MauriceTZ/Cafebot/pi/tests/datos/arbol_taller_29oct.jpg

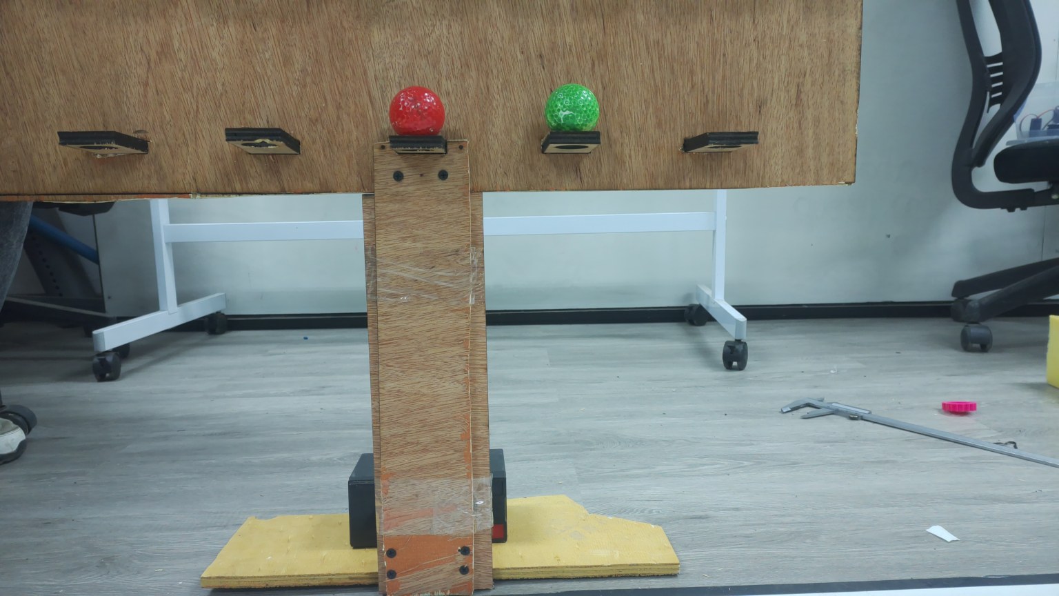
pi/tests/datos/arbol_taller_29oct.jpg
