MauriceTZ/Cafebot/docs/hardware.md

# Hardware

## Arquitectura

```
                 USB                         USB                  USB
 Arduino Mega ◄────────► Raspberry Pi 5 ◄──────────► LD06   ◄──────────► U2D2 ─► 6× XL430 (brazo)
  + shield 4M&9S          │  CSI: cámara                                (TTL,   + 2 compuertas (id 2, 13)  
  ├─ 4 motores + encoder  │  I2C: MPU9250 (usar giroscopio, no magnetómetro)   1 Mbps)
  ├─ 4 servos dirección   │  GPIO 16 (pin 36) + GND (pin 34): botón de inicio
  ├─ 1 inclinación de cámara (X 2; X 0 / X 1 quedaron libres: las compuertas son Dynamixel)
  └─ 4 sensores de línea QTR-1A (A8–A11)
```

| Pieza | Responsable | Notas |
|---|---|---|
| Mega | reflejos | PI por rueda, dirección, odometría, primitivas, freno por borde, watchdog. |
| Pi 5 | decisiones | Localización con mapa conocido, visión, brazo, misión, reloj de 8 min. |

## Botón de inicio (5 nov; antes GPIO 23)
GPIO 16 = **pin físico 36** del conector de 40 pines; el otro lado del botón a un **GND** (pin 34, justo al lado, o el
39). Sin resistencia: se usa el pull-up interno (suelto = 1, apretado = 0). Es un GPIO libre (no es I2C, SPI0 ni UART;
el MPU9250 usa los pines 3 y 5). La misión parte al SOLTAR el botón y descarta pulsos de menos de 50 ms (ruido de los
motores en el cable). Probarlo: `python3 -m tools.boton`. Necesita `python3-gpiozero` y `python3-lgpio` (vienen con
Raspberry Pi OS Bookworm; si no: `sudo apt install python3-gpiozero python3-lgpio`).

## Puertos USB en la Raspberry (vistos el 28 oct con `ls -l /dev/serial/by-id/`)

| Dispositivo | Chip USB | Sin reglas udev | Con `pi/system/99-cafebot.rules` |
|---|---|---|---|
| Arduino Mega (clon) | CH340 (`1a86`) | `/dev/ttyUSB1` | `/dev/cafebot-mega` |
| LD06 | CP2102 (`10c4`) | `/dev/ttyUSB0` | `/dev/cafebot-lidar` |
| U2D2 (brazo) | FTDI (`0403`) | otro `/dev/ttyUSB*` | `/dev/cafebot-u2d2` |

Los números `ttyUSB` dependen del orden en que se conectan: con las reglas instaladas no importa. Sin ellas (o si
un chip no calza con su regla), los drivers buscan el puerto por el fabricante del chip USB y avisan cuál usaron
(`cafebot/drivers/puertos.py`). 29 oct: no apareció `/dev/cafebot-u2d2` (la regla pedía el producto `6014`; ahora
basta el fabricante `0403`): reinstalar las reglas con
`sudo cp pi/system/99-cafebot.rules /etc/udev/rules.d/ && sudo udevadm control --reload && sudo udevadm trigger`.

## Raspberry nueva (o SD nueva)
31 oct: la SD murió. Lo que hay que hacer en una SD nueva (con Raspberry Pi OS **Bookworm o más nuevo**: la Pi 5 no
arranca con versiones anteriores; si la SD viene de una Pi 4, `sudo apt update && sudo apt full-upgrade` y reiniciar):
1. `git clone https://github.com/MauriceTZ/Cafebot ~/Cafebot`
2. `cd ~/Cafebot/pi && python3 -m venv --system-site-packages .venv && . .venv/bin/activate && pip install -r requirements.txt`
   (antes, con apt: `python3-numpy python3-scipy python3-opencv python3-picamera2 python3-pygame python3-smbus2`;
   numpy NO por pip: un numpy 2 en el venv rompe el cv2 de apt, 4 nov). Revisar
   `python3 -c "import numpy; print(numpy.__version__, numpy.__file__)"`: 1.x en `/usr/lib/python3/dist-packages`.
   El 4 nov el numpy 2 estaba en `~/.local/lib/python3.11/site-packages` (un `pip install --user` viejo, que se ve
   también desde el venv): borrar ahí `numpy*`, `scipy*`, `pygame*` y `opencv*`/`cv2`.
3. Reglas de los puertos: `sudo cp system/99-cafebot.rules /etc/udev/rules.d/ && sudo udevadm control --reload && sudo udevadm trigger`.
4. `sudo usermod -aG dialout $USER` y volver a entrar (sin eso no abre los puertos serie).
5. Comprobar: `rpicam-hello --list-cameras` (la cámara), `ls -l /dev/cafebot-*` (Mega, LiDAR y U2D2).
6. I2C en `raspi-config` solo si se usa el giroscopio.
La calibración que vive en la Pi (`pi/robot_local.json`, `pi/calibracion/`) se pierde con la SD: lo que quede bueno,
pasarlo a `config.py` o subirlo al repo. El perfil del brazo (`pi/brazos/`) ya está en el repo.
La Pi 5 necesita 5 V / 5 A: con menos (el 30 oct marcó 4,86 V y avisos de bajo voltaje) limita la corriente de los
USB y el LiDAR, el Mega o el U2D2 pueden desconectarse solos.

## Pines del Mega (`firmware/mega_cafebot/config.h`)

| Rueda | Ubicación (verificada) | Enc A | Enc B | PWM | DIR1 | DIR2 | Servo | Offset |
|---|---|---|---|---|---|---|---|---|
| M1 | delantera der | 18 | 31 | 12 | 34 | 35 | 6 | 89 |
| M2 | delantera izq | 19 | 38 | 8 | 37 | 36 | 10 | 87 |
| M3 | trasera der | 3 | 49 | 9 | 43 | 42 | 13 | 87 |
| M4 | trasera izq | 2 | A1 | 5 | A4 | A5 | 45 | 90 |

Sensores de línea: 4 × QTR-1A analógicos en **A8, A9, A10, A11** (DI, DD, TI, TD) por el conector *Analog IO*
del shield (S/V/G); **A1, A4 y A5 los usa el motor M4**: ver `docs/ir.md`. Cabezal de la cámara (31 oct): 2 × SG90,
**inclinación en el pin 44 (PL5)** = `X 2`, **giro en el pin 4 (PG5)** = `X 3` (desactivado en `AUX_ACTIVO`: falla).
Compuertas, por confirmar: 46 y 11 (`X 0`, `X 1`; en el modelo de Fusion son Dynamixel). Los pines 20/21 (SDA/SCL)
también tienen interrupción y están libres si no se usa I2C en el Mega.

## Geometría del modelo de Fusion (31 oct, `description/fusion/exportar_geometria.py`)
Sistema del robot: x adelante, y a la izquierda, z arriba, origen en el centro de la base sobre el suelo. Alturas
corregidas −0,57 cm porque el modelo tiene ruedas de 64 mm (las de verdad dan 52,6 mm). **[CONFIRMAR con huincha]**

| Qué | x | y | z | En la config |
|---|---|---|---|---|
| Lente de la cámara (X 2 = 90, mirando adelante) | 11,1 cm | −5,3 cm (derecha) | 36,7 cm | `camara.x/y/z` |
| Eje de inclinación de la cámara (SG90, horizontal) | 8,4 cm | | 36,9 cm | `camara.eje_pitch_x/z` |
| Eje de giro de la cámara (SG90, vertical) | 9,1 cm | −6,8 cm | | `camara.eje_yaw_x/y` |
| Eje de la base del brazo (placa de la base) | 7,65 cm | +6,3 cm (izquierda) | 31,3 cm en el modelo; **35,2 medido** (31 oct: garra horizontal a 70 cm con el brazo vertical) | `mision.brazo_x/y/z` |
| LiDAR | 15,75 cm | 0 | ~5 cm | `geometria.lidar_x/z` |

Si la base del brazo está 4 cm más alta que en el modelo porque la tapa de la base lo está, la cámara (montada en
la misma tapa) también: medir la altura del lente y corregir `camara.z` y `eje_pitch_z`.

Ojo con izquierda/derecha: en el modelo, la pieza "Compuerta trasera izquierda" queda del lado que con x adelante
es la DERECHA. Si en el robot la cámara está a la izquierda del brazo, cambiar el signo de `camara.y`, `eje_yaw_y` y
`mision.brazo_y`.

## Medidas de la base
Ruedas Ø53 mm, trocha 217 mm, entre ejes 223 mm, 800 pulsos/vuelta de rueda en el flanco
de subida de A (1600 con `ENCODER_X2`). Reductora 1:8.

## Checklist de puesta en marcha (ruedas en el aire)
1. **Encoders.** Escribir `ED` (pone en cero el diagnóstico), girar **cada rueda a mano exactamente 1 vuelta hacia adelante** y escribir `ED` otra vez. Para cada rueda se ve `subida/bajada`:
   - Ambos ≈ **+800** → cuadratura sana: se puede usar `EM 2` (doble resolución; queda guardado).
   - Ambos ≈ −800 → encoder invertido: cambiar `Mx_INV_ENC` en config.h.
   - Signos **opuestos** (p. ej. +800 / −800) → A y B no están desfasados 90° (o hay ruido/rebote en A): quedarse en `EM 1`. En x1 solo cuenta el flanco de subida, igual que v0.
   - Muy distinto de 800 → revisar `PULSOS_POR_REVOLUCION` o el cableado.
   Con las ruedas en el aire, `DONE` siempre muestra la distancia pedida: solo cuenta pulsos, no sabe cuánto avanzó de verdad. La prueba real es la vuelta a mano (o `A 1000` en el piso, con huincha).
2. `V 100 0` (repetir): las 4 ruedas hacia adelante. Si alguna va al revés, `Mx_INV_MOTOR`.
3. **Dirección, en este orden** (con las ruedas en el aire):
   1. **`L 45 200`** (no `L 90`: a ±90° una rueda girada a la izquierda y una girada a la derecha quedan en la misma línea y no se distinguen a simple vista). Vistas desde arriba (frente arriba), las 4 ruedas deben quedar **paralelas, con la punta delantera hacia la izquierda** ( \\ \\ ). La que quede en la otra diagonal ( / ) → cambiar su signo en `SIGNO_SERVO`. Si una rueda no responde como se espera, `Y i 1200` mueve solo el servo i (0 = M1 … 3 = M4) para comprobar qué rueda mueve cada pin. *No* usar `W 90` para esto.
   2. Anotar en `ESQUINA_X` / `ESQUINA_Y` dónde está físicamente M1…M4 (delantera/trasera, izquierda/derecha).
   3. `W 90`: las ruedas forman un **rombo** (cada una perpendicular a la línea hacia el centro) y el robot gira a la **izquierda** (antihorario visto desde arriba). Si quedan en X apuntando al centro → `SIGNO_GIRO -1`.
4. **Calibrar los servos de dirección (HS-311) en microsegundos** — corrige el desfase del estriado sin desarmar nada.
   Con teclado (6 nov): `python3 -m tools.direccion` (prueba +45°, invierte el sentido de una rueda con x, ajusta
   −90/0/+90 con las flechas y guarda en la EEPROM; sin subir firmware). A mano:
   - `Y` muestra la tabla actual (µs para -90°, 0°, +90° de M1..M4).
   - Para cada rueda `i` (0 = M1 … 3 = M4): `Y i 1450`, `Y i 1460`… hasta que quede **paralela al chasis** (usar una regla apoyada en el costado). Anotar el valor y fijarlo: `YS i 0 <us>`.
   - Igual para +90° (`YS i 1 <us>`) y -90° (`YS i -1 <us>`), con una escuadra contra el chasis.
   - Si un servo no llega a 90° exactos, calibrar las 4 a un ángulo menor **común** (p. ej. 88°, medido con transportador) y poner ese valor en `SERVO_ANG_CAL_DEG` (config.h): lo importante es que las 4 queden paralelas; la odometría usa el ángulo real.
   - `YG` guarda en EEPROM (sobrevive al apagado y a recargar el firmware). `YD` vuelve a los valores por defecto.
   - Después, `L 90 200`: las 4 ruedas quedan paralelas, rodando hacia la izquierda. Dos quedan a +90 y dos a −90
     (es a propósito: así el arrastre de las L de aluminio no hace girar la base; ver PASO 1b de `config.h`).
   - **Torque del cangrejo** (29 oct): desde recto, `L 90 50` y luego `L 0 50`, mirando si la base gira al
     reposicionarse las ruedas. Probar los patrones con `LE 1`, `LE 2`, `LE 3` (y `LE 0` = como antes, para
     comparar) y dejar en `CANGREJO_ESPEJO_DEF` el que no gire. Una marca en el piso junto a una esquina ayuda.
5. En el piso: `A 1000` + huincha → diámetro de rueda. `W 360` → `CINEMATICA_D_GIRO_Z`.
6. `J`: si oscila, bajar `kp`; si no llega a la velocidad, subir `kff` o `PWM_ARRANQUE`.

## LiDAR
Para ver **cajas (90 mm) y albercas (90 mm)** tiene que ir **por debajo de 90 mm**. Plan: al frente de la base, a ~8 cm, con ~180° de vista (`ConfigLD06.x_m = 0.16`, `fov_deg = 95`). Con solo 1 cm de margen, **montarlo nivelado**: 1° de inclinación hacia arriba sube el haz 5 cm a 3 m y deja de ver las cajas lejanas. Si se puede, 6 cm es más seguro.
Más arriba solo ve los árboles (y al público). Configurar su posición y orientación en
`ConfigLD06` (`pi/cafebot/drivers/ld06.py`).

## IMU
El magnetómetro no sirve cerca de motores y estructuras metálicas. Usar el giroscopio
(calibrar el sesgo con el robot quieto al inicio). Muchos "MPU9250" son clones MPU6500
sin magnetómetro.
