MauriceTZ/Cafebot/docs/cosecha.md

# Cosecha de prueba: cámara + LiDAR + brazo (`python3 -m tools.cosecha`, en `pi/`)

Robot quieto frente a UN árbol (puede avanzar y retroceder, y correrse de lado): la cámara encuentra las pelotas, el
LiDAR mide el pie del árbol, se calcula la posición 3D de cada grano y el brazo agarra el elegido (o el más cercano)
y lo deja en la canasta de su categoría.

Código: `pi/cafebot/vision/` — `camara_modelo.py` (cámara estenopeica completa: proyección y rayos), `arbol.py`
(forma del árbol y medida del pie con el LiDAR), `granos.py` (detección, ajuste, proyección inversa, color,
calibración), `sintetica.py` (fotos y LiDAR simulados). Herramienta: `pi/tools/cosecha.py`. Pruebas sin hardware:
`python3 -m tests.test_cosecha`.

## Cómo funciona (sin red neuronal: la escena es conocida)

1. **Detectar.** Píxeles saturados (madera 85–110 de saturación, pelotas 150–190; `camara.sat_min` = 130), manchas
   redondas. El soporte tapa la parte de abajo de cada pelota (la cámara está más abajo que los granos) y el brillo
   deja una muesca: el círculo se ajusta (RANSAC + ajuste geométrico) solo con los puntos del borde que están sobre la
   envolvente convexa y fuera de los tramos rectos. Error en fotos sintéticas: < 1 px en centro y radio, también
   en los casquetes de la fila alta.
2. **Asignar y ajustar.** Cada mancha va al soporte cuya proyección queda más cerca, y se ajustan por mínimos
   cuadrados la pose del árbol (x, y, ángulo) y una corrección de la cámara (inclinación, yaw, roll) con la medida
   del LiDAR como "prior": eso es la fusión cámara + LiDAR. Sin calibrar, la cámara puede corregirse ±3–4° (manda
   el LiDAR en lo que la foto no distingue, p. ej. árbol corrido vs cámara girada); calibrada, ±0,6°. Sin calibrar,
   antes se busca la inclinación en ±30° (y, sin LiDAR, la distancia en ±20 cm de `--frente`): si la cámara está
   montada a otro ángulo del que dice la config, lo avisa y usa el que calza ("la cámara está inclinada ~22°...").
3. **Proyección inversa.** Rayo de cada pelota ∩ plano vertical de los granos (`p_rayo`). La posición final de cada
   grano es la de su soporte en el árbol ajustado, corregida hacia lo que se vio de esa pelota (sirve para un árbol
   de prueba que no calza exacto con su modelo). Se guarda en el marco del ÁRBOL: si el robot se acerca, el LiDAR
   vuelve a ubicar el pie y con eso cada grano (de cerca la cámara ya no ve el árbol).
4. **Color.** En el círculo inscrito en lo que se ve de la pelota (lejos del soporte y del fondo). Con referencias
   (clic + tecla 1..7): Lab contra las muestras, el clasificador de Pablo, con "no sé". Sin referencias: por matiz,
   provisorio, con confianza 0,6 (menor que la de la misión, 0,7: no se agarra nada hasta enseñar los colores o
   bajar `--confianza`). Un soporte sin mancha de color es VACIO (sin referencias no se distingue de NEGRO).
5. **Brazo.** `BrazoXL430.recoger`: abrir → 6 cm antes → entrar → cerrar (si cierra del todo: no había grano) →
   subir → retroceder → canasta (`deposito_maduro` / `deposito_sobremaduro`) → abrir → espera. Con la postura
   `transporte` grabada, para ir y volver de la canasta primero se pliega sin girar la base, gira plegado y recién
   ahí se estira (no barre la cámara).

## Antes de la primera prueba

| Qué | Cómo |
|---|---|
| Cabezal de la cámara (31 oct) | La cámara va en un cabezal de 2 SG90: inclinación con `X 2` (pin 44), giro con `X 3` (desactivado: falla, mira adelante). Con el lente a ~37 cm y ~18° hacia arriba entran los 16 soportes desde 0,55–0,65 m (simulado). El modelo (`camara.cabezal`) mueve el lente con la inclinación alrededor del eje del servo. **Antes:** comprobar el sentido con `X 2 70` y `X 2 110` en la consola del Mega; si con 110 la cámara mira hacia ABAJO, poner `camara.pitch_por_grado` = −1 en `robot_local.json`. |
| Intrínsecos (recomendado) | `python3 -m tools.camara intrinseca --tablero 9x6 --cuadro 0.025` con un tablero de ajedrez impreso: debe dar fx ≈ 1183 a 1536×864. Si da ~1690, la cámara está en el modo recortado del sensor (el driver ahora pide el campo completo, `MODO_SENSOR`). |
| Medidas en `pi/robot_local.json` | `camara.x/y/z` (lente), `mision.brazo_x/y/z` (eje de la base del brazo; z = base sobre el suelo), `geometria.lidar_x`. |
| Árbol de prueba | `python3 -m tools.cosecha --arbol taller --crear-arbol` y editar `pi/arboles/taller.json` (abajo). |
| Brazo | Perfil calibrado (docs/brazo.md) y posturas `descanso`, `deposito_maduro`, `deposito_sobremaduro` y, opcional, `transporte` (`python3 -m tools.brazo leer`, tecla G). Si una canasta está justo detrás (180°), ampliar el límite de la base (`tools.brazo limites`): de fábrica es ±150°. |
| Exposición | `python3 -m tools.camara exposicion --dist 0.6` con la luz del lugar. |

## Sesión típica

| Paso | Tecla | Qué mirar |
|---|---|---|
| 1. Robot frente al árbol, el frente a ~60 cm del pie | | |
| 2. Medir | ESPACIO | Círculos sobre las pelotas, "error" < 2 px. Mensajes: "la foto y el LiDAR no coinciden", "OJO: calza igual corrido una columna". |
| 3. Calibrar la cámara | C | En 3–4 posiciones del robot (moverlo ±10 cm, ESPACIO + C cada vez): se promedia y se guarda en `robot_local.json`. Con el Mega conectado, hacer al menos una C con otro ángulo del servo (I o K 4–5 veces = 8–10°, ESPACIO + C): así se mide cuántos grados gira la cámara por grado de `X 2` y la misión puede pedir cualquier inclinación (`camara.servo_de_pitch`). I/K mueven el servo de a 2°; sin el Mega solo cambian el modelo. |
| 4. Enseñar colores | clic + 1..7 | Todas las clases, también NEGRO (6) y VACIO (7, un soporte sin grano). Se guardan en `pi/calibracion/referencias.json`. |
| 5. Acercarse | A | El frente queda a `mision.holgura_agarre_m` (6 cm) del pie; el LiDAR vuelve a ubicar el árbol. Sin Mega (`--sin-mega`), A, R y las flechas dicen cuánto mover el ÁRBOL a mano; después, **U** lo vuelve a ubicar con el LiDAR (sin foto, sirve de cerca): un error de 1,5 cm a mano serían 1,5 cm de error en cada grano. |
| 6. Probar sin agarrar | clic + P | La garra queda 6 cm antes del grano: ¿apunta a él? (V vuelve.) |
| 7. Agarrar | G / T | G: el elegido o el seguro y alcanzable más cercano. T: todos (fila alta primero). ESC detiene. |
| 8. Volver y revisar | R + ESPACIO | Los agarrados ya no están. S guarda fotos + análisis en `pi/capturas/`. |

Granos de los costados: ← / → corren el robot 2 cm de lado (cangrejo); el árbol se vuelve a ubicar solo.

**Calibración con el brazo (la más directa, opcional):** con la foto analizada y el brazo fuera de ella, O suelta el
brazo; llevar la garra a mano hasta un grano detectado, clic en ese grano y M; repetir con 4–8 granos en distintas
filas y columnas; N calcula la pose COMPLETA de la cámara (también la posición del lente) respecto del brazo. Así
los errores de montaje del LiDAR o de `brazo_x/y/z` no se suman: con la cámara calibrada con el brazo, lo que la foto
le corrige al LiDAR se sigue aplicando al acercarse (simulado: LiDAR corrido 1,5 cm, agarres a < 5 mm). Con C, en
cambio, la referencia es el LiDAR.

En la imagen: rojo = maduro, azul = sobremaduro, verde = verde, gris = vacío, amarillo = no sé (no se toca),
círculo blanco = mancha detectada y su zona de color, cruz magenta = mancha que no calza con ningún soporte,
"lejos" = el brazo no lo alcanza desde aquí. Abajo a la derecha, vista desde arriba (relleno = alcanzable).

## Alcance del brazo (cinemática del perfil de fábrica, árbol de competencia, robot centrado)

| Base del brazo | Holgura 6 cm: alta / media / baja |
|---|---|
| 25 cm (montaje del 29 oct) | ninguno / los 2 del centro / los 5 |
| 30–33 cm (31,3 cm según el modelo de Fusion, 31 oct) | ninguno / 4 del centro / los 5 |
| **35,2 cm (medido en el robot, 31 oct)** | ninguno (ni con holgura 3 cm) / 4 del centro / los 5 |
| 36 cm | solo el del centro (con holgura ≤ 4 cm) / 4 del centro / los 5 |
| 37 cm o más | el que está frente al brazo / 4 del centro / los 5 |

**Medida del 31 oct:** con el brazo vertical y la garra horizontal, la garra llega a 70 cm del suelo. Como del eje
de la base a la garra hay 6,71 + 10,7 + 10,7 + 6,7 = 34,8 cm, la base está a ~35,2 cm (el modelo de Fusion dice
31,3). La fila alta tiene el centro del grano a 70,7 cm: **la garra horizontal no llega ni justo encima de la base**,
y el grano está 10 cm más adelante, además de tener que levantarlo 1–2 cm para sacarlo del soporte. Con un
suplemento de ~2 cm (base a ≥ 37 cm) se alcanza la fila alta frente al brazo con la holgura de 6 cm; los de los
costados, corriéndose de lado (cangrejo, como `mision.estaciones_y`). Ojo con el cubo de 45 cm al partir: el brazo
plegado no puede subir más de ~8–10 cm sobre la base.

## Árbol de prueba (`pi/arboles/<nombre>.json`)

| Campo | Qué es |
|---|---|
| `z_cara` | Altura (m) de la cara de ARRIBA de los soportes de cada fila (`baja`, `media`, `alta`). |
| `columnas_y` | Posición lateral (m, + = izquierda vista desde el robot) de cada soporte, por fila. |
| `copa_y_m` | Corrimiento lateral de todos los soportes respecto del centro de lo que ve el LiDAR. |
| `grano_delante_m` | Cuánto está el centro de los granos DELANTE de la cara que ve el LiDAR (a 5 cm del suelo). Negativo si lo que ve el LiDAR (p. ej. la base con la batería) sobresale más que los granos. |
| `pie_ancho_m` | Ancho de lo que ve el LiDAR a esa altura (si no calza ±40 %, el centro lateral sale de la navegación). |
| `soporte_lado_m`, `soporte_espesor_m`, `centro_sobre_cara_m` | La placa de cada soporte (tapa la parte de abajo de la pelota) y el centro del grano sobre su cara. |
| `tablero_detras_m`, `tablero_ancho_m` | Solo para el dibujo sintético. |

## Sin robot

    python3 -m tools.cosecha --sim                               # árbol sintético; la cámara "real" tiene error de montaje
    python3 -m tools.cosecha --imagen foto.jpg --frente 0.63 --lateral 0.09   # foto guardada, pie puesto a mano
    python3 -m tools.cosecha --imagen foto.jpg --frente 0.63 --texto          # sin ventana

Con la foto del taller del 29 oct (`pi/tests/datos/arbol_taller_29oct.jpg`, cámara casi horizontal a ~63 cm): la
roja queda en `baja-3` (maduro) y la verde en `baja-4`, con 0,3 px de error; la rueda rosada del piso no calza con
ningún soporte. Sin el LiDAR (prior lateral ±5 cm) avisa que el árbol corrido una columna calza igual.

En simulación (`tests.test_cosecha`, cámara con 1–2° de error de montaje): error 3D de los granos desde la foto,
mediana 1,5–3 mm y máximo ~7 mm (sin calibrar, gracias al LiDAR; calibrada, igual o mejor); después de acercarse,
errores de agarre < 2 mm; cada grano a la canasta de su categoría; ESC detiene la secuencia. Tan cerca del árbol
(A) no se saca foto: lo medido de lejos sigue valiendo (y lo que queda fuera de una foto parcial, también).
