MauriceTZ/Cafebot/description/brazo1_description/meshes/base_link.stl

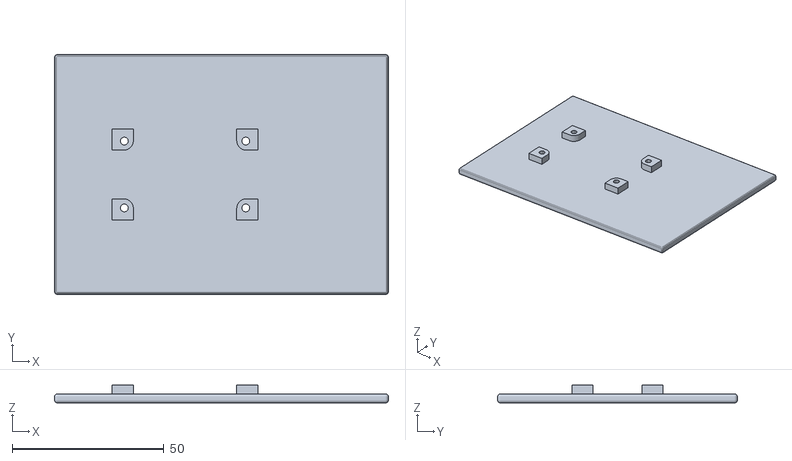
[picture p2: CAD file, 2026-10-27]
description/brazo1_description/meshes/base_link.stl
110.0 x 79.0 x 5.90
