MauriceTZ/Cafebot/description/brazo1_description/meshes/muneca_1.stl

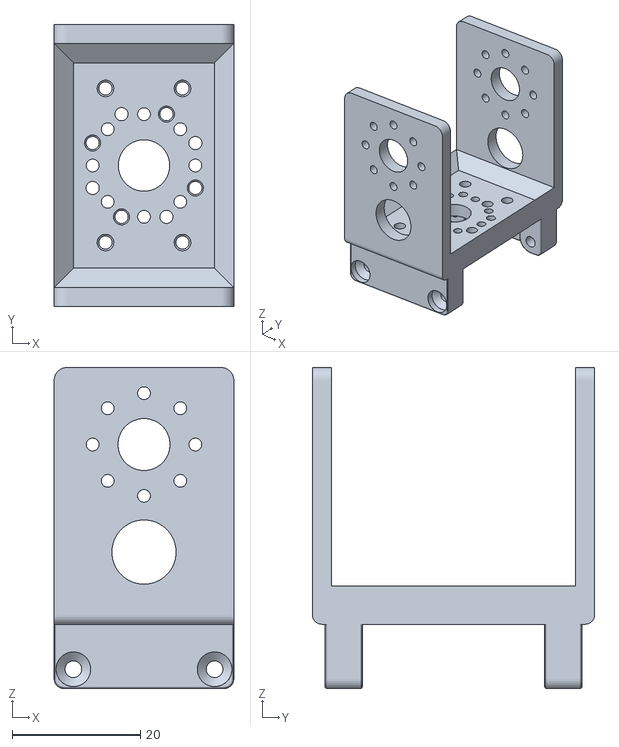
[picture p3: CAD file, 2026-10-27]
description/brazo1_description/meshes/muneca_1.stl
28.0 x 44.0 x 50.0
