MauriceTZ/Cafebot/description/brazo1_description/meshes/codo1_1.stl

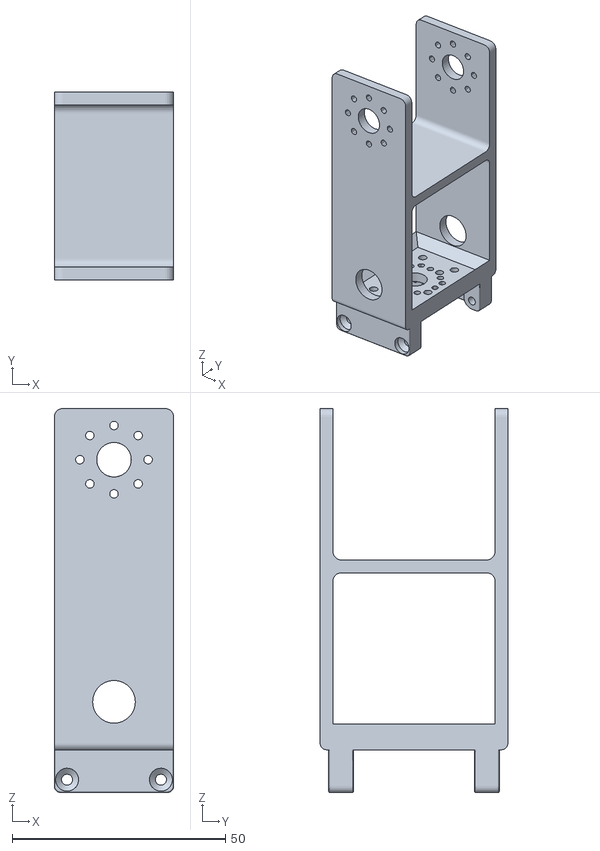
[picture p6: CAD file, 2026-10-27]
description/brazo1_description/meshes/codo1_1.stl
28.0 x 44.0 x 90.0
