MauriceTZ/Cafebot/description/brazo1_description/meshes/garra_1.stl

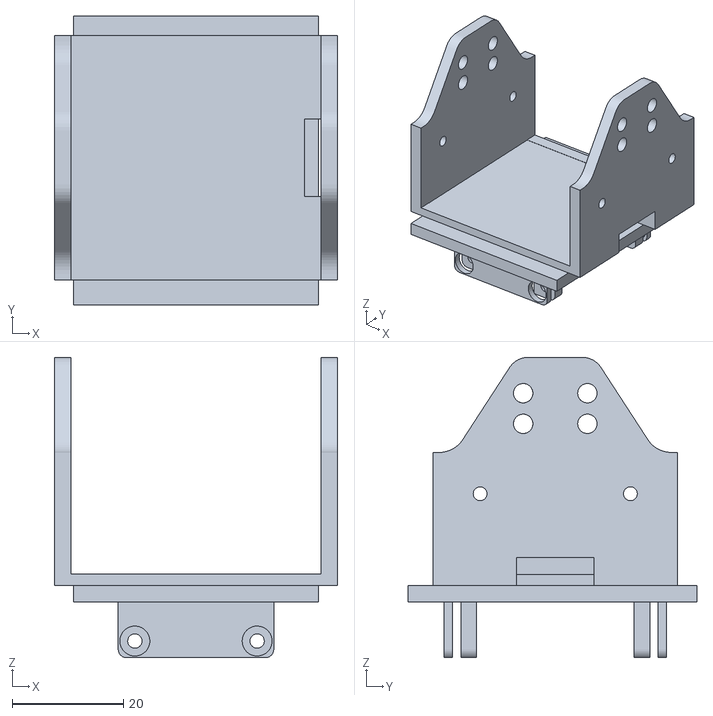
[picture p7: CAD file, 2026-10-27]
description/brazo1_description/meshes/garra_1.stl
51.0 x 52.0 x 54.1
