MauriceTZ/Cafebot/description/brazo1_description/meshes/servo_codo_1.stl

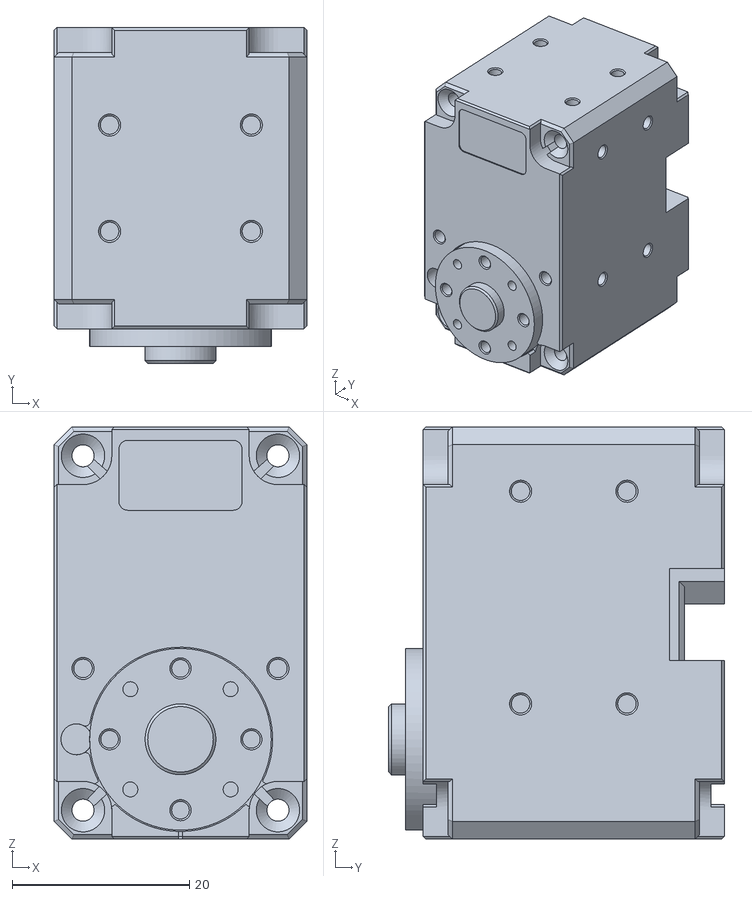
[picture p8: CAD file, 2026-10-27]
description/brazo1_description/meshes/servo_codo_1.stl
28.5 x 37.9 x 46.5
