MauriceTZ/Cafebot/(list of files, cad)

Other CAD files:
description/brazo1_description/meshes/codo_1.stl
description/brazo1_description/meshes/servo_codo1_1.stl
description/brazo1_description/meshes/codo2_1.stl
description/brazo1_description/meshes/servo_codo2_1.stl
description/brazo1_description/meshes/servo_base_1.stl
description/brazo1_description/meshes/servo_muneca_1.stl
legacy/codigo_brazo/brazo1_description/brazo1_description/meshes/servo_codo1_1.stl
legacy/codigo_brazo/brazo1_description/brazo1_description/meshes/codo2_1.stl
legacy/codigo_brazo/brazo1_description/brazo1_description/meshes/servo_base_1.stl
legacy/codigo_brazo/brazo1_description/brazo1_description/meshes/codo_1.stl
legacy/codigo_brazo/brazo1_description/brazo1_description/meshes/servo_codo2_1.stl
legacy/codigo_brazo/brazo1_description/brazo1_description/meshes/servo_muneca_1.stl
