MauriceTZ/Cafebot/description/brazo1_description/launch/controller.yaml

brazo1_controller:
  # Publish all joint states -----------------------------------
  joint_state_controller:
    type: joint_state_controller/JointStateController
    publish_rate: 50

  # Position Controllers --------------------------------------
  Revolute 4_position_controller:
    type: effort_controllers/JointPositionController
    joint: Revolute 4
    pid: {p: 100.0, i: 0.01, d: 10.0}
  Revolute 5_position_controller:
    type: effort_controllers/JointPositionController
    joint: Revolute 5
    pid: {p: 100.0, i: 0.01, d: 10.0}
  Revolute 16_position_controller:
    type: effort_controllers/JointPositionController
    joint: Revolute 16
    pid: {p: 100.0, i: 0.01, d: 10.0}
  Revolute 18_position_controller:
    type: effort_controllers/JointPositionController
    joint: Revolute 18
    pid: {p: 100.0, i: 0.01, d: 10.0}
  Revolute 38_position_controller:
    type: effort_controllers/JointPositionController
    joint: Revolute 38
    pid: {p: 100.0, i: 0.01, d: 10.0}
