MauriceTZ/Cafebot/pi/cafebot/vision/camara.py

"""Cámara (Pi Camera Module 3) con foco, exposición y balance de blancos FIJOS.
(Portado de legacy/vision_pablo/camara.py, de Pablo; ajustes guardados en pi/calibracion/camara.json.
Lo normal es usarla con python3 -m tools.camara.)

Con todo en automático, el mismo grano cambia de color entre fotos (la cámara
se ajusta según el fondo). Para clasificar por color hay que congelar todo:
  1. Foco manual: LensPosition = 1 / distancia_en_metros.
  2. Se deja que el automático se estabilice unos segundos, se leen la
     exposición, la ganancia y el balance de blancos, y se fijan.
  3. Esos valores se guardan en calibracion/camara.json y se reutilizan.

Uso en la Pi:
  python3 camara.py --calibrar --dist 0.25        # fija y guarda los ajustes
  python3 camara.py --foto pelotas --n 3          # 3 fotos con los ajustes guardados
  python3 camara.py --foto pelotas --auto         # foto en automático (comparar)
"""
from __future__ import annotations

import argparse
import json
import os
import threading
import time

# Silenciar los mensajes INFO/WARN de libcamera (solo mostrar errores).
os.environ.setdefault("LIBCAMERA_LOG_LEVELS", "*:ERROR")

RAIZ_PI = os.path.dirname(os.path.dirname(os.path.dirname(os.path.abspath(__file__))))
ARCHIVO_AJUSTES = os.path.join(RAIZ_PI, "calibracion", "camara.json")
CARPETA_CAPTURAS = os.path.join(RAIZ_PI, "capturas")
RESOLUCION = (1536, 864)
# Modo del sensor (IMX708): 2304×1296 = binning 2×2 de TODO el sensor (campo de 66° × 41°). Sin pedirlo, para una
# salida de 1536×864 libcamera elige el modo 1536×864, que es un RECORTE del centro (3072×1728): campo de ~49° × 29° y
# una distancia focal 1,43 veces mayor (fx ≈ 1690 en vez de 1183): la proyección de los soportes no calzaría.
MODO_SENSOR = (2304, 1296)


class Camara:
    def __init__(self, dist_m: float = 0.25):
        from picamera2 import Picamera2  # solo existe en la Pi
        from libcamera import controls
        self._controls = controls
        self.cam = Picamera2()
        try:
            config = self.cam.create_still_configuration(
                main={"size": RESOLUCION, "format": "RGB888"},  # OpenCV lo recibe como BGR
                raw={"size": MODO_SENSOR})                      # campo completo (ver MODO_SENSOR)
        except Exception:
            config = self.cam.create_still_configuration(main={"size": RESOLUCION, "format": "RGB888"})
        self.cam.configure(config)
        self.cam.start()
        self.enfocar(dist_m)
        self.recorte = None
        try:
            self.recorte = tuple(self.cam.capture_metadata().get("ScalerCrop", ()))   # (x, y, ancho, alto) del sensor
            if self.recorte and self.recorte[2] < 4000:
                print(f"[cámara] OJO: la imagen usa solo {self.recorte[2]}×{self.recorte[3]} px del sensor (campo "
                      "reducido): fx no es 1183. Calibrar con python3 -m tools.camara intrinseca")
        except Exception:
            pass

    def enfocar(self, dist_m: float):
        self.cam.set_controls({"AfMode": self._controls.AfModeEnum.Manual,
                               "LensPosition": 1.0 / max(dist_m, 0.05)})

    def bloquear_auto(self, espera_s: float = 2.0) -> dict:
        """Deja estabilizar el automático y congela sus valores."""
        self.cam.set_controls({"AeEnable": True, "AwbEnable": True})
        time.sleep(espera_s)
        meta = self.cam.capture_metadata()
        ajustes = {
            "ExposureTime": int(meta["ExposureTime"]),
            "AnalogueGain": float(meta["AnalogueGain"]),
            "ColourGains": [float(g) for g in meta["ColourGains"]],
        }
        self.aplicar(ajustes)
        return ajustes

    def aplicar(self, ajustes: dict):
        self.cam.set_controls({
            "AeEnable": False, "AwbEnable": False,
            "ExposureTime": ajustes["ExposureTime"],
            "AnalogueGain": ajustes["AnalogueGain"],
            "ColourGains": tuple(ajustes["ColourGains"]),
        })
        time.sleep(0.5)  # unos cuadros para que se apliquen

    def capturar(self):
        """Imagen BGR (numpy) lista para OpenCV."""
        return self.cam.capture_array("main")

    def cerrar(self):
        self.cam.stop()
        self.cam.close()


class CamaraArchivo:
    """Misma interfaz que Camara, pero devuelve fotos ya tomadas (pruebas en el PC)."""

    def __init__(self, rutas):
        import cv2
        self.imagenes = [cv2.imread(r) for r in ([rutas] if isinstance(rutas, str) else rutas)]
        if any(i is None for i in self.imagenes):
            raise FileNotFoundError(f"no se pudo leer {rutas}")
        self.i = 0

    def enfocar(self, dist_m):
        pass

    def aplicar(self, ajustes):
        pass

    def bloquear_auto(self, espera_s=0.0):
        return {}

    def capturar(self):
        img = self.imagenes[self.i % len(self.imagenes)]
        self.i += 1
        return img.copy()

    def cerrar(self):
        pass


def abrir_para_mision(log=print, dist_por_defecto: float = 0.6) -> Camara:
    """La cámara como la usa la misión: con la exposición y el balance de blancos guardados (tools.camara
    exposicion), o fijados ahora si no hay."""
    aj = cargar_ajustes()
    cam = Camara((aj or {}).get("dist_m", dist_por_defecto))
    if aj:
        cam.aplicar(aj)
    else:
        log("[visión] sin ajustes de exposición guardados: se fijan ahora (python3 -m tools.camara exposicion)")
        cam.bloquear_auto()
    return cam


class CamaraCompartida:
    """UNA cámara para la misión y la vista en vivo de la interfaz (libcamera no deja abrirla dos veces).
    Misma interfaz que Camara. Se abre la primera vez que se usa (abrir() puede tardar ~2 s); las capturas van de a
    una, y `reciente()` da la última foto si es nueva (la vista no le quita fotos a la misión)."""

    def __init__(self, abrir):
        self._abrir = abrir
        self._cam = None
        self._lock = threading.RLock()
        self.error = ""
        self.ultima = None
        self.t_ultima = 0.0

    @property
    def abierta(self) -> bool:
        return self._cam is not None

    def _camara(self):
        with self._lock:
            if self._cam is None:
                try:
                    self._cam = self._abrir()
                    self.error = ""
                except Exception as e:
                    self.error = f"{type(e).__name__}: {e}"
                    raise
            return self._cam

    def capturar(self):
        with self._lock:
            img = self._camara().capturar()
            self.ultima, self.t_ultima = img, time.monotonic()
            return img

    def reciente(self, max_edad_s: float = 0.25):
        """La última foto si tiene menos de max_edad_s; si no, una nueva."""
        img, t = self.ultima, self.t_ultima
        if img is not None and time.monotonic() - t < max_edad_s:
            return img
        return self.capturar()

    def enfocar(self, dist_m):
        with self._lock:
            self._camara().enfocar(dist_m)

    def aplicar(self, ajustes):
        with self._lock:
            self._camara().aplicar(ajustes)

    def bloquear_auto(self, espera_s: float = 2.0):
        with self._lock:
            return self._camara().bloquear_auto(espera_s)

    def cerrar(self):
        with self._lock:
            if self._cam is not None:
                try:
                    self._cam.cerrar()
                finally:
                    self._cam = None


def guardar_ajustes(ajustes: dict, dist_m: float):
    os.makedirs(os.path.dirname(ARCHIVO_AJUSTES), exist_ok=True)
    with open(ARCHIVO_AJUSTES, "w", encoding="utf-8") as f:
        json.dump({**ajustes, "dist_m": dist_m}, f, indent=2)


def cargar_ajustes():
    if not os.path.exists(ARCHIVO_AJUSTES):
        return None
    with open(ARCHIVO_AJUSTES, encoding="utf-8") as f:
        return json.load(f)


def main():
    import cv2
    p = argparse.ArgumentParser(description=__doc__,
                                formatter_class=argparse.RawDescriptionHelpFormatter)
    p.add_argument("--calibrar", action="store_true", help="fijar y guardar exposición/balance")
    p.add_argument("--dist", type=float, default=None, help="distancia de enfoque en metros")
    p.add_argument("--foto", default=None, help="nombre base de las fotos a guardar")
    p.add_argument("--n", type=int, default=1, help="cantidad de fotos")
    p.add_argument("--auto", action="store_true", help="no fijar nada (para comparar)")
    args = p.parse_args()

    guardados = cargar_ajustes()
    dist = args.dist or (guardados or {}).get("dist_m", 0.25)
    cam = Camara(dist)
    try:
        if args.calibrar:
            ajustes = cam.bloquear_auto()
            guardar_ajustes(ajustes, dist)
            print(f"Ajustes fijados y guardados en {ARCHIVO_AJUSTES}: {ajustes}")
        elif args.auto:
            time.sleep(2.0)
            print("Modo automático (sin fijar)")
        elif guardados:
            cam.aplicar(guardados)
            print(f"Usando ajustes guardados: {guardados}")
        else:
            print("[AVISO] No hay ajustes guardados: se fijan ahora (usa --calibrar para guardarlos).")
            cam.bloquear_auto()

        if args.foto:
            os.makedirs(CARPETA_CAPTURAS, exist_ok=True)
            marca = time.strftime("%Y%m%d_%H%M%S")
            for i in range(args.n):
                ruta = os.path.join(CARPETA_CAPTURAS, f"{args.foto}_{marca}_{i + 1}.jpg")
                cv2.imwrite(ruta, cam.capturar())
                print("Guardada:", ruta)
                time.sleep(0.3)
    finally:
        cam.cerrar()


if __name__ == "__main__":
    main()
