MauriceTZ/Cafebot/pi/cafebot/config.py

"""Configuración del robot en UN solo lugar (lado Raspberry).

Sistema del robot: origen en el centro de la base, x hacia ADELANTE, y hacia la IZQUIERDA,
ángulos antihorarios. Medidas en metros. Lo marcado [MEDIR] hay que confirmarlo en el robot.

Para cambiar algo sin tocar el código: crear pi/robot_local.json con las claves a cambiar, p. ej.
    {"geometria": {"lidar_x": 0.17, "extras": [[0.12, 0.0, 0.05, 0.05]]},
     "puertos": {"mega": "/dev/ttyUSB1", "lidar": "/dev/ttyUSB0"}}
"""
from __future__ import annotations

import json
import math
import pathlib
from dataclasses import asdict, dataclass, field

from cafebot.drivers.ld06 import ConfigLD06


@dataclass
class GeometriaRobot:
    largo: float = 0.30            # base, a lo largo de x
    ancho: float = 0.23            # base, a lo largo de y
    margen: float = 0.03           # holgura del filtro de huella (cables, ruedas, vibración)
    lidar_x: float = 0.1575        # LD06 al frente, por FUERA de la base, centrado. 31 oct: modelo de Fusion
    lidar_z: float = 0.05          # 29 oct: a ~5 cm del suelo, confirmado (solo informativo)
    lidar_y: float = 0.0
    lidar_yaw_deg: float = 0.0     # hacia dónde mira el 0° del LD06 (0 = adelante)    [MEDIR]
    lidar_fov_deg: float = 95.0    # vista útil ±fov respecto del frente del LD06
    # Rectángulos extra que el LiDAR ve del propio robot (cx, cy, semiancho_x, semiancho_y):
    # p. ej. el brazo plegado o una rueda que asoma. Se dibujan en azul en la interfaz.
    extras: list = field(default_factory=list)
    # El LiDAR ve su propia base: se borra un CUADRADO de este lado DETRÁS del LiDAR, centrado en él (el robot
    # no puede medir más de 450 mm por lado según el reglamento). 0 = solo la huella de la base (+ margen).
    lidar_caja_m: float = 0.45

    @property
    def radio(self) -> float:
        """Radio del círculo que envuelve la base: lo usa el planificador."""
        return math.hypot(self.largo / 2, self.ancho / 2)

    def huella(self) -> tuple[tuple[float, float], tuple[float, float]]:
        """Rectángulo (sistema del robot) donde todo lo que ve el LiDAR es el propio robot: la base + margen y,
        si lidar_caja_m > 0, el cuadrado de 45 cm detrás del LiDAR (lo que el robot puede llegar a medir)."""
        hx, hy = self.largo / 2 + self.margen, self.ancho / 2 + self.margen
        x0, x1, y0, y1 = -hx, hx, -hy, hy
        if self.lidar_caja_m > 0:
            # adelante, solo hasta 1 cm delante del LiDAR (no el margen de la base: el LiDAR va por fuera de ella)
            x0, x1 = min(x0, self.lidar_x - self.lidar_caja_m), max(self.largo / 2, self.lidar_x + 0.01)
            y0, y1 = min(y0, self.lidar_y - self.lidar_caja_m / 2), max(y1, self.lidar_y + self.lidar_caja_m / 2)
        return (x0, x1), (y0, y1)

    def config_ld06(self) -> ConfigLD06:
        hx, hy = self.huella()
        return ConfigLD06(x_m=self.lidar_x, y_m=self.lidar_y, yaw_deg=self.lidar_yaw_deg,
                          fov_deg=self.lidar_fov_deg, huella_x_m=hx, huella_y_m=hy,
                          extras=[tuple(e) for e in self.extras])


@dataclass
class Puertos:
    mega: str = "/dev/cafebot-mega"     # sin reglas udev: /dev/ttyUSB1 (nuestro Mega es un clon con CH340)
    lidar: str = "/dev/cafebot-lidar"   # sin reglas udev: /dev/ttyUSB0
    u2d2: str = "/dev/cafebot-u2d2"
    imu_bus: int = 1
    imu_dir: int = 0x68


@dataclass
class ConfigNavegacion:
    mapa_lado_m: float = 10.0      # el mapa del SLAM (la cancha mide 3,6 x 3,0)
    mapa_res_m: float = 0.04
    plan_res_m: float = 0.08
    margen_obstaculos_m: float = 0.05  # distancia mínima libre entre la base y un obstáculo (albercas: no tocar)
    seguridad_m: float = 0.10      # además, rutas que se alejan de los obstáculos cuando pueden
    vel_mm_s: float = 150.0        # velocidad de los tramos rectos
    tramo_max_m: float = 0.50      # largo máx. de cada tramo: después se corrige con el SLAM
    tol_llegada_m: float = 0.04
    tol_rumbo_deg: float = 3.0     # bajo esto no se gira antes de avanzar
    distancia_aprox_m: float = 0.25  # holgura entre el frente del robot y el árbol al aproximarse


@dataclass
class ConfigIR:
    """Sensores de línea: 4 × QTR-1A en A8..A11 del Mega. Orden fijo DI, DD, TI, TD (= bits 0..3).
    Calibración y prueba: `python3 -m tools.ir` (docs/ir.md)."""
    nombres: tuple = ("DI", "DD", "TI", "TD")
    # Punto del piso que mira cada sensor, en el sistema del robot (x adelante, y izquierda), en metros.
    # 29 oct: van en las 4 esquinas, a 45°, junto a cada rueda -> se toma el centro de cada rueda
    # (firmware: CINEMATICA_L = 223 mm entre ejes, CINEMATICA_W = 217 mm entre ruedas). Si el punto que mira
    # el sensor queda corrido de la rueda, medirlo y ponerlo en robot_local.json.            [MEDIR]
    posiciones: tuple = ((0.1115, 0.1085), (0.1115, -0.1085), (-0.1115, 0.1085), (-0.1115, -0.1085))
    # ---- UMBRALES ------------------------------------------------------------------------------
    # Cuentas del ADC del Mega (0..1023). NEGRO si la lectura pasa umbral + histéresis/2.
    # None = usar los guardados en la EEPROM del Mega. Con valores, tools.navegacion / tools.mision se
    # los envían al Mega al conectar (así quedan en el repo). `tools.ir` los guarda aquí al calibrar.
    umbrales: tuple | None = (727, 926, 659, 715)   # DI DD TI TD: 30 oct, `tools.ir` (la SD de la Pi murió: copiados
    histeresis: int | None = 60                     # de docs/calibracion_brazo.md; también están en la EEPROM del Mega)
    # ---- Uso en la navegación ----
    ancho_linea_m: float = 0.019
    asociar_m: float = 0.05        # distancia máx. de un cruce a una línea conocida de la cancha
    corregir_pose: bool = False    # corregir el EKF con los cruces asociados (activar tras validarlo)
    sigma_m: float = 0.008         # incertidumbre de la posición de un cruce


@dataclass
class ConfigMision:
    nivel: int = 2                 # 1 = granos dentro del robot | 2 = + entregar | 3 = + sobremaduros y más árboles
    duracion_s: float = 480.0      # ronda de 8 min
    margen_final_s: float = 12.0   # detenerse antes del final por si acaso
    max_arboles: int = 1           # nivel 3 usa hasta 3
    max_granos: int = 0            # PRUEBAS: terminar después de recoger tantos granos (0 = sin límite; --max-granos)
    # PRUEBAS en una cancha REDUCIDA (5 nov: 90 x 60 cm, el árbol en un lado corto): sin la ubicación con el mapa de
    # la cancha; el robot parte mirando al árbol y el LiDAR mide su pie al partir (--reducida). Se hace como si fuera
    # el árbol 2 de la cancha. reducida_dist_m: frente del robot -> cara del pie, si el LiDAR no lo ve (0 = abortar)
    reducida: bool = False
    reducida_dist_m: float = 0.0
    recoger: tuple = ("MADURO",)   # nivel 3 agrega "SOBREMADURO"
    # 6 nov: cómo se cosecha frente al árbol.
    #   "soportes"  lo de antes: VisionCamara + modelo de cámara, estaciones laterales y la IK de cada grano
    #   "pisos"     el brazo como ASCENSOR (tools.ascensor, docs/ascensor.md): la foto dice qué pelota hay en cada piso,
    #               la línea del árbol la distancia, y las poses del brazo son las calibradas con tools.calibrar_cosecha
    #               (tools.mision --cosecha pisos)
    cosecha: str = "soportes"
    confianza_min: float = 0.70    # bajo esto la visión cuenta como NO_SE (no tocar)
    # Brazo: eje de giro de la base en el sistema del robot; z = altura de la BASE del brazo sobre
    # el SUELO (el hombro está 6,7 cm más arriba). Se comprueba con `tools.brazo leer`.        [MEDIR]
    # 31 oct, modelo de Fusion (OPEN_CAFEBOT): eje de la base 7,65 cm delante del centro y 6,34 cm a la IZQUIERDA.
    # Altura: el modelo pone la placa de la base a 31,3 cm (31,9 con sus ruedas de 64 mm), pero en el robot (31 oct)
    # la garra HORIZONTAL con el brazo vertical llega a 70 cm del suelo -> base = 70 − (6,71 + 10,7 + 10,7 + 6,7) =
    # 35,2 cm. Con eso la fila alta (70,7 cm) queda justo fuera: hace falta ~37 cm (docs/cosecha.md).
    #                                                  [CONFIRMAR: eje del hombro (id 8) a ~41,9 cm del suelo]
    brazo_x: float = 0.0765
    brazo_y: float = 0.0634
    brazo_z: float = 0.352
    # Árbol: distancias entre el FRENTE del robot y la cara del tablero
    distancia_foto_m: float = 0.55     # para la foto de los 16 soportes (la cámara se centra en el árbol). Con la
                                       # cámara en el cabezal a ~37 cm del suelo e inclinada 15–20°: 16/16 desde
                                       # 55–65 cm (simulado, 31 oct; con la de 25 cm hacían falta 25–32°).
                                       # Más lejos el robot quedaría encima de una alberca detrás.  [AJUSTAR]
    desplazamiento_foto_m: float = 0.10  # si algún soporte queda fuera de la foto: cangrejo y otra foto
    holgura_agarre_m: float = 0.06     # para recoger: con la base del brazo a 36 cm, a 8 cm la fila alta ya no
                                       # se alcanza (docs/brazo.md). Nada del robot sobre 38 cm en el frente. [AJUSTAR]
    holguras_agarre_m: tuple = (0.06, 0.12, 0.16)   # si un grano no se alcanza desde aquí, otras distancias a probar:
                                       # 31 oct, con los límites del brazo de Pablo y la base a 35,2 cm, la fila baja
                                       # pide ≥ 12 cm (se pliega demasiado) y la alta, ≤ 8 cm (si la base sube a 37)
    estaciones_y: tuple = (0.24, 0.12, 0.0, -0.12, -0.24)   # posiciones laterales del brazo frente al árbol
    # Línea del cultivo (4 nov): entre el robot y el árbol, a ARBOL_X_FRENTE − CULTIVO_X0 ≈ 11,9 cm de la cara del
    # tablero (borde cercano de la línea; reglamento: el tablero a 10 cm de la línea) [MEDIR en la cancha]. Al
    # acercarse, los sensores DELANTEROS (DI/DD) la tocan: con los dos cruces salen la distancia y el rumbo exactos,
    # el robot se endereza y desde ahí la x y el rumbo salen de la línea + la odometría (de cerca el LiDAR es menos
    # preciso); el LiDAR sigue dando la posición lateral del árbol. Sin ver la línea, sigue solo con el LiDAR.
    linea_cultivo: bool = True
    linea_por_estacion: bool = True        # repetirlo después de cada cangrejo (corrige lo que gira o deriva)
    linea_max_correccion_m: float = 0.10   # si la línea dice algo más distinto que esto (o > 10°), no se usa
    orden_filas: tuple = ("alta", "media", "baja")
    camara_arbol_deg: float = 25.0     # OBSOLETO (31 oct): el ángulo del servo (X 2) sale de camara.inclinacion_arbol_deg
    camara_cajas_deg: float = 0.0      # OBSOLETO: ídem con camara.inclinacion_cajas_deg (ConfigCamara.servo_de_pitch)
    # Color de las cajas: la cámara mira adelante, así que antes de entregar se para frente a una caja
    x_vista_cajas: float = 1.25        # centro del robot, mirando hacia el beneficiadero (θ = 180°)
    # Cómo saber cuál caja es cuál. El reglamento dice una ROJA (maduros) y una AZUL (sobremaduros), pero el 4 nov
    # en la competencia las dos canastas se ven ROJAS.          [CONFIRMAR con los jueces cómo se distingue la azul]
    #   "colores"  la cámara mira una caja y la otra es del otro color (si en verdad son iguales, esto ya es apostar)
    #   "cercana"  las dos iguales: maduros a la más cercana al volver, sobremaduros a la otra (apuesta al 50 %)
    #   "guardar"  las dos iguales: no se entrega, los granos quedan en el robot (+3 / +1 seguros, sin el viaje)
    # Se cambia entre rondas en robot_local.json o con --cajas (tools.mision, tools.navegacion). docs/mision.md
    cajas: str = "colores"
    # Entrega (de reversa: las compuertas están atrás)
    x_aproximacion_entrega: float = 0.95   # centro del robot antes de retroceder (cancha, m)
    x_entrega: float = 0.77               # centro del robot al abrir: atrás queda ~2 cm de la caja   [AJUSTAR]
    salida_x: float = -0.21               # dónde caen los granos, en el sistema del robot           [MEDIR]
                                          # (la rampa debe sobresalir ~5 cm por detrás: con la salida justo en
                                          #  el borde trasero, 1 cm de error de pose deja los granos fuera, −7 c/u)
    compuerta_abierta_deg: tuple = (90.0, 90.0)   # solo con compuertas.tipo = "mega": X 0 / X 1 (0..180)
    compuerta_cerrada_deg: tuple = (0.0, 0.0)     # (las Dynamixel usan la sección `compuertas`)
    t_vaciado_s: float = 2.5
    freno_ir: bool = False         # IS 1 durante la misión (cuando los IR estén integrados)
    # Botón de inicio (5 nov): GPIO 16 = pin físico 36 del conector de la Pi, entre él y un GND (pin 34 o 39), con el
    # pull-up interno: suelto = alto, apretado = bajo. La misión parte al SOLTARLO.
    pin_boton: int = 16            # numeración BCM (la de gpiozero)


@dataclass
class ConfigCompuertas:
    """Compuertas de los depósitos. 4 nov: son Dynamixel en el bus del brazo (U2D2), id 2 = maduros e id 13 =
    sobremaduros. Ángulos en GRADOS DEL SERVO, 0..360 (180° = 2048 pasos), como los muestra
    `python3 -m tools.compuertas leer`. None = sin calibrar: esa compuerta no se mueve (sus granos quedan en el
    robot, +3 / +1). Calibrar con tools.compuertas (docs/mision.md) y copiar aquí lo que grabe en robot_local.json."""
    tipo: str = "dxl"                  # "dxl" | "mega" (servos X 0 / X 1 del Mega, mision.compuerta_*_deg)
    ids: tuple = (2, 13)               # maduros, sobremaduros (4 nov noche: servos cambiados, la de maduros
                                       # quedó en el id 2; antes 12). Si salen cruzadas: (13, 2)
    # 4 nov noche, tools.compuertas calibrar con los servos nuevos (a mano); la prueba con torque abrió y cerró
    # bien las dos (lo de "no llegó" era la lectura, hecha antes de que se movieran: arreglado 5 nov).
    abierta_deg: tuple = (185.7, 81.9)
    cerrada_deg: tuple = (271.1, 3.3)
    limites_deg: tuple = ((180.7, 276.1), (0.0, 86.9))  # (mín, máx): se graban en el servo y no pasa de ahí
    pwm_limit: int = 450               # ~50 %: si algo traba la compuerta, no se calienta empujando    [AJUSTAR]
    t_mov_s: float = 0.6               # duración de cada movimiento (abrir / cerrar)


@dataclass
class ConfigBrazo:
    """Brazo real (cafebot/arm/brazo.py). La posición de su base está en ConfigMision (brazo_x/y/z).
    Ids, ceros, sentidos, límites y posturas de cada brazo: su PERFIL, pi/brazos/<perfil>.json (tools.brazo)."""
    perfil: str = "principal"      # qué brazo usa la misión (pi/brazos/principal.json)
    yaw0_deg: float = 0.0          # corrección extra de la base; con `tools.brazo cero` (base mirando adelante) = 0
    yaw_signo: int = 1             # ídem: el sentido de la base lo fija `tools.brazo verificar` en el perfil
    garra_largo_m: float = 0.032   # eje de la muñeca -> centro de los dedos cerrados                    [MEDIR]
    garra_abierta_deg: float = 0.0     # 30 oct (Pablo, a mano): abierta −3,6°, con pelota +42,3°, cerrada +46,1°
    garra_cerrada_deg: float = 50.0    # (con la garra invertida en el perfil; antes 65 iba contra el tope de abrir)
    garra_vacia_deg: float = 44.0  # si al cerrar la garra pasa de este ángulo, no tomó nada: solo ~2° de margen a
                                   # cada lado (42,3 con pelota, 46,1 vacía)                              [AJUSTAR]
    pitch_preferido_deg: float = 90.0  # garra horizontal; si no alcanza, prueba en [pitch_min, pitch_max]
    pitch_min_deg: float = 55.0        # 90 = horizontal, menos = garra apuntando hacia arriba
    pitch_max_deg: float = 100.0
    aproximacion_m: float = 0.06   # el agarre parte 6 cm antes del grano y entra en línea recta
    levantar_m: float = 0.03       # sube el grano para sacarlo del hueco del soporte (25 mm)
    retirar_m: float = 0.08        # y retrocede antes de ir al depósito
    r_min_m: float = 0.05          # la secuencia nunca acerca la garra a menos de esto del eje de la base (más cerca
                                   # pasaría sobre el robot o el propio brazo): acorta la aproximación y el retiro.
                                   # Con brazo_x = 0,10 el frente del robot queda a 5 cm del eje         [AJUSTAR]
    giro_alto_m: float | None = 0.20   # 5 nov: al girar la base, el brazo chocaba con el cabezal de la cámara. Antes de
                                   # cualquier giro de la base de más de giro_umbral_deg, el brazo se ESTIRA hacia arriba
                                   # (garra ~38 cm sobre su base, al menos esto), gira arriba y recién ahí baja a donde
                                   # iba. None = como antes (directo, o por 'transporte')
    giro_umbral_deg: float = 10.0  # giros más chicos (dentro de un agarre) van directo
    t_mov_s: float = 1.0           # duración de un movimiento grande
    t_fino_s: float = 0.4          # duración de cada paso de la aproximación
    error_max_deg: float = 6.0     # si una articulación queda más lejos de su meta: algo la bloquea, se aborta
    carga_max_pct: float = 80.0    # ídem con la carga estimada
    volt_min_v: float = 9.5        # bajo esto el brazo no agarra (4 nov: era 10,5 fijo y con la fuente a 10,2 V no
                                   # partía). XL430: 6,5–12 V; con menos voltaje, menos torque: el hombro estirado
                                   # se sobrecarga antes (docs/brazo.md). Con batería, cargarla igual.   [AJUSTAR]
    postura_espera: str = "descanso"    # entre un grano y otro: plegado DETRÁS del frente del robot. "trabajo"
                                        # deja la garra a la altura de la fila media y 1 cm delante: chocaría
    descanso_sin_torque: bool = False   # True SOLO si el brazo plegado queda APOYADO (si no, se cae)
    archivo_posturas: str = "brazo_posturas.json"   # ANTERIOR (en pi/): sus posturas pasan al perfil la 1ª vez


@dataclass
class ConfigCamara:
    """Pi Camera Module 3 (estándar: 66° × 41°). Modelo completo en cafebot/vision/camara_modelo.py.
    31 oct: sobre un CABEZAL de 2 SG90 en la tapa de la base, a la DERECHA del brazo: inclinación con `X 2` (pin 44),
    giro con `X 3` (pin 4, desactivado: falla; la cámara mira adelante). Medidas del modelo de Fusion
    (description/fusion; alturas corregidas −0,57 cm por las ruedas de 52,6 mm en vez de 64)  [CONFIRMAR con huincha].
    La pose se calibra con el árbol (python3 -m tools.cosecha, tecla C) y los intrínsecos con un tablero de
    ajedrez (python3 -m tools.camara intrinseca); los dos quedan en robot_local.json."""
    x: float = 0.1111               # LENTE en el sistema del robot (m) con el servo de inclinación a 90° y mirando
    y: float = -0.0529              # adelante (el cubo_camara del modelo): 5,3 cm a la DERECHA del centro
    z: float = 0.3673
    inclinacion_arbol_deg: float = 18.0    # inclinación (pitch, + = hacia ARRIBA) para la foto del árbol: con la cámara
                                           # a 37 cm, 16/16 soportes desde 55–65 cm con 15–20° (simulado, 31 oct).
                                           # 5 nov: X 2 = 98 (llega hasta 100 = +20°)
    inclinacion_cajas_deg: float = -20.0   # hacia ABAJO para ver las cajas: 5 nov, lo más abajo que deja el cabezal
                                           # (X 2 = 60); antes −25                                         [AJUSTAR]
    yaw_deg: float = 0.0            # error de montaje: + = mirando hacia la izquierda                 [AJUSTAR: tecla C]
    roll_deg: float = 0.0           #                                                                [AJUSTAR: tecla C]
    cabezal: bool = True            # la posición del lente cambia al inclinar/girar (False = cámara fija en x, y, z)
    eje_pitch_x: float = 0.0840     # eje de INCLINACIÓN (horizontal, paralelo a y): su x y su z (eje del SG90)
    eje_pitch_z: float = 0.3690
    eje_yaw_x: float = 0.0907       # eje de GIRO (vertical): su x e y
    eje_yaw_y: float = -0.0678
    pitch_servo_90_deg: float = 10.0  # inclinación de la cámara con X 2 = 90°. 5 nov: el centro del rango (X 2 = 80, de
                                      # 60..100) es la cámara al frente (0°), así que 90 = +10° (antes 5)  [AJUSTAR: tecla C]
    pitch_por_grado: float = 1.0     # grados de cámara por grado de servo; NEGATIVO si al subir el ángulo de X 2 la
                                     # cámara baja                                              [CONFIRMAR: X 2 70 / X 2 110]
    yaw_cabezal_deg: float = 0.0     # giro del cabezal (X 3 desactivado): 0 = mirando adelante
    servo_pitch_min: int = 60        # 5 nov, medido: el servo de inclinación (X 2) va de 60 a 100° y el de giro (X 3)
    servo_pitch_max: int = 100       # de 50 a 150° (más allá choca). El firmware también los recorta
    servo_yaw_min: int = 50          # (AUX_MIN_DEG / AUX_MAX_DEG en firmware/mega_cafebot/config.h)
    servo_yaw_max: int = 150
    servo_pitch_centro: int = 80     # cámara mirando al frente. 5 nov: punto medio de cada rango; se ajusta a mano con
    servo_yaw_centro: int = 100      # python3 -m tools.cabezal calibrar (la misión lo manda al conectarse)
    ancho_px: int = 1536
    alto_px: int = 864
    # Intrínsecos a 1536×864: 30 oct, tablero de ajedrez (tools.ver_camara, 39 fotos, 0,33 px; Pablo). Antes, de
    # fábrica: fx 1183 (768 / tan 33°), centro de la imagen y sin distorsión
    fx_px: float = 1107.0
    fy_px: float = 1106.6           # 0 = igual a fx
    cx_px: float = 767.4            # 0 = centro de la imagen
    cy_px: float = 424.5
    dist: list = field(default_factory=lambda: [0.08176, -0.21233, -0.00204, 0.00244, 0.1535])   # k1 k2 p1 p2 k3
    foco_m: float = 0.6             # foco FIJO (el autofoco cambia la distancia focal): LensPosition = 1/foco_m
    arbol: str = "competencia"      # forma del árbol: "competencia" (Apéndice B) o pi/arboles/<nombre>.json
    sat_min: int = 130              # pelota = saturación HSV > sat_min (0..255). 29 oct, foto del taller:
    val_min: int = 60               #   madera 85–110, pelotas roja/verde 150–190
    # 5 nov: el árbol de la cancha es VERDE y su base CAFÉ: ese verde (matiz OpenCV 0..180) no cuenta como pelota.
    # None = no excluir (el árbol de madera del taller).   [AJUSTAR con una foto del árbol real: tools.ver_camara]
    # 5 nov, foto del árbol real: copa H 59–61 (sombras hasta 80), S ~190; tronco y base café H 5–9, S 77–93 (no
    # pasan sat_min); soportes S ~96; pelota roja H 1–11. Amarillo ~H 25–32: queda fuera del rango
    excluir_h: tuple | None = (40, 88)
    fotos: int = 3                  # se clasifica con varias fotos: un soporte que cambia entre fotos = NO_SE
    guardar_fotos: bool = True      # en pi/capturas/, con lo clasificado dibujado (para revisar después)
    calibrada: str = ""             # cuándo y cómo se calibró la pose (tools.cosecha C / N). Vacío = sin calibrar:
                                    # el ajuste de cada foto deja moverse inclinación/yaw/roll ±3–4° (manda el LiDAR)

    def servo_de_pitch(self, pitch_deg: float) -> int:
        """Ángulo para X 2 (0..180) que deja la cámara con esa inclinación."""
        s = 90.0 + (pitch_deg - self.pitch_servo_90_deg) / self.pitch_por_grado
        return int(round(min(float(self.servo_pitch_max), max(float(self.servo_pitch_min), s))))

    def pitch_de_servo(self, servo_deg: float) -> float:
        return self.pitch_servo_90_deg + self.pitch_por_grado * (servo_deg - 90.0)


@dataclass
class ConfigAscensor:
    """Cosecha por PISOS (tools.ascensor, docs/ascensor.md; 6 nov): la cámara solo dice qué pelotas hay y de qué
    color en cada piso; la línea del árbol (IR delanteros) da la distancia, el LiDAR el lado y las alturas son las
    del reglamento. El brazo sube al piso (ascensor), entra derecho con la garra abierta y cierra. Todo se AJUSTA a
    mano con el robot de verdad (teclas de tools.ascensor; t guarda aquí, en robot_local.json)."""
    linea_a_cara_m: float = 0.119      # borde cercano de la línea del árbol -> cara del tablero (reglamento) [MEDIR]
    grano_delante_m: float = 0.035     # centro de la pelota por delante de la cara del tablero            [MEDIR]
    z_baja_m: float = 0.407            # altura del CENTRO de la pelota en cada piso (reglamento: soporte + 1,7 cm)
    z_media_m: float = 0.557
    z_alta_m: float = 0.707            # con la base del brazo a ~35 cm, fuera de alcance
    retroceso_baja_m: float = 0.06     # para agarrar en ese piso el robot se aleja esto de la línea (con los IR
    retroceso_media_m: float = 0.04    # sobre la línea la fila baja queda muy pegada a la base del brazo). Con la IK
    retroceso_alta_m: float = 0.0      # (6 nov): baja alcanza con 4–19 cm, media con 0–15 cm (menos = menos carga)
    dx_baja_m: float = 0.0             # corrección del punto de agarre por piso: + = más hacia el árbol
    dx_media_m: float = 0.0
    dx_alta_m: float = 0.0
    dy_baja_m: float = 0.0             # + = más a la izquierda
    dy_media_m: float = 0.0
    dy_alta_m: float = 0.0
    # 6 nov: POSES del brazo en cada piso calibradas con tools.calibrar_cosecha, con los IR delanteros TOCANDO la línea
    # del árbol: x de la garra en el robot (m desde el centro, + adelante) ADELANTADA (en la pelota, lista para
    # cerrar) y RETRAÍDA (abierta, antes de entrar), y la inclinación de la garra (90 = horizontal, menos = la punta
    # hacia arriba). None = sin calibrar: la pelota grano_delante_m delante de la cara (+ dx_*), la retraída
    # brazo.aproximacion_m antes y la inclinación que alcance. Calibradas, dx_* no se usa.
    x_adelantado_baja_m: float | None = None
    x_adelantado_media_m: float | None = None
    x_adelantado_alta_m: float | None = None
    x_retraido_baja_m: float | None = None
    x_retraido_media_m: float | None = None
    x_retraido_alta_m: float | None = None
    pitch_baja_deg: float | None = None
    pitch_media_deg: float | None = None
    pitch_alta_deg: float | None = None
    tocar_para_agarrar: bool = True    # el piso sin retroceso: antes de cada agarre, tocar la línea con los IR delanteros
                                       # y agarrar ahí, sin despegarse (como se calibraron las poses)
    pisos: tuple = ("media", "baja")   # dónde se recoge (la alta no se alcanza)
    prioridad: tuple = (("media", "MADURO"), ("baja", "MADURO"), ("media", "SOBREMADURO"), ("baja", "SOBREMADURO"))
    negros: bool = False               # buscar pelotas negras (oscuras sobre un soporte; una sombra se parece)
    cangrejo_min_m: float = 0.008      # correr el robot de lado solo si la pelota está más corrida que esto del brazo
    # 6 nov: los IR están junto a las ruedas (ver la línea = la rueda en su borde) y al girar a ±90° para el cangrejo
    # cada rueda se corre por la L que la une a su servo: con el robot pegado a la línea, las ruedas la pisaban.
    margen_cangrejo_m: float = 0.07    # los cangrejos se hacen con los IR delanteros a esto (o más) de la línea
    retocar_cada: int = 0              # volver a tocar la línea cada N cangrejos (0 = solo al llegar al árbol)
    despegue_m: float = 0.025          # después de tocar la línea, retroceder esto (la rueda fuera de la cinta)
    sobrepaso_m: float = 0.004         # cuánto entra el IR en la línea al frenar (despacio, en el primer toque)
    dist_foto_m: float = 0.55          # frente del robot -> cara del árbol para la foto
    vel_mm_s: float = 100.0


@dataclass
class Config:
    geometria: GeometriaRobot = field(default_factory=GeometriaRobot)
    puertos: Puertos = field(default_factory=Puertos)
    navegacion: ConfigNavegacion = field(default_factory=ConfigNavegacion)
    ir: ConfigIR = field(default_factory=ConfigIR)
    mision: ConfigMision = field(default_factory=ConfigMision)
    compuertas: ConfigCompuertas = field(default_factory=ConfigCompuertas)
    brazo: ConfigBrazo = field(default_factory=ConfigBrazo)
    camara: ConfigCamara = field(default_factory=ConfigCamara)
    ascensor: ConfigAscensor = field(default_factory=ConfigAscensor)

    def a_dict(self) -> dict:
        return asdict(self)


def cargar(ruta: str | None = None) -> Config:
    """Config por defecto + lo que haya en pi/robot_local.json (si existe)."""
    cfg = Config()
    p = pathlib.Path(ruta) if ruta else pathlib.Path(__file__).resolve().parents[1] / "robot_local.json"
    if p.exists():
        datos = json.loads(p.read_text())
        for seccion, valores in datos.items():
            obj = getattr(cfg, seccion, None)
            if obj is None:
                raise KeyError(f"{p}: sección desconocida '{seccion}'")
            for k, v in valores.items():
                if not hasattr(obj, k):
                    raise KeyError(f"{p}: '{seccion}.{k}' no existe")
                setattr(obj, k, tuple(v) if isinstance(v, list) else v)
    return cfg


def guardar_local(seccion: str, valores: dict, ruta: str | None = None) -> pathlib.Path:
    """Agrega o cambia claves en pi/robot_local.json (lo usan las herramientas de calibración)."""
    p = pathlib.Path(ruta) if ruta else pathlib.Path(__file__).resolve().parents[1] / "robot_local.json"
    datos = json.loads(p.read_text()) if p.exists() else {}
    datos.setdefault(seccion, {}).update(valores)
    p.write_text(json.dumps(datos, indent=2, ensure_ascii=False) + "\n")
    return p
