MauriceTZ/Cafebot/pi/cafebot/mision/interfaces.py

"""Contratos entre la misión y los módulos que el equipo desarrolla por separado.

La misión SOLO habla con estas clases. Para conectar el brazo o la visión reales, basta con
escribir una clase que herede de `Brazo` o `Vision` e implemente sus métodos; nada más cambia.

    Sistema del ROBOT: x adelante, y izquierda, z hacia arriba desde el SUELO (metros).
    Categorías: "MADURO", "SOBREMADURO", "VERDE", "VACIO", "NO_SE" (no tocar),
                "FUERA" (el soporte no cae dentro de la foto: la misión se corre de lado y saca otra).

Implementaciones reales: cafebot/arm/brazo.py (BrazoXL430) y cafebot/vision/vision.py (VisionCamara).
"""
from __future__ import annotations

import os
import math
import time
from dataclasses import dataclass

import numpy as np

from cafebot.mundo import cancha


# ====================================================================== visión
@dataclass
class LecturaSoporte:
    clave: tuple          # (arbol, fila, col): ver cancha.Soporte
    categoria: str        # MADURO / SOBREMADURO / VERDE / VACIO / NO_SE / FUERA
    confianza: float      # 0..1


class Vision:
    def iniciar(self):
        """Antes del botón (abrir la cámara, cargar referencias): lo lento, fuera del reloj de la ronda."""

    def preparar_arbol(self):
        """Antes de la foto del árbol (p. ej. inclinar la cámara hacia arriba: X 2 <ángulo>)."""

    def clasificar_arbol(self, arbol: int, pose_robot_cancha, tablero=None) -> list[LecturaSoporte]:
        """Foto del árbol (frente del robot a ~50 cm) y clasificación de sus 16 soportes.
        pose_robot_cancha: (x, y, θ) del robot en la cancha.
        tablero: (x de la cara, y del centro, ángulo) del pie del árbol en el sistema del robot, medido por el
        LiDAR (más preciso que la pose para saber dónde cae cada soporte en la imagen). Puede ser None."""
        raise NotImplementedError

    def color_cajas(self, zonas_con_caja: list[int], pose_robot_cancha) -> dict[int, str]:
        """{zona: 'ROJA' | 'AZUL'} para las cajas que vea DESDE LA PARTIDA. Puede devolver {} si no sabe."""
        return {}

    def color_caja(self, zona: int, pose_robot_cancha) -> str | None:
        """Con el robot mirando hacia la caja de `zona`: 'ROJA', 'AZUL' o None si no está seguro."""
        return None


# ====================================================================== brazo
class Brazo:
    def preparar(self) -> bool:
        """Encender y llevar a la postura de trabajo. False si no se puede usar."""
        return True

    def recoger(self, p_robot, categoria: str) -> bool:
        """Sacar UN grano cuyo centro está en p_robot = (x, y, z) del sistema del robot, y dejarlo
        en el depósito interno de su categoría. True si quedó dentro del robot."""
        raise NotImplementedError

    def alcanzable(self, p_robot) -> bool:
        """¿Puede llegar a ese punto desde la pose actual de la base?"""
        return True

    def descansar(self):
        """Postura plegada y segura para navegar (idealmente apoyado y sin torque)."""

    def detener(self):
        """Parar ya (ESC / Ctrl+C): no empezar ningún movimiento más."""

    def estado(self) -> str:
        return ""


class BrazoNulo(Brazo):
    """Sin brazo: la misión navega, mira y se acerca, pero no recoge (pruebas de navegación)."""

    def recoger(self, p_robot, categoria):
        print(f"   [brazo nulo] recogería {categoria} en x={p_robot[0]:.3f} y={p_robot[1]:+.3f} z={p_robot[2]:.3f}")
        time.sleep(0.5)
        return False

    def estado(self):
        return "sin brazo (solo navegación)"


# ====================================================================== simulados
class VisionSimulada(Vision):
    """Usa la verdad del escenario simulado, con errores: a veces NO_SE, rara vez se equivoca."""

    def __init__(self, escenario: cancha.Escenario, rng=None, p_no_se=0.10, p_error=0.02, cfg_camara=None,
                 ve_cajas_al_partir=True):
        """cfg_camara: si se da, los soportes que la cámara real no vería (modelo de proyeccion.py) salen FUERA.
        ve_cajas_al_partir=False: como la cámara real, que desde la partida no ve las cajas."""
        self.esc = escenario
        self.rng = rng or np.random.default_rng()
        self.p_no_se, self.p_error = p_no_se, p_error
        self.cfg_camara = cfg_camara
        self.ve_cajas_al_partir = ve_cajas_al_partir

    real_fn = None          # (sim) pose real del robot: para ubicar_arbol, lo que la foto daría sin LiDAR

    def ubicar_arbol(self, arbol, pose_robot_cancha, imagenes=None):
        if self.real_fn is None:
            return None, None, "sin pose real"
        from cafebot.vision.vision import tablero_desde_pose
        t = tablero_desde_pose(arbol, self.real_fn())
        e = self.rng.normal(0, (0.006, 0.004, 0.0))
        return (t[0] + e[0], t[1] + e[1], t[2]), None, "simulada (la verdad ± 4–6 mm)"

    def clasificar_arbol(self, arbol, pose_robot_cancha, tablero=None, imagenes=None):
        time.sleep(0.5)
        visibles = None
        if self.cfg_camara is not None:
            from cafebot.vision.proyeccion import ModeloCamara
            from cafebot.vision.vision import tablero_desde_pose
            t = tablero if tablero is not None else tablero_desde_pose(arbol, pose_robot_cancha)
            visibles = set(ModeloCamara(self.cfg_camara).posiciones_soportes(arbol, t))
        out = []
        for s in cancha.soportes(arbol):
            real = self.esc.granos.get(s.clave, ("VACIO", ""))[0]
            r = self.rng.random()
            if visibles is not None and f"{s.fila}-{s.col + 1}" not in visibles:
                out.append(LecturaSoporte(s.clave, "FUERA", 0.0))
            elif r < self.p_no_se:
                out.append(LecturaSoporte(s.clave, "NO_SE", 0.3))
            elif r < self.p_no_se + self.p_error:
                otra = self.rng.choice([c for c in (cancha.MADURO, cancha.SOBREMADURO, cancha.VERDE) if c != real])
                out.append(LecturaSoporte(s.clave, str(otra), 0.8))
            else:
                out.append(LecturaSoporte(s.clave, real, 0.95))
        return out

    def color_cajas(self, zonas_con_caja, pose_robot_cancha):
        if not self.ve_cajas_al_partir:
            return {}
        col = {self.esc.zona_caja_roja: "ROJA", self.esc.zona_caja_azul: "AZUL"}
        return {z: col[z] for z in zonas_con_caja if z in col}

    def color_caja(self, zona, pose_robot_cancha):
        time.sleep(0.3)
        return {self.esc.zona_caja_roja: "ROJA", self.esc.zona_caja_azul: "AZUL"}.get(zona)


class BrazoSimulado(Brazo):
    """Recoge si el grano está al alcance (mismo modelo de alcance que docs/brazo.md) y de la
    categoría real del escenario va al depósito. Registra lo que queda dentro del robot."""

    def __init__(self, escenario: cancha.Escenario, pose_robot_fn, base_xyz=(0.10, 0.0, 0.36), alcance=0.38,
                 t_agarre=4.0, p_falla=0.1, rng=None, alcanzable_fn=None):
        self.esc = escenario
        self.alcanzable_fn = alcanzable_fn      # p. ej. BrazoXL430.alcanzable (la cinemática y el plan de verdad)
        self.pose_robot_fn = pose_robot_fn      # pose REAL del robot en la cancha (simulación)
        self.base = np.array(base_xyz)
        self.alcance = alcance
        self.t = t_agarre
        self.p_falla = p_falla
        self.rng = rng or np.random.default_rng()
        self.depositos = {cancha.MADURO: [], cancha.SOBREMADURO: [], cancha.VERDE: []}
        self.botados = []

    def alcanzable(self, p_robot):
        if self.alcanzable_fn is not None:
            return bool(self.alcanzable_fn(p_robot))
        d = np.asarray(p_robot) - self.base
        return math.hypot(d[0], d[1]) < 0.20 and np.linalg.norm(d) < self.alcance

    def _soporte_real(self, p_robot):
        """¿Qué grano hay realmente donde apunta el brazo? (con la pose REAL del robot)"""
        x, y, th = self.pose_robot_fn()
        c, s = math.cos(th), math.sin(th)
        px, py = x + c * p_robot[0] - s * p_robot[1], y + s * p_robot[0] + c * p_robot[1]
        mejor, dmin = None, 1e9
        for a in (1, 2, 3):
            for sop in cancha.soportes(a):
                d = math.dist((px, py, p_robot[2]), (sop.x, sop.y, sop.z))
                if d < dmin:
                    mejor, dmin = sop, d
        return mejor, dmin

    def recoger(self, p_robot, categoria):
        time.sleep(self.t)
        if not self.alcanzable(p_robot):
            return False
        sop, error = self._soporte_real(p_robot)
        if error > 0.025 or sop.clave not in self.esc.granos:       # la garra deja ±2,5 cm de margen
            return False
        if self.rng.random() < self.p_falla:
            return False
        cat, _ = self.esc.granos.pop(sop.clave)                     # sale del árbol
        self.depositos[categoria if categoria in self.depositos else cat].append(cat)
        return True

    def estado(self):
        return " ".join(f"{k[:4]}={len(v)}" for k, v in self.depositos.items())


class BrazoHibrido(Brazo):
    """Prueba HÍBRIDA: ronda simulada con el BRAZO REAL (tools.mision --sim --brazo, tools.navegacion --sim --brazo).
    El brazo de verdad hace cada agarre completo (acercarse, cerrar la garra, ir a la canasta, soltar) con los mismos
    puntos que tendría frente al árbol, y el mundo simulado (BrazoSimulado, con la pose real del robot simulado)
    decide si el grano salió del árbol y lleva la cuenta. La garra cierra en el aire: no se exige grano."""

    def __init__(self, real, sim: BrazoSimulado, log=print):
        self.real, self.sim, self.log = real, sim, log
        self.sim.t = 0.0                        # el tiempo de cada agarre lo pone el brazo de verdad
        self.real.prueba_sin_granos = True

    def preparar(self) -> bool:
        return self.real.preparar()

    def alcanzable(self, p_robot) -> bool:
        return self.real.alcanzable(p_robot)

    def recoger(self, p_robot, categoria: str) -> bool:
        if not self.real.recoger(p_robot, categoria):
            self.log(f"   [brazo real] no completó el agarre: {self.real.ultimo_motivo}")
            return False
        return self.sim.recoger(p_robot, categoria)

    def descansar(self):
        self.real.descansar()

    def detener(self):
        self.real.detener()

    def estado(self) -> str:
        real = self.real.estado().split(" | ", 1)
        return self.sim.estado() + (f" | brazo real: {real[1]}" if len(real) > 1 else "")


class VisionNula(Vision):
    """Sin visión: todo es NO_SE, así que la misión no toca ningún grano (solo navega y se acerca)."""

    def clasificar_arbol(self, arbol, pose_robot_cancha, tablero=None):
        return [LecturaSoporte(s.clave, "NO_SE", 0.0) for s in cancha.soportes(arbol)]


class VisionFija(Vision):
    """SOLO PARA PROBAR EL BRAZO en el taller con un árbol cargado únicamente con granos de `categoria`.
    Nunca usar en una ronda: tomaría los verdes (−7 cada uno)."""

    def __init__(self, categoria=cancha.MADURO):
        self.cat = categoria

    def clasificar_arbol(self, arbol, pose_robot_cancha, tablero=None):
        return [LecturaSoporte(s.clave, self.cat, 1.0) for s in cancha.soportes(arbol)]


# ====================================================================== botón de inicio
class LidarNulo:
    """Sin LiDAR (5 nov: problemas de alimentación): no entrega barridos. La navegación queda con la odometría del
    Mega (+ IMU) y la misión con las líneas; ver --sin-lidar en tools.mision (solo con --reducida)."""
    sin_datos = True

    def iniciar(self):
        pass

    def ultimo_scan(self):
        return None

    def esperar_scan(self, timeout: float = 1.0):
        time.sleep(min(timeout, 0.05))
        return None

    def detener(self):
        pass


class Boton:
    def esperar(self):
        """Bloquea hasta que se aprieta el botón de inicio."""


def chip_del_conector(log=print) -> int | None:
    """Número del /dev/gpiochipN del conector de 40 pines (etiqueta pinctrl-rp1 en la Pi 5; 54 líneas o bcm2711/2835
    en las anteriores). 5 nov: en la Pi del robot son 11..16, no 0 ni 4. Se pregunta con el ioctl del kernel
    (GPIO_GET_CHIPINFO), SIN lgpio: abrir y cerrar cada chip con lgpio dejaba el del conector sin poder abrirse de
    nuevo ("can not open gpiochip"). None si no hay gpiochip (no es una Raspberry) o no se reconoce."""
    import fcntl
    import glob
    import re
    import struct
    candidatos = []
    for ruta in glob.glob("/dev/gpiochip*"):
        m = re.fullmatch(r"/dev/gpiochip(\d+)", ruta)
        if not m:
            continue
        try:
            fd = os.open(ruta, os.O_RDONLY)
            try:
                info = fcntl.ioctl(fd, 0x8044B401, bytes(68))        # struct gpiochip_info: name[32], label[32], u32
            finally:
                os.close(fd)
        except OSError:
            continue
        etiqueta = info[32:64].split(b"\0")[0].decode(errors="replace")
        candidatos.append((int(m.group(1)), struct.unpack_from("<I", info, 64)[0], etiqueta))
    elegido = next((c for c in candidatos if "rp1" in c[2].lower()), None) or next(
        (c for c in candidatos if c[1] == 54 or "bcm2835" in c[2].lower() or "bcm2711" in c[2].lower()), None)
    if elegido is None:
        if candidatos:
            log(f"[botón] no reconozco el gpiochip del conector entre {candidatos}: dejo que gpiozero elija")
        return None
    log(f"[botón] conector de 40 pines = /dev/gpiochip{elegido[0]} ({elegido[2]}, {elegido[1]} líneas)")
    return elegido[0]


class BotonGpioget:
    """Plan B si lgpio no abre el chip: lee el pin con `gpioget` (libgpiod, viene con Raspberry Pi OS) cada 10 ms,
    con el pull-up. Misma interfaz que lo que usa BotonGPIO de gpiozero.Button."""

    def __init__(self, chip: int, pin: int):
        import subprocess
        self.sp = subprocess
        self.cmds = [["gpioget", "-B", "pull-up", f"gpiochip{chip}", str(pin)],              # libgpiod 1.x
                     ["gpioget", "--bias=pull-up", "-c", f"gpiochip{chip}", str(pin)]]      # libgpiod 2.x
        self.is_pressed                                                                   # falla aquí si no anda

    @property
    def is_pressed(self) -> bool:
        for cmd in list(self.cmds):
            r = self.sp.run(cmd, capture_output=True, text=True, timeout=2)
            if r.returncode == 0:
                self.cmds = [cmd]
                salida = r.stdout.strip().lower()
                if salida.endswith("inactive"):
                    return True                 # 2.x: "16"=inactive = 0 = a GND
                if salida.endswith("active"):
                    return False
                return salida.endswith("0")    # 1.x: imprime 0 / 1
        raise OSError(f"gpioget no pudo leer el pin: {r.stderr.strip()}")

    def _esperar(self, apretado: bool, timeout=None) -> bool:
        fin = None if timeout is None else time.monotonic() + timeout
        while self.is_pressed != apretado:
            if fin is not None and time.monotonic() > fin:
                return False
            time.sleep(0.01)
        return True

    def wait_for_press(self, timeout=None):
        return self._esperar(True, timeout)

    def wait_for_release(self, timeout=None):
        return self._esperar(False, timeout)


class BotonGPIO(Boton):
    """Pulsador entre el GPIO `pin` (numeración BCM) y GND, con el pull-up interno de la Pi: suelto = alto (1),
    apretado = bajo (0). 5 nov: GPIO 16 = pin físico 36 (GND en el 34 o el 39), config.mision.pin_boton.
    Parte al SOLTAR (la mano ya no está sobre el robot). Un pulso de menos de MIN_APRETADO_S es ruido de los
    motores en el cable, no un dedo: se ignora. Si al empezar ya se lee apretado (botón trabado, cable a GND), se
    espera a que se suelte en vez de partir solo."""
    MIN_APRETADO_S = 0.05

    def __init__(self, pin, log=print, pin_factory=None):
        from gpiozero import Button          # viene con Raspberry Pi OS (usa lgpio en la Pi 5)
        self.pin, self.log = pin, log
        chip = None
        if pin_factory is None:
            chip = chip_del_conector(log)
            if chip is not None:
                try:
                    from gpiozero.pins.lgpio import LGPIOFactory
                    pin_factory = LGPIOFactory(chip=chip)
                except Exception as e:
                    log(f"[botón] lgpio no abrió /dev/gpiochip{chip} ({e}): leo el pin con gpioget")
                    self.b = BotonGpioget(chip, pin)
                    return
        self.b = Button(pin, pull_up=True, bounce_time=None, pin_factory=pin_factory)

    def esperar(self):
        if self.b.is_pressed:
            self.log(f"[botón] el GPIO {self.pin} se lee APRETADO antes de empezar (¿botón trabado o cable a GND?): "
                     "espero a que se suelte")
            self.b.wait_for_release()
        self.log(f"[botón] listo: esperando el botón de inicio (GPIO {self.pin})")
        while True:
            self.b.wait_for_press()
            t0 = time.monotonic()
            self.b.wait_for_release()
            if time.monotonic() - t0 >= self.MIN_APRETADO_S:
                return
            self.log("[botón] pulso de menos de 50 ms (ruido): sigo esperando")


class BotonEnter(Boton):
    def esperar(self):
        input(">>> ENTER para partir (simula el botón de inicio)... ")


# ====================================================================== depósitos (compuertas)
class Depositos:
    """Compuertas traseras: k = 0 maduros (caja roja), k = 1 sobremaduros (caja azul). Esta: servos del Mega
    (X 0 / X 1; la simulación). Las de verdad son Dynamixel: cafebot/arm/compuertas.py (DepositosDXL)."""

    def __init__(self, mega, cfg_mision):
        self.mega, self.c = mega, cfg_mision

    def preparar(self) -> bool:
        """Antes del botón (fuera del reloj): conectar y sujetar las compuertas."""
        return True

    def vaciar(self, k: int):
        self.mega.comando(f"X {k} {self.c.compuerta_abierta_deg[k]:.0f}")
        time.sleep(self.c.t_vaciado_s)
        self.mega.comando(f"X {k} {self.c.compuerta_cerrada_deg[k]:.0f}")
        time.sleep(0.4)

    def cerrar_todo(self):
        for k in (0, 1):
            self.mega.comando(f"X {k} {self.c.compuerta_cerrada_deg[k]:.0f}")


class DepositosSimulados(Depositos):
    """Como Depositos, y además mira (con la pose REAL) en qué caja cayeron los granos."""

    def __init__(self, mega, cfg_mision, brazo_sim: BrazoSimulado, escenario, pose_real_fn):
        super().__init__(mega, cfg_mision)
        self.brazo, self.esc, self.pose_real_fn = brazo_sim, escenario, pose_real_fn
        self.en_roja, self.en_azul, self.abandonados = [], [], []

    def vaciar(self, k):
        super().vaciar(k)
        cat = (cancha.MADURO, cancha.SOBREMADURO)[k]
        granos, self.brazo.depositos[cat] = self.brazo.depositos[cat], []
        x, y, th = self.pose_real_fn()
        sx = x + math.cos(th) * self.c.salida_x
        sy = y + math.sin(th) * self.c.salida_x
        if cancha.rect_caja(self.esc.zona_caja_roja).contiene(np.array(sx), np.array(sy)):
            self.en_roja += granos
        elif cancha.rect_caja(self.esc.zona_caja_azul).contiene(np.array(sx), np.array(sy)):
            self.en_azul += granos
        else:
            self.abandonados += granos
        return sx, sy

    def puntaje(self) -> int:
        en_robot = [c for v in self.brazo.depositos.values() for c in v]
        return cancha.puntaje(en_robot, self.en_roja, self.en_azul, self.abandonados)
