MauriceTZ/Cafebot/firmware/test_host/sim.cpp

// Prueba en el PC: firmware real + planta simulada (motores, encoders, servos).
// Compilar y correr:  ./correr.sh
#include "Arduino.h"
#include <chrono>
#include <thread>
#include <unistd.h>
#include <fcntl.h>
uint32_t sim_us=0; int pin_val[128]; int pin_pwm[128]; int analog_val[128]; isr_t isr_tab[128]; int servo_cmd[128];
SerialMock Serial;
#include "EEPROM.h"
EEPROMMock EEPROM;
#include "../mega_cafebot/mega_cafebot.ino"

// ---------------- Planta ----------------
static const float POS[4][2]={{ESQUINA_X[0]*CINEMATICA_L/2,ESQUINA_Y[0]*CINEMATICA_W/2},{ESQUINA_X[1]*CINEMATICA_L/2,ESQUINA_Y[1]*CINEMATICA_W/2},{ESQUINA_X[2]*CINEMATICA_L/2,ESQUINA_Y[2]*CINEMATICA_W/2},{ESQUINA_X[3]*CINEMATICA_L/2,ESQUINA_Y[3]*CINEMATICA_W/2}};
static const uint8_t ENC_A[4]={M1_ENC_A,M2_ENC_A,M3_ENC_A,M4_ENC_A}, ENC_B[4]={M1_ENC_B,M2_ENC_B,M3_ENC_B,M4_ENC_B}, ENC_INV[4]={M1_INV_ENC,M2_INV_ENC,M3_INV_ENC,M4_INV_ENC};
float ganancia[4]={1.05f,0.95f,1.0f,0.92f};  // motores distintos a propósito
float vrueda[4]={0}, dist_acum[4]={0}; long cuentas_gen[4]={0};
double X=0,Y=0,TH=0;  // pose real
// Rueda unida al servo con una L: al girar el servo, la rueda se arrastra y empuja la base. Modelo simple:
// la base gira K_ARRASTRE × (suma de lo que giraron los 4 servos) / 4. Con dos y dos se cancela.
const double K_ARRASTRE=0.10; double phi_prev[4]={0,0,0,0}; bool phi_ini=false;
void planta(float h){
  float vw[4][2];
  for(int i=0;i<4;i++){
    int d1=pin_val[PIN_DIR1[i]], d2=pin_val[PIN_DIR2[i]], pwm=pin_pwm[PIN_PWM[i]];
    int sg=(d2&&!d1)?1:((d1&&!d2)?-1:0); if(INV_MOTOR[i]) sg=-sg;
    bool freno = d1&&d2;
    float obj = sg*std::max(0,pwm-15)*2.27f*ganancia[i];
    float tau = freno?0.03f:0.08f;
    vrueda[i]+= (obj-vrueda[i])*h/tau;
    float phi = radians(((servo_cmd[PIN_SERVO[i]]-544)/10.311f-OFFSET_SERVO[i])*SIGNO_SERVO[i]);
    if(phi_ini) TH += K_ARRASTRE*(phi-phi_prev[i])/4; phi_prev[i]=phi;
    vw[i][0]=vrueda[i]*cos(phi); vw[i][1]=vrueda[i]*sin(phi);
    dist_acum[i]+=vrueda[i]*h;
    long objetivo=lround(dist_acum[i]/(CIRCUNFERENCIA_RUEDA/(PULSOS_POR_REVOLUCION*2.0f)));  // cada flanco físico de A
    while(cuentas_gen[i]!=objetivo){
      bool fwd = objetivo>cuentas_gen[i];
      int a=!pin_val[ENC_A[i]]; pin_val[ENC_A[i]]=a;
      bool quiero_igual = fwd ? !ENC_INV[i] : ENC_INV[i];
      pin_val[ENC_B[i]] = quiero_igual ? a : !a;
      isr_tab[ENC_A[i]]();
      cuentas_gen[i]+= fwd?1:-1;
    }
  }
  // Movimiento rígido por mínimos cuadrados: v_i = (vx - w*y_i, vy + w*x_i)
  double sx=0,sy=0,sw=0,den=0; for(int i=0;i<4;i++){sx+=vw[i][0]; sy+=vw[i][1];}
  double vx=sx/4, vy=sy/4; double num=0; for(int i=0;i<4;i++){num+= -POS[i][1]*vw[i][0]+POS[i][0]*vw[i][1]; den+=POS[i][0]*POS[i][0]+POS[i][1]*POS[i][1];}
  double w=num/den; phi_ini=true;
  X+= (vx*cos(TH)-vy*sin(TH))*h; Y+=(vx*sin(TH)+vy*cos(TH))*h; TH+=w*h;
}
std::string log_out;
bool correr_hasta(const std::string& marca, float max_s){
  uint32_t fin=sim_us+(uint32_t)(max_s*1e6);
  while(sim_us<fin){ sim_us+=100; planta(1e-4f); loop();
    if(!Serial.out.empty()){ log_out+=Serial.out; Serial.out.clear(); }
    if(log_out.find(marca)!=std::string::npos) return true; }
  return false;
}
void enviar(const char*c){ Serial.in+=c; Serial.in+="\n"; }
int fallos=0;
void prueba(const char* nombre,const char* cmd,const char* marca,double ex,double ey,double eth_deg,float tol_mm=15,float tol_deg=3){
  log_out.clear(); uint32_t t0=sim_us; enviar(cmd);
  bool ok=correr_hasta(marca,60);
  correr_hasta("@@nunca@@",0.3);
  double e_fw = hypot(pose.x-ex,pose.y-ey), e_real=hypot(X-ex,Y-ey);
  double eth_fw=fabs(degrees(wrapAngle(pose.th-radians(eth_deg)))), eth_real=fabs(degrees(wrapAngle(TH-radians(eth_deg))));
  bool pasa = ok && e_fw<tol_mm && e_real<tol_mm && eth_fw<tol_deg && eth_real<tol_deg;
  if(!pasa) fallos++;
  printf("%-34s %s  t=%.1fs  fw=(%.0f,%.0f,%.1f°) real=(%.0f,%.0f,%.1f°)\n",nombre,pasa?"OK  ":"FALLA",(sim_us-t0)/1e6,pose.x,pose.y,degrees(pose.th),X,Y,degrees(TH));
  if(!pasa) printf("   salida: %s\n",log_out.c_str());
}
// Modo interactivo: el firmware simulado habla por stdin/stdout en tiempo real.
// Lo usa pi/tests (y sirve para probar la Pi sin el robot): ./cafebot_sim --interactivo
int interactivo(){
  fcntl(0,F_SETFL,O_NONBLOCK); setvbuf(stdout,nullptr,_IONBF,0);
  setup();
  auto t0=std::chrono::steady_clock::now();
  char b[256];
  std::string pendiente;   // líneas "@A pin valor" son para la PLANTA (lecturas analógicas simuladas)
  while(true){
    ssize_t n=::read(0,b,sizeof b);
    if(n==0) return 0;
    if(n>0){
      pendiente.append(b,n);
      size_t fin;
      while((fin=pendiente.find('\n'))!=std::string::npos){
        std::string l=pendiente.substr(0,fin+1); pendiente.erase(0,fin+1);
        int pin,val;
        if(l[0]=='@'){ if(sscanf(l.c_str(),"@A %d %d",&pin,&val)==2 && pin>=0 && pin<128) analog_val[pin]=val; }
        else Serial.in+=l;
      }
    }
    uint32_t real_us=(uint32_t)std::chrono::duration_cast<std::chrono::microseconds>(std::chrono::steady_clock::now()-t0).count();
    while(sim_us<real_us){ sim_us+=100; planta(1e-4f); loop(); }
    if(!Serial.out.empty()){ fwrite(Serial.out.data(),1,Serial.out.size(),stdout); Serial.out.clear(); }
    std::this_thread::sleep_for(std::chrono::milliseconds(2));
  }
}
int main(int argc,char**argv){
  if(argc>1 && std::string(argv[1])=="--interactivo") return interactivo();
  setup(); correr_hasta("READY",1);
  prueba("A 500 (avanzar 0,5 m)","A 500","DONE #1",500,0,0);
  prueba("W 90 (girar 90° izq)","W 90","DONE #2",500,0,90);
  prueba("A -200 (retroceder)","A -200","DONE #3",500,-200,90);
  prueba("L 90 300 (cangrejo a la izq)","L 90 300","DONE #4",200,-200,90);
  // Cangrejo espejado: de izquierda a derecha las ruedas no se mueven (solo cambia el sentido de los motores)
  { int antes[4]; for(int i=0;i<4;i++) antes[i]=servo_cmd[PIN_SERVO[i]];
    prueba("L -90 300 (sin mover los servos)","L -90 300","DONE #5",500,-200,90);
    bool quietos=true; for(int i=0;i<4;i++) quietos = quietos && servo_cmd[PIN_SERVO[i]]==antes[i];
    int dist=0; for(int i=0;i<4;i++) dist += abs(antes[i]-servo_cmd[PIN_SERVO[0]])>500;
    printf("%-34s %s\n","  servos quietos, dos a cada lado",(quietos&&dist==2)?"OK":"FALLA"); if(!(quietos&&dist==2)) fallos++; }
  prueba("L 0 300 (cangrejo adelante)","L 0 300","DONE #6",500,100,90);
  // Patrón 0 (las 4 igual, como antes): el arrastre de las L gira la base y la odometría no lo ve
  { log_out.clear(); enviar("LE 0"); correr_hasta("OK LE 0",0.1);
    double th0=TH; log_out.clear(); enviar("L 90 20"); correr_hasta("DONE #7",10); correr_hasta("@@",0.3);
    double giro_igual=degrees(TH-th0);
    enviar("L 0 20"); correr_hasta("DONE #8",10); correr_hasta("@@",0.3);
    enviar("LE 1"); correr_hasta("OK LE 1",0.1);
    th0=TH; enviar("L 90 20"); correr_hasta("DONE #9",10); correr_hasta("@@",0.3);
    double giro_espejo=degrees(TH-th0);
    enviar("L 0 20"); correr_hasta("DONE #10",10); correr_hasta("@@",0.3);
    bool ok=fabs(giro_igual)>5 && fabs(giro_espejo)<0.5;
    printf("%-34s %s  (las 4 igual: %+.1f°, espejado: %+.1f°)\n","Cangrejo: torque de las L",ok?"OK":"FALLA",giro_igual,giro_espejo);
    if(!ok) fallos++;
    pose.th = TH; }   // la odometría no vio el giro del patrón 0: se corrige para las pruebas siguientes
  prueba("W -180","W -180","DONE #11",pose.x,pose.y,-90);
  prueba("G 0 0 0 (waypoint al origen)","G 0 0 0","DONE #12",0,0,0);
  // Watchdog
  log_out.clear(); enviar("V 100 0"); bool wd=correr_hasta("WATCHDOG",2.0);
  printf("%-34s %s\n","Watchdog V sin repetir",wd&&log_out.find("WATCHDOG")!=std::string::npos?"OK":"FALLA"); if(!wd) fallos++;
  // ---- IR (4 x QTR-1A analógicos) ----
  for(int k=0;k<IR_N;k++) analog_val[IR_PINES[k]]=150;      // lona blanca
  correr_hasta("@@",0.05);
  // Evento con flancos: DI ve negro -> "EVT IR 1 1 0 x y th"
  log_out.clear(); analog_val[IR_PINES[0]]=900; bool ev=correr_hasta("EVT IR 1 1 0",0.1);
  analog_val[IR_PINES[0]]=150; bool ev2=correr_hasta("EVT IR 0 0 1",0.1);
  printf("%-34s %s\n","IR: evento con flancos",(ev&&ev2)?"OK":"FALLA"); if(!(ev&&ev2)) fallos++;
  // Histéresis (umbral 500, h 60): 520 sigue blanco, 540 negro; 480 sigue negro, 460 blanco
  { auto mask=[&](){ log_out.clear(); enviar("I"); correr_hasta("auto=",0.1); return atoi(log_out.c_str()+log_out.find("mask=")+5); };
    int m[4];
    analog_val[IR_PINES[1]]=520; correr_hasta("@@",0.03); m[0]=mask()&2;
    analog_val[IR_PINES[1]]=540; correr_hasta("@@",0.03); m[1]=mask()&2;
    analog_val[IR_PINES[1]]=480; correr_hasta("@@",0.03); m[2]=mask()&2;
    analog_val[IR_PINES[1]]=460; correr_hasta("@@",0.03); m[3]=mask()&2;
    bool ok= !m[0] && m[1] && m[2] && !m[3];
    printf("%-34s %s  (520:%d 540:%d 480:%d 460:%d)\n","IR: umbral con histeresis",ok?"OK":"FALLA",!!m[0],!!m[1],!!m[2],!!m[3]); if(!ok) fallos++; }
  // Calibración manual: IW (blanco 140) + IN 2 (negro 870) -> umbral 505; contraste bajo se rechaza
  { for(int k=0;k<IR_N;k++) analog_val[IR_PINES[k]]=140;
    log_out.clear(); enviar("IW"); correr_hasta("auto=",0.2);
    analog_val[IR_PINES[2]]=870; correr_hasta("@@",0.02); log_out.clear(); enviar("IN 2"); correr_hasta("auto=",0.2);
    bool ok = log_out.find("u=495/495/505/495")!=std::string::npos && log_out.find("b=140/140/140/140")!=std::string::npos;
    analog_val[IR_PINES[3]]=200; correr_hasta("@@",0.02); log_out.clear(); enviar("IN 3"); correr_hasta("auto=",0.2);
    // 200 vs 140: contraste bajo -> aviso, y ni el negro ni el umbral del sensor 3 cambian
    ok = ok && log_out.find("contraste_bajo 3")!=std::string::npos && log_out.find("u=495/495/505/495")!=std::string::npos
            && log_out.find("n=850/850/870/850")!=std::string::npos;
    printf("%-34s %s\n","IR: calibracion IW / IN",ok?"OK":"FALLA"); if(!ok){ fallos++; printf("   %s",log_out.c_str()); } }
  // Auto-calibración: IA 1, pasar sobre la línea (130 <-> 910), IA 0 -> umbral 520 en los 4
  { log_out.clear(); enviar("ID"); correr_hasta("auto=",0.1); enviar("IA 1"); correr_hasta("OK IA",0.1);
    for(int paso=0;paso<6;paso++){ for(int k=0;k<IR_N;k++) analog_val[IR_PINES[k]]=(paso%2)?910:130; correr_hasta("@@",0.03); }
    log_out.clear(); enviar("IA 0"); correr_hasta("max=",0.1); bool ok=log_out.find("calibrados=15")!=std::string::npos;
    log_out.clear(); enviar("I"); correr_hasta("auto=",0.1); ok = ok && log_out.find("u=520/520/520/520")!=std::string::npos;
    printf("%-34s %s\n","IR: auto-calibracion IA",ok?"OK":"FALLA"); if(!ok){ fallos++; printf("   %s",log_out.c_str()); } }
  // Lecturas crudas
  { for(int k=0;k<IR_N;k++) analog_val[IR_PINES[k]]=100+k; correr_hasta("@@",0.02);
    log_out.clear(); enviar("IM 50"); bool ok=correr_hasta("IRV 100 101 102 103 0",0.2); enviar("IM 0"); correr_hasta("OK IM",0.1);
    printf("%-34s %s\n","IR: lecturas crudas IM",ok?"OK":"FALLA"); if(!ok) fallos++; }
  // Freno por borde: solo los sensores de la máscara (IS 1 3 = delanteros)
  { enviar("IG"); correr_hasta("guardado",0.1);
    enviar("IS 1 3"); enviar("A 1000"); correr_hasta("OK #",0.2); correr_hasta("@@",1.0);
    log_out.clear(); analog_val[IR_PINES[2]]=950; bool trasero=correr_hasta("BORDE",0.1);   // trasero: no frena
    analog_val[IR_PINES[2]]=110;
    correr_hasta("@@",0.2); double x0=X; log_out.clear(); analog_val[IR_PINES[0]]=950; bool br=correr_hasta("BORDE",0.1);
    correr_hasta("@@",0.5);
    bool ok = br && !trasero;
    printf("%-34s %s  (recorrido desde que ve la linea hasta quedar quieto: %.1f mm)\n","IR: frena al ver borde",ok?"OK":"FALLA",X-x0); if(!ok) fallos++;
    analog_val[IR_PINES[0]]=110; enviar("IS 0"); correr_hasta("seg=",0.1); }
  // Diagnóstico de encoders: en cuadratura sana ambos flancos suman con el mismo signo
  enviar("S"); correr_hasta("@@",0.3); log_out.clear(); enviar("ED"); correr_hasta("ENCD",0.2);
  log_out.clear(); enviar("A 300"); correr_hasta("DONE",10); log_out.clear(); enviar("ED"); correr_hasta("ENCD",0.2);
  { int s1=0,b1=0; sscanf(log_out.c_str()+log_out.find("M1=")+3,"%d/%d",&s1,&b1);
    bool ok = s1>400 && b1>400 && abs(s1-b1)<20;
    printf("%-34s %s  (%s)\n","ED: flancos con el mismo signo", ok?"OK":"FALLA", log_out.substr(0,log_out.find('\n')).c_str()); if(!ok) fallos++; }
  // Cambio a x2 en vivo: la distancia recorrida debe seguir siendo la correcta
  log_out.clear(); enviar("EM 2"); correr_hasta("OK EM",0.2);
  { double x0=X, p0=pose.x; log_out.clear(); enviar("A 300"); bool ok=correr_hasta("DONE",10); correr_hasta("@@",0.3);
    ok = ok && fabs((X-x0)-300)<8 && fabs((pose.x-p0)-300)<8;
    printf("%-34s %s  (real %.0f mm, odometria %.0f mm)\n","EM 2 + A 300", ok?"OK":"FALLA", X-x0, pose.x-p0); if(!ok) fallos++; }
  enviar("EM 1"); correr_hasta("OK EM",0.2);
  // Ruta T
  enviar("S"); enviar("R"); X=Y=TH=0; correr_hasta("@@",0.3);
  prueba("T (cuadrado 500 mm)","T","DONE #19",0,0,0,25,4);
  printf("\n%s (%d fallos)\n", fallos?"HAY FALLOS":"TODO OK", fallos);
  return fallos?1:0;
}
