MauriceTZ/Cafebot/pi/tools/cabezal.py

"""El cabezal de la cámara: CALIBRAR a mano dónde queda "al frente", o probarlo con un CÍRCULO en su rango.

    python3 -m tools.cabezal calibrar              # teclado (en la terminal, también por SSH): w/s o ↑/↓ inclinación,
                                                   # a/d o ←/→ giro (1°; con MAYÚSCULA 5°), c = volver al guardado,
                                                   # g = guardar como "al frente", q = salir. La cámara en vivo con una
                                                   # cruz en el centro (en la pantalla HDMI si se lanza por SSH)
    python3 -m tools.cabezal arbol [--dist 0.55]   # la inclinación para la FOTO DEL ÁRBOL: el robot centrado frente al
                                                   # pie con el frente a --dist; se dibujan los 16 soportes donde el
                                                   # modelo los espera. w/s mueve la cámara; i/k corre los círculos
                                                   # (corrige cuánto mira la cámara con cada X 2) hasta que calcen con
                                                   # los soportes reales (j/l giro, u/o roll); g guarda.
                                                   # En VERDE las pelotas que detecta (si una no sale, ver sat_min)
    python3 -m tools.cabezal                       # círculo: 2 vueltas, ventana con la cámara en vivo (en la pantalla HDMI
                                                   # si se lanza por SSH); al final un mosaico en pi/capturas/
    python3 -m tools.cabezal --vueltas 1 --periodo 10 --radio 0.5
    python3 -m tools.cabezal --sin-camara          # solo los servos
    python3 -m tools.cabezal --sim                 # sin robot: el Mega simulado (prueba el recorrido)

Rangos (5 nov, config.camara): inclinación X 2 60..100° y giro X 3 50..150°; el centro (80 / 100) = al frente. El
círculo es una elipse alrededor del centro con `--radio` × medio rango (0,9 por defecto: no toca los topes). Al
terminar (o con Ctrl+C / ESC / Q) la cámara vuelve al frente.
Si el firmware tiene el giro desactivado (AUX_ACTIVO en firmware/mega_cafebot/config.h) el Mega contesta ERR a X 3:
se avisa y solo se mueve la inclinación (sube y baja). Mientras corre, el Mega no puede estar abierto en otro programa.
"""
from __future__ import annotations

import argparse
import math
import os
import time

from cafebot.config import cargar


def puntos_circulo(cc, radio: float, pasos: int) -> list[tuple[int, int]]:
    """[(X 2, X 3)] de una vuelta de la elipse alrededor del frente, dentro de los rangos (sin repetir ángulos)."""
    r_p = radio * (cc.servo_pitch_max - cc.servo_pitch_min) / 2
    r_y = radio * (cc.servo_yaw_max - cc.servo_yaw_min) / 2
    out = []
    for i in range(pasos):
        a = 2 * math.pi * i / pasos
        p = round(cc.servo_pitch_centro + r_p * math.sin(a))
        y = round(cc.servo_yaw_centro + r_y * math.cos(a))
        p = min(cc.servo_pitch_max, max(cc.servo_pitch_min, p))
        y = min(cc.servo_yaw_max, max(cc.servo_yaw_min, y))
        if not out or out[-1] != (p, y):
            out.append((p, y))
    return out


def mosaico(fotos, columnas: int = 6, ancho: int = 320):
    """Las fotos (con su rótulo ya dibujado) en una grilla, para ver de un vistazo qué mira en cada punto."""
    import cv2
    import numpy as np
    if not fotos:
        return None
    alto = int(round(ancho * fotos[0].shape[0] / fotos[0].shape[1]))
    chicas = [cv2.resize(f, (ancho, alto)) for f in fotos]
    while len(chicas) % columnas:
        chicas.append(np.zeros_like(chicas[0]))
    filas = [np.hstack(chicas[i:i + columnas]) for i in range(0, len(chicas), columnas)]
    return np.vstack(filas)


def main():
    ap = argparse.ArgumentParser(description=__doc__, formatter_class=argparse.RawDescriptionHelpFormatter)
    ap.add_argument("modo", nargs="?", choices=("circulo", "calibrar", "arbol"), default="circulo")
    ap.add_argument("--mega", default=None, help="puerto del Mega (por defecto el de la config)")
    ap.add_argument("--sim", action="store_true", help="Mega simulado (sin robot)")
    ap.add_argument("--vueltas", type=int, default=2)
    ap.add_argument("--periodo", type=float, default=8.0, help="segundos por vuelta")
    ap.add_argument("--pasos", type=int, default=24, help="puntos por vuelta")
    ap.add_argument("--radio", type=float, default=0.9, help="fracción del medio rango (0..1)")
    ap.add_argument("--dist", type=float, default=None, help="(arbol) frente del robot -> pie del árbol (m); "
                    "por defecto mision.distancia_foto_m")
    ap.add_argument("--sin-camara", action="store_true")
    ap.add_argument("--sin-ventana", action="store_true", help="no abrir la ventana en vivo (igual guarda el mosaico)")
    from tools.pantalla import agregar_opcion
    agregar_opcion(ap)
    a = ap.parse_args()
    cfg = cargar()
    cc = cfg.camara
    radio = min(1.0, max(0.05, a.radio))
    circulo = puntos_circulo(cc, radio, max(4, a.pasos))
    print(f"Inclinación X 2 {cc.servo_pitch_min}..{cc.servo_pitch_max} (frente {cc.servo_pitch_centro}), giro X 3 "
          f"{cc.servo_yaw_min}..{cc.servo_yaw_max} (frente {cc.servo_yaw_centro}); círculo al {100 * radio:.0f} %: "
          f"{len(circulo)} puntos por vuelta, {a.periodo:.0f} s por vuelta")

    from cafebot.drivers.mega import Mega
    if a.sim:
        from tests.sim_serial import SerialSimulado
        mega = Mega("sim")
        mega.conectar(serial_obj=SerialSimulado())
    else:
        from cafebot.drivers.puertos import resolver
        mega = Mega(resolver(a.mega or cfg.puertos.mega, "mega"))
        mega.conectar()
    cam = None
    if not a.sin_camara and not a.sim:
        try:
            from cafebot.vision.camara import abrir_para_mision
            cam = abrir_para_mision()
        except Exception as e:
            print(f"(sin cámara: {e}) — sigo solo con los servos")
    pantalla = None
    if cam is not None and not a.sin_ventana:
        try:
            from tools.pantalla import Pantalla
            pantalla = Pantalla("Cabezal de la cámara", (960, 540), a.pantalla)
        except Exception as e:
            print(f"(sin ventana: {e}) — igual guardo el mosaico")

    if a.modo in ("calibrar", "arbol"):
        try:
            if a.modo == "arbol":
                calibrar_arbol(cfg, mega, cam, pantalla, a.dist or cfg.mision.distancia_foto_m)
            else:
                calibrar(cfg, mega, cam, pantalla)
        finally:
            mega.cerrar()
            if cam is not None:
                cam.cerrar()
        return

    giro_ok = True

    def mandar(p, y):
        nonlocal giro_ok
        r = mega.comando(f"X 2 {p}")
        if not r.startswith("OK"):
            print(f"  X 2 {p}: {r}")
        if giro_ok:
            r = mega.comando(f"X 3 {y}")
            if not r.startswith("OK"):
                giro_ok = False
                print(f"  X 3 {y}: {r}\n  El giro está DESACTIVADO en el firmware: solo se mueve la inclinación. Para "
                      "activarlo: AUX_ACTIVO = { true, true, true, true } en firmware/mega_cafebot/config.h y recargar")

    fotos, video = [], None
    salir = False
    try:
        mandar(cc.servo_pitch_centro, cc.servo_yaw_centro)
        time.sleep(0.8)
        espera = a.periodo / len(circulo)
        for v in range(a.vueltas):
            for p, y in circulo:
                t0 = time.monotonic()
                mandar(p, y)
                txt = f"X 2 = {p}   X 3 = {y if giro_ok else '-'}"
                print(f"  vuelta {v + 1}: {txt}", end="\r", flush=True)
                if cam is not None:
                    import cv2
                    time.sleep(min(0.25, espera * 0.6))          # que el servo llegue antes de la foto
                    img = cam.capturar()
                    marca = img.copy()
                    cv2.putText(marca, txt, (20, 50), cv2.FONT_HERSHEY_SIMPLEX, 1.4, (0, 0, 0), 6)
                    cv2.putText(marca, txt, (20, 50), cv2.FONT_HERSHEY_SIMPLEX, 1.4, (0, 255, 255), 2)
                    h, w = marca.shape[:2]
                    cv2.line(marca, (w // 2 - 30, h // 2), (w // 2 + 30, h // 2), (0, 255, 255), 2)   # centro
                    cv2.line(marca, (w // 2, h // 2 - 30), (w // 2, h // 2 + 30), (0, 255, 255), 2)
                    if v == 0:
                        fotos.append(marca)
                    if video is None:
                        os.makedirs("capturas", exist_ok=True)
                        ruta_video = time.strftime("capturas/cabezal_%Y%m%d_%H%M%S.mp4")
                        video = cv2.VideoWriter(ruta_video, cv2.VideoWriter_fourcc(*"mp4v"),
                                                max(1.0, 1.0 / max(espera, 0.05)), (w // 2, h // 2))
                    video.write(cv2.resize(marca, (w // 2, h // 2)))
                    if pantalla is not None:
                        salir = mostrar(pantalla, marca)
                        if salir:
                            break
                time.sleep(max(0.0, espera - (time.monotonic() - t0)))
            if salir:
                break
        print()
    except KeyboardInterrupt:
        print("\n(interrumpido)")
    finally:
        try:
            mandar(cc.servo_pitch_centro, cc.servo_yaw_centro)
            time.sleep(0.5)
            print(f"Cámara de vuelta al frente (X 2 {cc.servo_pitch_centro}"
                  + (f", X 3 {cc.servo_yaw_centro})" if giro_ok else ")"))
        finally:
            mega.cerrar()
            if cam is not None:
                cam.cerrar()
            if video is not None:
                video.release()
                print(f"Video: pi/{ruta_video}")
            if fotos:
                import cv2
                m = mosaico(fotos)
                ruta = time.strftime("capturas/cabezal_%Y%m%d_%H%M%S.jpg")
                cv2.imwrite(ruta, m)
                print(f"Mosaico (una foto por punto de la primera vuelta): pi/{ruta}")


def leer_tecla(timeout: float):
    """Una tecla de la terminal sin ENTER ('' si no hubo). Flechas -> 'arriba'/'abajo'/'izq'/'der'."""
    import select
    import sys
    if not select.select([sys.stdin], [], [], timeout)[0]:
        return ""
    c = os.read(sys.stdin.fileno(), 1).decode(errors="ignore")
    if c == "\x1b":
        if select.select([sys.stdin], [], [], 0.05)[0]:
            resto = os.read(sys.stdin.fileno(), 2).decode(errors="ignore")
            return {"[A": "arriba", "[B": "abajo", "[C": "der", "[D": "izq"}.get(resto, "")
        return "q"                                              # ESC solo
    return c


def guardar_frente(cfg, p: int, y: int) -> None:
    """X 2 / X 3 actuales = cámara al frente: robot_local.json + lo que hay que pegar en config.py y el firmware."""
    from cafebot.config import guardar_local
    cc = cfg.camara
    p90 = round((90 - p) * cc.pitch_por_grado, 2)     # que servo_de_pitch(0) == p con la relación servo -> inclinación
    cc.servo_pitch_centro, cc.servo_yaw_centro, cc.pitch_servo_90_deg = p, y, p90
    ruta = guardar_local("camara", {"servo_pitch_centro": p, "servo_yaw_centro": y, "pitch_servo_90_deg": p90})
    print(f"\r\nGuardado en {ruta}: al frente = X 2 {p}, X 3 {y} (pitch_servo_90_deg = {p90}).\r\n"
          "Copiarlo también (robot_local.json se pierde con la SD):\r\n"
          f"  pi/cafebot/config.py, ConfigCamara:  servo_pitch_centro: int = {p}   servo_yaw_centro: int = {y}"
          f"   pitch_servo_90_deg: float = {p90}\r\n"
          f"  firmware/mega_cafebot/config.h:  AUX_INICIAL_DEG[N_SERVOS_AUX] = {{ 90, 90, {p}, {y} }};  (y recargar)\r\n"
          "  (la misión igual manda X 2 / X 3 al frente al conectarse, con lo guardado)\r\n")


def calibrar(cfg, mega, cam, pantalla):
    """Mover a mano X 2 / X 3 con el teclado hasta que la cámara mire derecho adelante, y guardarlo."""
    import sys
    import termios
    import tty
    cc = cfg.camara
    p, y = int(cc.servo_pitch_centro), int(cc.servo_yaw_centro)
    giro = {"ok": True}

    def mandar():
        r = mega.comando(f"X 2 {p}")
        if not r.startswith("OK"):
            print(f"\r\nX 2 {p}: {r}\r")
        if giro["ok"]:
            r = mega.comando(f"X 3 {y}")
            if not r.startswith("OK"):
                giro["ok"] = False
                print(f"\r\nX 3: {r} (giro desactivado en el firmware: AUX_ACTIVO). Solo la inclinación.\r")

    print(__doc__.split("\n\n")[0])
    print("w/s ↑/↓ inclinación (X 2) | a/d ←/→ giro (X 3) | MAYÚSCULA = 5° | c = volver al guardado | "
          "g = guardar como al frente | q = salir\n")
    viejo = termios.tcgetattr(sys.stdin)
    tty.setcbreak(sys.stdin.fileno())
    try:
        mandar()
        while True:
            txt = f"X 2 = {p}  ({cc.servo_pitch_min}..{cc.servo_pitch_max})   X 3 = {y if giro['ok'] else '-'}  " \
                  f"({cc.servo_yaw_min}..{cc.servo_yaw_max})"
            print(f"\r  {txt}     ", end="", flush=True)
            if cam is not None and pantalla is not None:
                import cv2
                img = cam.capturar()
                h, w = img.shape[:2]
                for (x0, y0, x1, y1) in ((0, h // 2, w, h // 2), (w // 2, 0, w // 2, h)):      # cruz de lado a lado
                    cv2.line(img, (x0, y0), (x1, y1), (0, 255, 255), 2)
                for f in (0.25, 0.75):                                                          # guías
                    cv2.line(img, (0, int(h * f)), (w, int(h * f)), (0, 160, 160), 1)
                    cv2.line(img, (int(w * f), 0), (int(w * f), h), (0, 160, 160), 1)
                cv2.putText(img, txt, (20, 50), cv2.FONT_HERSHEY_SIMPLEX, 1.2, (0, 0, 0), 6)
                cv2.putText(img, txt, (20, 50), cv2.FONT_HERSHEY_SIMPLEX, 1.2, (0, 255, 255), 2)
                if mostrar(pantalla, img):
                    break
            k = leer_tecla(0.03 if cam is not None else 0.5)
            if not k:
                continue
            paso = 5 if k in "WASD" and len(k) == 1 else 1
            k = {"arriba": "w", "abajo": "s", "izq": "a", "der": "d"}.get(k, k.lower())
            if k == "q":
                break
            if k == "g":
                guardar_frente(cfg, p, y)
                continue
            if k == "c":
                p, y = int(cc.servo_pitch_centro), int(cc.servo_yaw_centro)
            elif k in "ws":
                p = min(cc.servo_pitch_max, max(cc.servo_pitch_min, p + (paso if k == "w" else -paso)))
            elif k in "ad":
                y = min(cc.servo_yaw_max, max(cc.servo_yaw_min, y + (paso if k == "d" else -paso)))
            else:
                continue
            mandar()
    finally:
        termios.tcsetattr(sys.stdin, termios.TCSADRAIN, viejo)
        print()


def calibrar_arbol(cfg, mega, cam, pantalla, dist: float):
    """La inclinación de la cámara para la foto del árbol (misión: camara.inclinacion_arbol_deg), con los 16 soportes
    dibujados donde el modelo los espera desde `dist` (frente del robot -> pie, robot centrado y derecho)."""
    import sys
    import termios
    import tty
    import numpy as np
    from cafebot.config import guardar_local
    from cafebot.vision import granos
    from cafebot.vision.arbol import ModeloArbol
    from cafebot.vision.camara_modelo import CamaraPinhole
    cc = cfg.camara
    p = cc.servo_de_pitch(cc.inclinacion_arbol_deg)
    modelo = ModeloArbol.cargar(cc.arbol)
    pie = (dist + cfg.geometria.largo / 2, 0.0, 0.0)          # cara del pie en el robot (centrado, derecho)
    print("Robot CENTRADO y DERECHO frente al pie, el frente a "
          f"{100 * dist:.0f} cm. w/s ↑/↓ mueven la cámara (X 2). Para que los círculos calcen con los soportes reales: "
          "i/k suben/bajan (inclinación), j/l izquierda/derecha (giro), u/o los rotan (roll), 0,5° por tecla. "
          "g guarda; q sale.\n")
    viejo = termios.tcgetattr(sys.stdin)
    tty.setcbreak(sys.stdin.fileno())
    try:
        mega.comando(f"X 2 {p}")
        while True:
            incl = cc.pitch_de_servo(p)
            txt = (f"X 2 = {p} -> camara {incl:+.1f} (X2=90 -> {cc.pitch_servo_90_deg:+.1f}) | giro {cc.yaw_deg:+.1f}"
                   f" roll {cc.roll_deg:+.1f}")
            print(f"\r  {txt}     ", end="", flush=True)
            if cam is not None and pantalla is not None:
                import cv2
                img = cam.capturar()
                h, w = img.shape[:2]
                c = CamaraPinhole.desde_config(cc, incl)
                if (w, h) != (c.ancho, c.alto):
                    c = c.escalada(w, h)
                vis = 0
                proy = granos.proyectar_soportes(c, modelo, pie)
                rs = [q[2] for q in proy.values()] or [40.0]
                for d in granos.detectar(img, 0.5 * min(rs), 1.6 * max(rs), cc.sat_min, cc.val_min, cc.excluir_h):
                    cv2.circle(img, (int(d.u), int(d.v)), int(d.r), (0, 255, 0), 3)       # pelotas detectadas
                for clave, (u, v, r, _) in proy.items():
                    if 0 <= u < w and 0 <= v < h:
                        vis += 1
                    cv2.circle(img, (int(u), int(v)), max(3, int(r)), (255, 0, 255), 2)
                cv2.line(img, (0, h // 2), (w, h // 2), (0, 160, 160), 1)
                t2 = f"{txt} | soportes en la foto {vis}/16"
                cv2.putText(img, t2, (20, 50), cv2.FONT_HERSHEY_SIMPLEX, 1.0, (0, 0, 0), 6)
                cv2.putText(img, t2, (20, 50), cv2.FONT_HERSHEY_SIMPLEX, 1.0, (0, 255, 255), 2)
                if mostrar(pantalla, img):
                    break
            k = leer_tecla(0.03 if cam is not None else 0.5)
            if not k:
                continue
            paso = 5 if k in "WS" and len(k) == 1 else 1
            k = {"arriba": "w", "abajo": "s"}.get(k, k.lower())
            if k == "q":
                break
            if k == "g":
                cc.inclinacion_arbol_deg = round(cc.pitch_de_servo(p), 2)
                ruta = guardar_local("camara", {"inclinacion_arbol_deg": cc.inclinacion_arbol_deg,
                                                "pitch_servo_90_deg": cc.pitch_servo_90_deg,
                                                "yaw_deg": cc.yaw_deg, "roll_deg": cc.roll_deg})
                print(f"\r\nGuardado en {ruta}: inclinacion_arbol_deg = {cc.inclinacion_arbol_deg} (X 2 = {p}), "
                      f"pitch_servo_90_deg = {cc.pitch_servo_90_deg}, yaw_deg = {cc.yaw_deg}, roll_deg = {cc.roll_deg}. "
                      "Subir robot_local.json al repo.\r")
                continue
            if k in "ws":
                p = min(cc.servo_pitch_max, max(cc.servo_pitch_min, p + (paso if k == "w" else -paso)))
                mega.comando(f"X 2 {p}")
            elif k in "ik":                        # misma X 2, la cámara mira distinto de lo que se creía
                cc.pitch_servo_90_deg = round(cc.pitch_servo_90_deg + (0.5 if k == "i" else -0.5), 2)
            elif k in "jl":                        # el cabezal mira corrido de lado (el servo del giro está suelto)
                cc.yaw_deg = round(cc.yaw_deg + (0.5 if k == "j" else -0.5), 2)
            elif k in "uo":                        # la cámara está montada torcida
                cc.roll_deg = round(cc.roll_deg + (0.5 if k == "u" else -0.5), 2)
    finally:
        termios.tcsetattr(sys.stdin, termios.TCSADRAIN, viejo)
        print()


def mostrar(pantalla, img_bgr) -> bool:
    """Dibuja la foto en la ventana (ajustada al tamaño). True si apretaron ESC / Q o cerraron la ventana."""
    import cv2
    import pygame as pg
    for ev in pg.event.get():
        if ev.type == pg.QUIT or (ev.type == pg.KEYDOWN and ev.key in (pg.K_ESCAPE, pg.K_q)):
            return True
        pantalla.tecla(ev)
    sup = pantalla.sup
    W, H = sup.get_size()
    h, w = img_bgr.shape[:2]
    e = min(W / w, H / h)
    rgb = cv2.cvtColor(cv2.resize(img_bgr, (int(w * e), int(h * e))), cv2.COLOR_BGR2RGB)
    s = pg.image.frombuffer(rgb.tobytes(), (rgb.shape[1], rgb.shape[0]), "RGB")
    sup.fill((0, 0, 0))
    sup.blit(s, ((W - s.get_width()) // 2, (H - s.get_height()) // 2))
    pg.display.flip()
    return False


if __name__ == "__main__":
    main()
