MauriceTZ/Cafebot/pi/tools/cosecha.py

"""Cosecha de PRUEBA frente a un árbol: cámara + LiDAR + brazo (+ la base para acercarse y alejarse).

Qué hace (detalles en docs/cosecha.md):
  1. Mide el pie del árbol con el LiDAR (x, y, ángulo) y saca fotos.
  2. Busca las pelotas (manchas de color redondas; el soporte tapa su parte de abajo), las asigna a los soportes
     del modelo del árbol y AJUSTA la pose del árbol y la de la cámara (fusión cámara + LiDAR).
  3. Proyección inversa: la posición 3D de cada grano en el robot (x adelante, y izquierda, z desde el suelo).
  4. Color -> categoría (maduro / sobremaduro / verde / vacío / no sé). Ante la duda, no se toca.
  5. El brazo agarra el grano elegido (o el más cercano) con su cinemática inversa y lo deja en la canasta de su
     categoría (posturas deposito_maduro / deposito_sobremaduro, grabadas con tools.brazo).
  Las posiciones se guardan en el marco del ÁRBOL: si la base se acerca (A) la cámara ya no ve bien el árbol, pero el
  LiDAR sí ve el pie y con eso se recalcula dónde quedó cada grano.

En la Raspberry (escritorio por VNC), con el robot frente al árbol, el frente a ~60 cm del pie:
    python3 -m tools.cosecha                          # todo: cámara, LiDAR, Mega y brazo
    python3 -m tools.cosecha --sin-brazo              # solo ver (no mueve el brazo)
    python3 -m tools.cosecha --sin-mega               # la base no se mueve: A, R y flechas dicen cuánto mover el ÁRBOL a mano
    python3 -m tools.cosecha --arbol taller           # modelo del árbol de prueba (pi/arboles/taller.json)
    python3 -m tools.cosecha --arbol taller --crear-arbol   # crea ese archivo (con las medidas de competencia) para editar
    python3 -m tools.cosecha --imagen capturas/F.jpg --frente 0.60    # fotos guardadas, sin robot (prior a mano)
    python3 -m tools.cosecha --imagen F.jpg --frente 0.60 --texto     # sin ventana: imprime y guarda la imagen marcada
    python3 -m tools.cosecha --sim                    # todo simulado: árbol sintético, Mega, LiDAR y brazo falsos

Ratón: clic sobre un soporte = elegirlo.
Teclas:
  ESPACIO  LiDAR + fotos + análisis               L  vista en vivo (sin análisis) sí/no      S  guardar fotos + análisis
  1..7     enseñar el color del soporte elegido: 1 ROJO 2 NARANJO 3 AMARILLO 4 VERDE 5 AZUL 6 NEGRO 7 VACIO
  I / K    inclinar la cámara: con el Mega mueve el servo (X 2 ±2°); sin él, solo el modelo ±0,5° (prueba)
  C        calibrar la cámara con el árbol + LiDAR (se promedia y se guarda; hecho con 2+ ángulos de X 2 distintos
           también mide cuántos grados de cámara da cada grado del servo)
  O        soltar / sujetar el brazo                 M  marcar: la garra (movida a mano) está en el grano elegido
  N        calibrar la cámara con las marcas del brazo (≥ 4, en distintas filas y columnas) y guardar
  P        garra al punto "antes" del grano elegido (6 cm antes, sin agarrar)     V  brazo a la postura de espera
  G        agarrar el elegido (o, sin elegir, el seguro y alcanzable más cercano) y dejarlo en su canasta
  T        agarrar todos los seguros y alcanzables (fila alta primero)
  A        acercarse (frente del robot a holgura_agarre_m del pie)   R  volver a la distancia de la foto
  ↑ / ↓    avanzar / retroceder 2 cm      ← / →  cangrejo 2 cm a la izquierda / derecha (granos de los costados)
  U        volver a ubicar el árbol solo con el LiDAR (sin foto: sirve de cerca; p. ej. después de moverlo a mano)
  ESC      parar (base y brazo, después del movimiento en curso)      Q  salir      F11  pantalla completa sí/no
Lanzado por SSH con la ventana en la pantalla de la Raspberry (HDMI), se abre en pantalla completa (--pantalla).
"""
from __future__ import annotations

import argparse
import collections
import copy
import json
import math
import os
import pathlib
import sys
import tempfile
import threading
import time
import traceback

import cv2
import numpy as np

from cafebot.config import cargar, guardar_local
from cafebot.mundo import cancha
from cafebot.navegacion.geometria import componer, relativo
from cafebot.vision import clasificador as cl
from cafebot.vision import granos as G
from cafebot.vision.arbol import ModeloArbol, medir_pie
from cafebot.vision.camara_modelo import CamaraPinhole, lente_cabezal, lente_de_referencia
from tools import pantalla

TECLAS_CLASE = ("ROJO", "NARANJO", "AMARILLO", "VERDE", "AZUL", "NEGRO", "VACIO")   # teclas 1..7
COLOR_CAT = {"MADURO": (60, 70, 255), "SOBREMADURO": (255, 130, 60), "VERDE": (70, 210, 70),
             "VACIO": (150, 150, 150), "NO_SE": (0, 220, 255), "FUERA": (95, 95, 95)}            # BGR
CORTO = {"ROJO": "ROJ", "NARANJO": "NAR", "AMARILLO": "AMA", "VERDE": "VER", "AZUL": "AZU", "NEGRO": "NEG",
         "VACIO": "vac", cl.NO_SE: "?", "FUERA": "---"}


def _grados(dcam) -> str:
    return "Δincl {:+.1f}° Δyaw {:+.1f}° Δroll {:+.1f}°".format(*np.degrees(dcam))


def lab_zona(img, u, v, r, config):
    """Lab mediano (sin brillos) de un círculo de la imagen, o None si se sale."""
    h, w = img.shape[:2]
    rr, uu, vv = max(2, int(round(r))), int(round(u)), int(round(v))
    if not (rr <= uu < w - rr and rr <= vv < h - rr):
        return None
    lab = cl.imagen_a_lab(img[vv - rr:vv + rr + 1, uu - rr:uu + rr + 1])
    return cl.color_zona(lab, rr, rr, rr, dict(config, fraccion_radio=1.0))


# ---------------------------------------------------------------------------- simulación
class MundoSim:
    """Un árbol sintético FIJO en el mundo; el robot (Mega simulado) se mueve. La cámara 'real' tiene un error de
    montaje (inclinación, yaw, roll, posición) que la calibración tiene que encontrar."""

    def __init__(self, cfg, modelo: ModeloArbol, mega=None, frente=0.62, lateral=0.0, ang_deg=3.0, semilla=None,
                 colores=None, bus_falso=None, error_camara=True):
        from cafebot.vision.sintetica import CamaraSintetica, LidarPie
        rng = np.random.default_rng(semilla)
        self.modelo, self.mega, self.bus_falso = modelo, mega, bus_falso
        self.pie_mundo = np.array([cfg.geometria.largo / 2 + frente, lateral, math.radians(ang_deg)])
        if colores is None:
            clases = ["ROJO", "NARANJO", "AMARILLO", "VERDE", "AZUL", "NEGRO", None]
            colores = {ModeloArbol.nombre_de(c): clases[int(rng.integers(len(clases)))] for c, _, _ in modelo.soportes()}
        self.colores = colores
        self.cc = copy.copy(cfg.camara)            # la cámara de verdad no cambia cuando se calibra la config
        c = CamaraPinhole.desde_config(cfg.camara)
        self.err_pitch, self.err_pos, self.err_pendiente = 0.0, np.zeros(3), 0.0
        if error_camara:
            self.err_pitch = rng.uniform(-2.5, 2.5)
            c = c.con(pitch=c.pitch + math.radians(self.err_pitch), yaw=c.yaw + math.radians(rng.uniform(-1.5, 1.5)),
                      roll=c.roll + math.radians(rng.uniform(-1.2, 1.2)), pos=c.pos + rng.normal(0, 0.004, 3))
            self.err_pos = c.pos - CamaraPinhole.desde_config(cfg.camara).pos
            self.err_pendiente = np.random.default_rng(None if semilla is None else semilla + 7).uniform(-0.08, 0.08)
        self.cam_real = c
        self.camara = CamaraSintetica(c, modelo, self.pose_pie, self.colores, semilla)
        self.lidar = LidarPie(modelo, self.pose_pie, rng=rng)
        self.errores_agarre = []
        if getattr(self.cc, "cabezal", False):
            self.servo_camara(self.cc.servo_de_pitch(self.cc.inclinacion_arbol_deg))

    def servo_camara(self, servo: float):
        """X 2 <servo> en la simulación: la inclinación real tiene un error fijo y la pendiente del servo otro."""
        cc = self.cc
        nominal = cc.pitch_servo_90_deg + cc.pitch_por_grado * (1 + self.err_pendiente) * (servo - 90)
        self.cam_real = self.cam_real.con(pitch=math.radians(nominal + self.err_pitch),
                                          pos=lente_cabezal(cc, nominal) + self.err_pos)
        self.camara.cam_real = self.cam_real

    def pose_robot(self) -> np.ndarray:
        if self.mega is None:
            return np.zeros(3)
        from cafebot.drivers.ir_simulado import pose_mega_extrapolada
        return pose_mega_extrapolada(self.mega)

    def pose_pie(self):
        return tuple(float(v) for v in relativo(self.pose_robot(), self.pie_mundo))

    def grano_real(self, clave) -> np.ndarray:
        return self.modelo.en_robot(self.pose_pie())[clave]

    def antes_de_agarrar(self, clave, p, brazo=None):
        """El bus falso 'tiene grano' si la garra va a menos de 12 mm del grano real (la garra abre 65 mm, el grano
        mide 42: sobra ~11 mm por lado)."""
        err = float(np.linalg.norm(self.grano_real(clave) - np.asarray(p)))
        self.errores_agarre.append(err)
        if self.bus_falso is not None:
            self.bus_falso.grano = self.colores.get(ModeloArbol.nombre_de(clave)) is not None and err < 0.012

    def quitar(self, clave):
        self.colores[ModeloArbol.nombre_de(clave)] = None


def posturas_sim(brazo):
    """Posturas para el brazo simulado (en el robot se enseñan a mano con tools.brazo leer + G)."""
    brazo.perfil.posturas.update({
        "deposito_maduro": {"base": -150.0, "hombro": -25.0, "codo1": 60.0, "codo2": 60.0, "muneca": 40.0},
        "deposito_sobremaduro": {"base": 135.0, "hombro": -25.0, "codo1": 60.0, "codo2": 60.0, "muneca": 40.0},
        "transporte": {"base": 0.0, "hombro": -10.0, "codo1": 70.0, "codo2": 80.0, "muneca": 20.0}})


# ---------------------------------------------------------------------------- la sesión (sin ventana)
class Cosecha:
    """Lógica de la herramienta (la usan la ventana y las pruebas)."""

    def __init__(self, cfg, modelo: ModeloArbol, camara, lidar=None, mega=None, brazo=None, mundo=None,
                 clasif: cl.Clasificador | None = None, prior_fijo=None, categorias=("MADURO", "SOBREMADURO"),
                 ruta_local=None, ruta_referencias=None, confianza_min=None, log=print):
        self.cfg, self.modelo, self.camara, self.lidar, self.mega, self.brazo, self.mundo = (
            cfg, modelo, camara, lidar, mega, brazo, mundo)
        self.clasif = clasif if clasif is not None else cl.Clasificador()
        self.prior_fijo = prior_fijo                # (pose, σ) cuando no hay LiDAR (fotos guardadas)
        self.categorias = tuple(categorias)
        self.confianza_min = cfg.mision.confianza_min if confianza_min is None else float(confianza_min)
        self.ruta_local = ruta_local                # None = pi/robot_local.json
        self.ruta_referencias = ruta_referencias or cl.ARCHIVO_REFERENCIAS
        self._log = log
        self.cam = CamaraPinhole.desde_config(cfg.camara)
        self.analisis: G.Analisis | None = None
        self.imgs: list = []
        self.pose_pie = None                        # pie del árbol en el robot (medido/ajustado; se sigue al mover)
        self.scan_xy = None
        self.medida = None
        self.sel = None                             # clave del soporte elegido
        self.marcas: list = []                      # calibración con el brazo: (p garra, (u, v), nombre, k, ancho img)
        self.calibs: list = []                      # (pitch, yaw, roll) de cada C
        self.tomados: set = set()
        self.alcance: dict = {}                     # clave -> el brazo lo alcanza (se recalcula al medir/mover)
        self.delta_lidar = (0.0, 0.0)               # árbol ajustado − medida del LiDAR (x, y): ver analizar()
        self.suelto = False
        self.ocupado = ""
        self.version = 0                            # cambia cuando hay algo nuevo que dibujar
        self._hilo = None
        self.mensajes = collections.deque(maxlen=14)
        self.servo_pitch = None                     # ángulo de X 2 (None = sin cabezal o sin Mega: no se sabe)
        if mega is not None and getattr(cfg.camara, "cabezal", False):
            self.servo_camara(cfg.camara.servo_de_pitch(cfg.camara.inclinacion_arbol_deg))

    def log(self, txt: str):
        self.mensajes.append(txt)
        self.version += 1
        self._log(txt)

    # ------------------------------------------------------------------ tareas en segundo plano
    def en_fondo(self, nombre: str, f, *args) -> bool:
        if self.ocupado:
            self.log(f"espera: todavía {self.ocupado}")
            return False
        self.ocupado = nombre

        def correr():
            try:
                f(*args)
            except RuntimeError as e:          # avisos esperables (no ve el árbol, demasiado cerca...): sin traza
                self.log(f"[{nombre}] {e}")
            except Exception as e:
                self.log(f"[{nombre}] error: {e}")
                traceback.print_exc()
            finally:
                self.ocupado = ""
                self.version += 1
        self._hilo = threading.Thread(target=correr, name=nombre, daemon=True)
        self._hilo.start()
        return True

    def esperar(self, timeout=None):
        if self._hilo is not None:
            self._hilo.join(timeout)

    # ------------------------------------------------------------------ medir
    def sig_cam(self):
        return (math.radians(0.6),) * 3 if self.cfg.camara.calibrada else None

    def medir_lidar(self):
        if self.lidar is None:
            return None
        s = self.lidar.esperar_scan(1.5) or self.lidar.ultimo_scan()
        if s is None:
            self.log("LiDAR: no llegan barridos")
            return None
        x, y = s.xy()
        self.scan_xy = np.column_stack((x, y))
        if self.pose_pie is not None:
            esperado = self.pose_pie[:2]
        elif self.prior_fijo is not None:              # --frente / --lateral: dónde buscarlo
            esperado = self.prior_fijo[0][:2]
        else:
            esperado = None
        # Sin saber dónde está, el árbol se busca desde 10 cm delante del LiDAR: lo que ve pegado a él suele ser el
        # piso (va muy bajo), un cable o una pieza del robot
        x_min = self.cfg.geometria.lidar_x + 0.10
        med = medir_pie(self.scan_xy, self.modelo, esperado, x_min=x_min)
        if med is None and esperado is not None:
            med = medir_pie(self.scan_xy, self.modelo, x_min=x_min)
        self.medida = med
        if med is None:
            delante = self.scan_xy[(self.scan_xy[:, 0] > 0.05) & (np.abs(self.scan_xy[:, 1]) < 0.4)]
            cerca = (f"; lo más cercano delante está a {100 * (delante[:, 0].min() - self.cfg.geometria.largo / 2):.0f} cm "
                     "del frente" if len(delante) else "; no ve nada delante")
            self.log(f"LiDAR: no encuentro el pie del árbol{cerca}")
        else:
            self.log(f"LiDAR: pie a {100 * (med.x_cara - self.cfg.geometria.largo / 2):.1f} cm del frente, "
                     f"{100 * med.y_centro:+.1f} cm de lado, {math.degrees(med.ang):+.1f}°, ancho {100 * med.ancho:.0f} cm "
                     f"({med.n} puntos)" + ("" if med.centro_medido else
                                            f" | el modelo dice {100 * self.modelo.pie_ancho_m:.0f} cm de ancho"))
        return med

    def prior(self):
        """(pose esperada del pie, σ, medida del LiDAR o None)."""
        med = self.medir_lidar()
        if med is not None:
            return med.pose, med.sigma, med
        if self.prior_fijo is not None:
            return self.prior_fijo[0], self.prior_fijo[1], None
        if self.pose_pie is not None:
            self.log("el LiDAR no ve el pie: uso la última pose del árbol")
            return self.pose_pie, (0.03, 0.03, math.radians(4.0)), None
        raise RuntimeError("el LiDAR no ve el pie del árbol (¿delante, a menos de 1,6 m?) y no se dio --frente")

    def analizar(self, fotos_nuevas: bool = True) -> G.Analisis:
        pose0, sig, med = self.prior()
        d = pose0[0] - self.modelo.grano_delante_m - self.cam.pos[0]
        if d < 0.30:
            if self.analisis is None:
                raise RuntimeError(
                    f"el pie del árbol quedaría a {100 * (pose0[0] - self.cfg.geometria.largo / 2):.0f} cm del frente "
                    f"(los granos a {100 * d:.0f} cm de la cámara): si el robot está a ~60 cm, lo que se midió no es el "
                    "árbol (¿el LiDAR ve el piso o una pieza del robot? mirar la vista desde arriba o "
                    "python3 -m tools.visor_lidar). Mientras: --frente 0.60 dice dónde buscarlo")
            raise RuntimeError(f"los granos están a {100 * d:.0f} cm de la cámara: demasiado cerca para la foto "
                               f"(R vuelve a {100 * self.cfg.mision.distancia_foto_m:.0f} cm); lo ya medido sigue valiendo")
        if fotos_nuevas or not self.imgs:
            self.imgs = [self.camara.capturar() for _ in range(max(1, int(self.cfg.camara.fotos)))]
        cc = self.cfg.camara
        t0 = time.monotonic()
        a = G.analizar(self.imgs, self.cam, self.modelo, pose0, sig, self.clasif if self.clasif.muestras else None,
                       med, cc.sat_min, cc.val_min, sig_cam=self.sig_cam(),
                       excluir_h=cc.excluir_h)
        for k in self.tomados:
            if k in a.granos:
                a.granos[k].tomado = True
        # De cerca la foto ve solo una parte del árbol: lo que quedó fuera se mantiene como se vio antes (su
        # posición está en el marco del árbol, así que sigue valiendo con la pose nueva)
        heredados = 0
        if self.analisis is not None:
            for k, g in a.granos.items():
                v = self.analisis.granos.get(k)
                if g.categoria == "FUERA" and v is not None and v.categoria != "FUERA":
                    v.uv, v.r_px, v.det = g.uv, g.r_px, None
                    a.granos[k] = v
                    heredados += 1
        self.analisis, self.pose_pie = a, a.pose
        # Con la cámara calibrada CON EL BRAZO (M + N), la foto da las posiciones en el sistema del brazo: si el LiDAR
        # está corrido (lidar_x/y mal medidos), esa diferencia se sigue aplicando al volver a ubicar el árbol. Si no,
        # manda el LiDAR (con la cámara calibrada con el LiDAR, la diferencia sería solo ruido de la foto).
        if med is not None and "brazo" in (self.cfg.camara.calibrada or ""):
            self.delta_lidar = (a.pose[0] - med.x_cara, (a.pose[1] - med.y_centro) if med.centro_medido else 0.0)
        elif med is not None:
            self.delta_lidar = (0.0, 0.0)
        self._actualizar_alcance()
        cuenta = collections.Counter(g.categoria for g in a.granos.values())
        self.log(f"análisis ({time.monotonic() - t0:.1f} s): pie x {a.pose[0]:.3f} y {a.pose[1]:+.3f} "
                 f"{math.degrees(a.pose[2]):+.1f}° | {_grados(a.dcam)} | {a.n_asignadas} granos, error "
                 f"{a.error_px:.1f} px | " + " ".join(f"{k} {v}" for k, v in sorted(cuenta.items())))
        for m in a.mensajes:
            self.log("  " + m)
        if heredados:
            self.log(f"  {heredados} soporte(s) fuera de esta foto: quedan como se vieron en la anterior")
        matiz = [g for g in a.granos.values() if g.det is not None and g.det.por_matiz and g.categoria in self.categorias]
        if matiz and max(g.confianza for g in matiz) < self.confianza_min:
            self.log(f"  por matiz la confianza es {max(g.confianza for g in matiz):.1f} < {self.confianza_min:.1f}: no se "
                     "agarra nada hasta enseñar los colores (clic + 1..7) o bajar --confianza")
        return a

    # ------------------------------------------------------------------ granos
    def p_robot(self, g) -> np.ndarray:
        """Centro del grano en el robot AHORA (desde su posición en el árbol y la última pose del pie)."""
        return self.modelo.desde_arbol(g.q_arbol, self.pose_pie)

    def seguros(self) -> list:
        if self.analisis is None:
            return []
        return [g for g in self.analisis.seguros(self.categorias, self.confianza_min)
                if g.clave not in self.tomados]

    def _actualizar_alcance(self):
        if self.brazo is None or self.analisis is None:
            self.alcance = {}
            return
        self.alcance = {k: g.categoria != "FUERA" and self.brazo.alcanzable(self.p_robot(g))
                        for k, g in self.analisis.granos.items()}

    def alcanzable(self, g) -> bool:
        return bool(self.alcance.get(g.clave, False))

    def base_brazo(self) -> np.ndarray:
        cm = self.cfg.mision
        return self.brazo.base if self.brazo is not None else np.array([cm.brazo_x, cm.brazo_y, cm.brazo_z])

    def mas_cercano(self):
        c = [g for g in self.seguros() if self.alcanzable(g)]
        return min(c, key=lambda g: float(np.linalg.norm(self.p_robot(g) - self.base_brazo())), default=None)

    def elegir_en(self, u, v):
        """Elige el soporte cuya proyección queda más cerca del píxel (u, v) de la imagen analizada."""
        if self.analisis is None:
            return None
        mejor = None
        for k, g in self.analisis.granos.items():
            d = math.hypot(g.uv[0] - u, g.uv[1] - v) / max(g.r_px, 4.0)
            if d < 1.6 and (mejor is None or d < mejor[0]):
                mejor = (d, k)
        self.sel = mejor[1] if mejor else None
        self.version += 1
        return self.sel

    # ------------------------------------------------------------------ colores
    def ensenar(self, clase: str):
        a = self.analisis
        if a is None or self.sel is None:
            self.log("elegir un soporte (clic) en la foto analizada")
            return
        g = a.granos[self.sel]
        if g.categoria == "FUERA":
            self.log(f"{g.nombre} está fuera de la foto")
            return
        u, v, r = g.det.zona if g.det is not None and g.det.zona else G.zona_modelo(a.cam, self.modelo, a.pose, g.p,
                                                                                     g.uv, g.r_px)
        labs = [x for x in (lab_zona(img, u, v, r, self.clasif.config) for img in self.imgs) if x is not None]
        if not labs:
            self.log(f"{g.nombre}: la zona se sale de la imagen")
            return
        lab = tuple(float(x) for x in np.mean(labs, axis=0))
        self.clasif.agregar(clase, lab, f"cosecha {time.strftime('%m-%d %H:%M')} {g.nombre}")
        self.clasif.guardar(self.ruta_referencias)
        n = sum(1 for m in self.clasif.muestras if m["clase"] == clase)
        faltan = [c for c in cl.CLASES if not any(m["clase"] == c for m in self.clasif.muestras)]
        self.log(f"{g.nombre} = {clase} (Lab {lab[0]:.0f} {lab[1]:.0f} {lab[2]:.0f}): {n} muestra(s) de {clase}"
                 + (f" | faltan: {' '.join(faltan)} (mientras, salen NO_SE)" if faltan else ""))
        self.analizar(fotos_nuevas=False)

    def resumen_referencias(self) -> str:
        if not self.clasif.muestras:
            return "sin referencias: colores por MATIZ (provisorio)"
        c = collections.Counter(m["clase"] for m in self.clasif.muestras)
        return " ".join(f"{k[:3]} {c.get(k, 0)}" for k in cl.CLASES)

    # ------------------------------------------------------------------ calibrar la cámara
    def _guardar_camara(self, cam: CamaraPinhole, como: str, posicion: bool = False, mapa=None):
        """Guarda la pose (cam, con la inclinación de AHORA). Con el cabezal: la relación servo -> inclinación
        (`mapa`, o la pendiente de la config por el ángulo actual de X 2) y el lente llevado a X 2 = 90."""
        cc = self.cfg.camara
        yaw_c = getattr(cc, "yaw_cabezal_deg", 0.0)
        pitch = math.degrees(cam.pitch)
        vals = {"inclinacion_arbol_deg": round(pitch, 2), "yaw_deg": round(math.degrees(cam.yaw) - yaw_c, 2),
                "roll_deg": round(math.degrees(cam.roll), 2), "calibrada": time.strftime("%Y-%m-%d %H:%M ") + como}
        if getattr(cc, "cabezal", False):
            if self.servo_pitch is None:
                self.log("[AVISO] sin Mega no sé en qué ángulo está X 2: se guarda la inclinación, no la relación "
                         "servo -> inclinación (conectar el Mega y repetir C)")
            else:
                a, b = mapa or (pitch - cc.pitch_por_grado * (self.servo_pitch - 90), cc.pitch_por_grado)
                vals.update(pitch_servo_90_deg=round(a, 2), pitch_por_grado=round(b, 3))
                cc.pitch_servo_90_deg, cc.pitch_por_grado = vals["pitch_servo_90_deg"], vals["pitch_por_grado"]
        if posicion:
            ref = lente_de_referencia(cc, cam.pos, pitch, yaw_c)
            vals.update(x=round(float(ref[0]), 4), y=round(float(ref[1]), 4), z=round(float(ref[2]), 4))
        for k, v in vals.items():
            setattr(cc, k, v)
        self.cam = self.cam.con(pitch=cam.pitch, yaw=cam.yaw, roll=cam.roll, pos=np.array(cam.pos, float))
        ruta = guardar_local("camara", vals, self.ruta_local)
        self.log(f"cámara calibrada ({como}): incl {vals['inclinacion_arbol_deg']:+.2f}° yaw {vals['yaw_deg']:+.2f}° "
                 f"roll {vals['roll_deg']:+.2f}°" + (" lente en ({:.3f}, {:+.3f}, {:.3f})".format(*cam.pos) if posicion
                                                     else "")
                 + (f" | X 2 = 90 -> {vals['pitch_servo_90_deg']:+.1f}°, {vals['pitch_por_grado']:+.2f}°/°"
                    if "pitch_servo_90_deg" in vals else "") + f" -> {ruta}")

    def calibrar_con_arbol(self):
        """C: la cámara que mejor proyecta los granos detectados con el árbol donde lo midió el LiDAR (o --frente)."""
        a = self.analisis
        if a is None:
            self.log("primero analizar (ESPACIO)")
            return None
        ref = a.lidar.pose if a.lidar is not None else (self.prior_fijo[0] if self.prior_fijo else None)
        if ref is None:
            self.log("sin medida del pie (LiDAR o --frente) no hay con qué comparar")
            return None
        if a.lidar is not None and not a.lidar.centro_medido:
            self.log(f"el LiDAR ve {100 * a.lidar.ancho:.0f} cm de pie y el modelo dice {100 * self.modelo.pie_ancho_m:.0f}: "
                     "no midió el centro, así que no sirve de referencia (revisar pie_ancho_m del árbol)")
            return None
        asig = {d.clave: i for i, d in enumerate(a.detecciones) if d.clave is not None}
        if len(asig) < 3:
            self.log(f"hacen falta ≥ 3 granos detectados (hay {len(asig)})")
            return None
        base = self.cam.escalada(a.cam.ancho, a.cam.alto).con(pitch=a.cam.pitch)   # parte de la inclinación hallada
        cam, rms = G.calibrar_camara(a.detecciones, asig, self.modelo, ref, base)
        self.calibs.append((self.servo_pitch, math.degrees(cam.pitch), math.degrees(cam.yaw), math.degrees(cam.roll)))
        y, r = np.mean([c[2:] for c in self.calibs], axis=0)
        mapa = self._mapa_servo()
        p = (mapa[0] + mapa[1] * (self.servo_pitch - 90)) if mapa else float(np.mean([c[1] for c in self.calibs]))
        cam = self.cam.con(pitch=math.radians(p), yaw=math.radians(y), roll=math.radians(r))
        self._guardar_camara(cam, f"árbol+LiDAR, {len(self.calibs)} foto(s), {rms:.1f} px", mapa=mapa)
        if len(self.calibs) == 1:
            self.log("  mejor: repetir (ESPACIO + C) en 3-4 posiciones del robot; se promedian"
                     + (" (y con otro ángulo del servo, I/K: mide su pendiente)" if self.servo_pitch is not None else ""))
        return self.cam, rms

    def _mapa_servo(self):
        """(inclinación con X 2 = 90, grados de cámara por grado de servo) con las C hechas con el servo conocido. Con
        ángulos del servo distintos (≥ 8° de diferencia) se ajusta también la pendiente; si no, la de la config."""
        cc = self.cfg.camara
        pts = np.array([(c[0] - 90.0, c[1]) for c in self.calibs if c[0] is not None], float)
        if not getattr(cc, "cabezal", False) or not len(pts):
            return None
        b = cc.pitch_por_grado
        if np.ptp(pts[:, 0]) >= 8:
            (a, b2), *_ = np.linalg.lstsq(np.c_[np.ones(len(pts)), pts[:, 0]], pts[:, 1], rcond=None)
            if 0.6 <= abs(b2) <= 1.5:
                b = float(b2)
            else:
                self.log(f"[AVISO] la pendiente del servo sale {b2:.2f}°/° (esperable ~±1): se deja {b:.2f}; ¿se movió "
                         "la cámara en su soporte?")
        return float(np.mean(pts[:, 1] - b * pts[:, 0])), b

    def marcar(self):
        """M: la garra (movida a mano, brazo suelto) está en el grano elegido: su posición por la cinemática directa
        y dónde se vio ese grano en la foto son un par para calibrar la cámara RESPECTO DEL BRAZO."""
        if self.brazo is None or self.analisis is None or self.sel is None:
            self.log("marcar: analizar con el brazo fuera de la foto, elegir (clic) un grano detectado, llevar la "
                     "garra a ese grano (O suelta el brazo) y apretar M")
            return
        g = self.analisis.granos[self.sel]
        if g.det is None:
            self.log(f"{g.nombre}: no tiene pelota detectada en la foto")
            return
        p, _ = self.brazo.directa_robot(self.brazo.bus.angulos(self.brazo.IDS))
        self.marcas = [m for m in self.marcas if m[2] != g.nombre] + [
            (p, (g.det.u, g.det.v), g.nombre, G.incertidumbre_relativa(g.det), self.analisis.cam.ancho)]
        self.log(f"marca {len(self.marcas)}: {g.nombre}, garra en ({p[0]:.3f}, {p[1]:+.3f}, {p[2]:.3f}); la foto lo "
                 f"ponía a {1000 * np.linalg.norm(p - self.p_robot(g)):.0f} mm de ahí")

    def calibrar_con_brazo(self):
        """N: pose COMPLETA de la cámara (también la posición del lente) con las marcas del brazo."""
        if len(self.marcas) < 4:
            self.log(f"hacen falta ≥ 4 marcas en distintas filas y columnas (hay {len(self.marcas)})")
            return None
        P = np.array([m[0] for m in self.marcas])
        obs = np.array([np.asarray(m[1]) * self.cam.ancho / m[4] for m in self.marcas])
        cam, rms = G.calibrar_extrinsecos(P, obs, self.cam, [m[3] for m in self.marcas], mover_pos=True, sig_pos=0.03)
        self._guardar_camara(cam, f"brazo, {len(self.marcas)} marcas, {rms:.1f} px", posicion=True)
        return cam, rms

    def _poner_pitch(self, pitch_deg: float):
        """El modelo de la cámara con otra inclinación (con el cabezal, el lente también se mueve)."""
        cc = self.cfg.camara
        self.cam = self.cam.con(pitch=math.radians(pitch_deg),
                                pos=lente_cabezal(cc, pitch_deg, getattr(cc, "yaw_cabezal_deg", 0.0)))

    def servo_camara(self, servo: float) -> bool:
        """X 2 <servo>: inclina la cámara de verdad; el modelo sigue la relación servo -> inclinación de la config."""
        servo = int(min(self.cfg.camara.servo_pitch_max, max(self.cfg.camara.servo_pitch_min, round(servo))))   # 60..100 (5 nov)
        try:
            r = self.mega.comando(f"X 2 {servo}")
        except Exception as e:
            r = f"ERR {e}"
        if not r.startswith("OK"):
            self.log(f"X 2 {servo} -> {r} (¿firmware sin el servo de la cámara? recargarlo)")
            return False
        if self.marcas and servo != self.servo_pitch:
            self.log(f"las {len(self.marcas)} marca(s) del brazo eran con la cámara en otra inclinación: se borran")
            self.marcas = []
        self.servo_pitch = servo
        if self.mundo is not None:
            self.mundo.servo_camara(servo)
        self._poner_pitch(self.cfg.camara.pitch_de_servo(servo))
        return True

    def inclinar(self, d_deg: float):
        """I / K: con el Mega mueve el servo 2° (hacia arriba si d_deg > 0); sin él, solo el modelo (prueba)."""
        if self.mega is not None and getattr(self.cfg.camara, "cabezal", False):
            ppg = self.cfg.camara.pitch_por_grado or 1.0
            actual = self.servo_pitch if self.servo_pitch is not None else 90
            if self.servo_camara(actual + math.copysign(2, d_deg / ppg)):
                self.log(f"X 2 {self.servo_pitch}: cámara a ~{math.degrees(self.cam.pitch):.1f}° (según la relación "
                         "guardada; C la mide)")
            return
        self._poner_pitch(math.degrees(self.cam.pitch) + d_deg)
        self.log(f"inclinación de prueba {math.degrees(self.cam.pitch):.1f}° (C la calibra y la guarda)")

    # ------------------------------------------------------------------ brazo
    def _brazo_ok(self) -> bool:
        if self.brazo is None:
            self.log("sin brazo (--sin-brazo)")
            return False
        if self.suelto:
            self.log("el brazo está SUELTO: O para sujetarlo primero")
            return False
        self.brazo.parar.clear()
        return True

    def agarrar(self, clave=None) -> bool:
        if not self._brazo_ok() or self.analisis is None:
            return False
        g = self.analisis.granos.get(clave) if clave is not None else self.mas_cercano()
        if g is None:
            self.log("no hay granos seguros al alcance del brazo" + ("" if self.seguros() else " (ni seguros)")
                     + ": ¿acercarse con A?")
            return False
        if g.categoria not in self.categorias or g.confianza < self.confianza_min or g.tomado:
            self.log(f"{g.nombre}: {g.categoria} {g.clase} {g.confianza:.2f} -> no se toca")
            return False
        p = self.p_robot(g)
        if self.mundo is not None:
            self.mundo.antes_de_agarrar(g.clave, p)
        destino = "deposito_maduro" if g.categoria == cancha.MADURO else "deposito_sobremaduro"
        self.log(f"agarrando {g.nombre} ({g.clase}) en ({p[0]:.3f}, {p[1]:+.3f}, {p[2]:.3f}) -> {destino}")
        ok = self.brazo.recoger(p, g.categoria)
        if ok:
            self.tomados.add(g.clave)
            g.tomado = True
            if self.mundo is not None:
                self.mundo.quitar(g.clave)
            self.log(f"{g.nombre}: listo ({destino})")
        else:
            self.log(f"{g.nombre}: no se pudo ({self.brazo.ultimo_motivo})")
        self.version += 1
        return ok

    def agarrar_todos(self) -> int:
        orden = list(self.cfg.mision.orden_filas)
        n = 0
        for g in sorted(self.seguros(), key=lambda g: (orden.index(g.clave[0]) if g.clave[0] in orden else 9,
                                                       abs(self.p_robot(g)[1]))):
            if self.brazo is not None and self.brazo.parar.is_set():
                break
            if not self.alcanzable(g):
                self.log(f"{g.nombre}: fuera del alcance del brazo")
                continue
            n += bool(self.agarrar(g.clave))
        self.log(f"agarrados {n}")
        return n

    def antes(self) -> bool:
        if not self._brazo_ok() or self.analisis is None or self.sel is None:
            if self.sel is None:
                self.log("elegir un grano (clic)")
            return False
        g = self.analisis.granos[self.sel]
        plan = self.brazo.plan_agarre(self.p_robot(g))
        if plan is None:
            self.log(f"{g.nombre}: fuera del alcance del brazo")
            return False
        self.brazo.garra(abrir=True, esperar=False)
        ok = self.brazo._mover(plan[0][1], self.cfg.brazo.t_mov_s, "antes")
        self.log(f"{g.nombre}: garra {100 * self.cfg.brazo.aproximacion_m:.0f} cm antes del grano: ¿apunta a él? "
                 "(V vuelve)" if ok else f"{g.nombre}: {self.brazo.ultimo_motivo}")
        return ok

    def espera(self):
        if self._brazo_ok():
            self.brazo.ir_plegado(self.cfg.brazo.postura_espera)
            self.log("brazo en la postura de espera")

    def soltar(self):
        if self.brazo is None:
            self.log("sin brazo")
            return
        self.suelto = not self.suelto
        self.brazo.bus.torque(not self.suelto, self.brazo.IDS)
        self.log("brazo SUELTO (sostenlo: se cae). Llévalo a mano y M marca" if self.suelto else "brazo sujeto")

    # ------------------------------------------------------------------ base
    def _pose_mega(self) -> np.ndarray:
        from cafebot.drivers.ir_simulado import pose_mega_extrapolada
        time.sleep(0.15)
        return pose_mega_extrapolada(self.mega)

    def mover_base(self, mm: float, vel: float = 80.0, cangrejo_deg: float = 0.0) -> bool:
        """Avanza (o, con cangrejo_deg = ±90, se corre de lado: + = izquierda) y vuelve a ubicar el árbol: primero
        con la odometría y después con el LiDAR."""
        if self.mega is None:
            return self._mover_a_mano(mm, cangrejo_deg)
        p0 = self._pose_mega()
        t = 10 + 3 * abs(mm) / max(vel, 20.0)
        r = (self.mega.cangrejo(cangrejo_deg, mm, vel, timeout=t) if cangrejo_deg else
             self.mega.avanzar(mm, vel, timeout=t))
        p1 = self._pose_mega()
        if self.pose_pie is not None:                     # por odometría...
            self.pose_pie = tuple(float(v) for v in relativo(p1, componer(p0, np.array(self.pose_pie))))
        med = self._corregir_con_lidar("la odometría")    # ... y corregido con el LiDAR
        self._actualizar_alcance()
        frente = "" if self.pose_pie is None else f" | pie a {self.pose_pie[0] - self.cfg.geometria.largo / 2:.3f} m del frente"
        que = "base" if not cangrejo_deg else ("a la izquierda" if cangrejo_deg > 0 else "a la derecha")
        self.log(f"{que} {mm:+.0f} mm: {'ok' if r.ok else r.motivo}{frente}"
                 + ("" if med is not None else " (el LiDAR no vio el pie: solo odometría)"))
        return r.ok

    def _corregir_con_lidar(self, contra: str):
        """Vuelve a ubicar el pie con el LiDAR (más lo que la foto le corrigió en la última medida). El lado solo se
        acepta si queda a < 5 cm de lo esperado (`contra`: la odometría o lo pedido a mano)."""
        med = self.medir_lidar()
        if med is None or self.pose_pie is None:
            return None
        dx, dy = self.delta_lidar
        y = self.pose_pie[1]
        if med.centro_medido and abs(med.y_centro + dy - y) < 0.05:
            y = med.y_centro + dy
        elif med.centro_medido:
            self.log(f"el LiDAR pone el pie {100 * (med.y_centro + dy - y):+.0f} cm de lado respecto de {contra}: me "
                     "quedo con eso (¿otro objeto? ESPACIO vuelve a medir todo)")
        self.pose_pie = (med.x_cara + dx, y, med.ang)
        return med

    def reubicar(self) -> bool:
        """U: vuelve a ubicar el árbol SOLO con el LiDAR (sin foto, así que sirve de cerca): después de mover el
        árbol a mano (sin Mega), corrige lo que no quedó exacto."""
        if self.pose_pie is None:
            self.log("primero medir (ESPACIO)")
            return False
        if self.lidar is None:
            self.log("sin LiDAR el árbol queda donde se dijo")
            return False
        x0, y0, _ = self.pose_pie
        if self._corregir_con_lidar("lo esperado") is None:
            return False
        self._actualizar_alcance()
        x, y, ang = self.pose_pie
        self.log(f"árbol ubicado con el LiDAR: pie a {x - self.cfg.geometria.largo / 2:.3f} m del frente, "
                 f"{100 * (x - x0):+.1f} cm más lejos y {100 * (y - y0):+.1f} cm a la izquierda de lo esperado, "
                 f"{math.degrees(ang):+.1f}°")
        return True

    def _mover_a_mano(self, mm: float, cangrejo_deg: float) -> bool:
        """Sin Mega: el ÁRBOL se mueve a mano (lo que el robot avanzaría) y aquí solo se corre la pose del pie.
        Sirve para probar el brazo sin ruedas: ESPACIO a la distancia de la foto, A y acercar el árbol lo pedido."""
        if self.pose_pie is None:
            self.log("sin Mega: primero medir (ESPACIO)")
            return False
        d = mm / 1000
        dx, dy = (0.0, d if cangrejo_deg > 0 else -d) if cangrejo_deg else (d, 0.0)
        x, y, ang = self.pose_pie
        self.pose_pie = (x - dx, y - dy, ang)
        if self.prior_fijo is not None:
            (px, py, pa), sig = self.prior_fijo
            self.prior_fijo = ((px - dx, py - dy, pa), sig)
        self._actualizar_alcance()
        if dx:
            que = f"ACERCA el árbol {100 * dx:.1f} cm al robot" if dx > 0 else f"ALEJA el árbol {-100 * dx:.1f} cm del robot"
        else:
            que = f"corre el árbol {100 * abs(dy):.1f} cm a la {'DERECHA' if dy > 0 else 'IZQUIERDA'} (visto desde el robot)"
        self.log(f"sin Mega, A MANO: {que} | pie a {self.pose_pie[0] - self.cfg.geometria.largo / 2:.3f} m del frente"
                 + (": cuando esté, U lo vuelve a ubicar con el LiDAR (corrige lo que no quedó exacto)"
                    if self.lidar is not None else " (sin LiDAR queda donde se dijo: medir con huincha)"))
        return True

    def acercar(self):
        if self.pose_pie is None:
            self.log("primero medir (ESPACIO)")
            return
        d = self.pose_pie[0] - self.cfg.geometria.largo / 2 - self.cfg.mision.holgura_agarre_m
        if d < 0.005:
            self.log("ya está a la distancia de agarre")
            return True
        return self.mover_base(min(d, 0.8) * 1000, 70)

    def alejar(self):
        if self.pose_pie is None:
            self.log("primero medir (ESPACIO)")
            return
        d = self.pose_pie[0] - self.cfg.geometria.largo / 2 - self.cfg.mision.distancia_foto_m
        return self.mover_base(max(d, -0.8) * 1000, 80)

    def parar(self):
        if self.mega is not None:
            try:
                self.mega.parar()
            except Exception:
                pass
        if self.brazo is not None:
            self.brazo.parar.set()
        self.log("ESC: parar")

    # ------------------------------------------------------------------ guardar
    def resumen(self) -> dict:
        a = self.analisis
        d = {"camara": {"pitch_deg": math.degrees(self.cam.pitch), "yaw_deg": math.degrees(self.cam.yaw),
                        "roll_deg": math.degrees(self.cam.roll), "pos": [float(x) for x in self.cam.pos],
                        "servo_x2": self.servo_pitch},
             "arbol": self.modelo.nombre}
        if a is None:
            return d
        d.update(pie=[float(x) for x in a.pose], dcam_deg=[float(x) for x in np.degrees(a.dcam)],
                 error_px=float(a.error_px), mensajes=a.mensajes,
                 lidar=None if a.lidar is None else [float(x) for x in a.lidar.pose],
                 granos={g.nombre: {"clase": g.clase, "categoria": g.categoria, "confianza": round(g.confianza, 3),
                                    "p": [round(float(x), 4) for x in self.p_robot(g)],
                                    "uv": [round(float(x), 1) for x in g.uv], "tomado": g.tomado,
                                    "detectado": g.det is not None} for g in a.granos.values()})
        return d

    def guardar(self) -> str:
        os.makedirs(cl.CARPETA_CAPTURAS, exist_ok=True)
        base = os.path.join(cl.CARPETA_CAPTURAS, time.strftime("%Y%m%d_%H%M%S_cosecha"))
        for i, img in enumerate(self.imgs):
            cv2.imwrite(f"{base}_{i + 1}.jpg", img)
        if self.analisis is not None and self.imgs:
            cv2.imwrite(base + "_marcada.jpg", dibujar(self.imgs[0], self))
        with open(base + ".json", "w", encoding="utf-8") as f:
            json.dump(self.resumen(), f, indent=2, ensure_ascii=False)
        self.log(f"guardado: {base}_*.jpg / .json")
        return base


# ---------------------------------------------------------------------------- dibujo (OpenCV, BGR)
def dibujar(img, ses: Cosecha, proyectar=True):
    out = img.copy()
    a = ses.analisis
    if a is None:
        return out
    k = img.shape[1] / a.cam.ancho
    for clave, g in a.granos.items():
        if g.uv is None or not proyectar:
            continue
        u, v, r = g.uv[0] * k, g.uv[1] * k, max(3.0, g.r_px * k)
        col = COLOR_CAT.get(g.categoria, (255, 255, 255))
        cv2.circle(out, (int(u), int(v)), int(r), col, 1 if g.categoria == "FUERA" else 2, cv2.LINE_AA)
        if g.categoria == "FUERA":
            continue
        txt = f"{g.nombre} {CORTO.get(g.clase, g.clase[:3])}"
        if g.categoria in ses.categorias:
            txt += f" {g.confianza:.1f}" + ("" if ses.brazo is None or ses.alcanzable(g) else " lejos")
        if g.tomado:
            cv2.line(out, (int(u - r), int(v - r)), (int(u + r), int(v + r)), col, 2)
            cv2.line(out, (int(u - r), int(v + r)), (int(u + r), int(v - r)), col, 2)
        p = (int(u - r), int(v + r + 16))
        cv2.putText(out, txt, p, cv2.FONT_HERSHEY_SIMPLEX, 0.5, (0, 0, 0), 3, cv2.LINE_AA)
        cv2.putText(out, txt, p, cv2.FONT_HERSHEY_SIMPLEX, 0.5, col, 1, cv2.LINE_AA)
    for d in a.detecciones:
        c = (int(d.u * k), int(d.v * k))
        cv2.circle(out, c, int(d.r * k), (255, 255, 255), 1, cv2.LINE_AA)
        if d.zona:
            cv2.circle(out, (int(d.zona[0] * k), int(d.zona[1] * k)), max(1, int(d.zona[2] * k)), (255, 255, 255), 1)
        if d.clave is None:
            cv2.drawMarker(out, c, (255, 0, 255), cv2.MARKER_TILTED_CROSS, int(d.r * k), 2)
    if ses.sel is not None and ses.sel in a.granos:
        g = a.granos[ses.sel]
        cv2.circle(out, (int(g.uv[0] * k), int(g.uv[1] * k)), int(max(6, g.r_px * k) + 7), (0, 255, 255), 3, cv2.LINE_AA)
    return out
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
