MauriceTZ/Cafebot/pi/tests/test_compuertas.py

"""Compuertas Dynamixel (config.compuertas.ids: maduros, sobremaduros) y botón de inicio (GPIO 16), SIN hardware.
    python3 -m tests.test_compuertas

  1. Las compuertas quedan en modo posición con su PWM limitado y torque, en el MISMO bus que el brazo (el brazo
     sigue en posición extendida). Sin calibrar no se mueven; calibradas, vaciar = abrir, esperar y cerrar.
  2. Los límites se graban en el servo y no deja pedir un ángulo fuera; una compuerta trabada se informa; si saltó
     una protección, se reinicia y vuelve a tener torque.
  3. armar_reales (tools.mision) arma las compuertas Dynamixel (o las del Mega con compuertas.tipo = "mega").
  4. Botón (gpiozero falso): parte al soltar; un pulso de ruido de 10 ms no cuenta; si al empezar está apretado,
     espera que lo suelten y que lo vuelvan a apretar.
  5. Calibración guiada (tools.compuertas calibrar) con un "usuario" falso que mueve las compuertas a mano: graba
     cerrada, abierta y límites, y la prueba con torque cierra, abre y cierra; si entre cerrada y abierta se pasa por
     0°, esa compuerta no se guarda ni se mueve (el servo daría la vuelta larga).
"""
import sys
import threading
import time
import types

from tests import bus_dxl_falso

falso = bus_dxl_falso.instalar()            # antes de importar cafebot.arm

from cafebot.arm import dxl   # noqa: E402
from cafebot.arm.compuertas import ADDR_MAX_POS, ADDR_MIN_POS, CompuertasDXL, DepositosDXL, grados_a_pasos   # noqa: E402
from cafebot.arm.brazo import PerfilBrazo   # noqa: E402
from cafebot.config import cargar   # noqa: E402

ADDR_MODO, ADDR_PWM, ADDR_TORQUE, ADDR_GOAL, ADDR_HW = 11, 36, 64, 116, 70
M, S = cargar().compuertas.ids          # maduros, sobremaduros


def metas(sid):
    return [v for s, a, v in falso.escrituras if s == sid and a == ADDR_GOAL]


def sin_calibrar(cfg):
    """Las pruebas parten de compuertas sin calibrar (config.py ya trae los ángulos medidos en el robot)."""
    cc = cfg.compuertas
    cc.abierta_deg = cc.cerrada_deg = cc.limites_deg = (None, None)
    return cfg


def nuevo_bus(cfg):
    for sid in cfg.compuertas.ids:
        falso.agregar(sid, 2048)                         # 180°
    perfil = PerfilBrazo.de_fabrica()                    # los ids que tiene el bus falso
    bus = dxl.BusDXL("/dev/falso", perfil.baudios, perfil.servos())
    bus.configurar()                                      # el brazo: posición extendida
    return bus, perfil


def prueba_compuertas(cfg):
    bus, perfil = nuevo_bus(cfg)
    log = []
    cc = cfg.compuertas
    dep = DepositosDXL(cfg, lambda: bus, log=log.append)
    cfg.mision.t_vaciado_s = 0.05
    assert dep.preparar()
    for sid in cc.ids:
        assert falso.leer(sid, ADDR_MODO) == 3 and falso.leer(sid, ADDR_PWM) == cc.pwm_limit
        assert falso.leer(sid, ADDR_TORQUE) == 1
    brazo_ids = [c.id for c in perfil.servos()]
    assert all(falso.leer(s, ADDR_MODO) == 4 for s in brazo_ids), "el brazo cambió de modo"
    assert any("SIN CALIBRAR" in t for t in log)
    n = len(metas(M))
    assert dep.vaciar(0) is False and len(metas(M)) == n           # sin calibrar: no se mueve
    print(f"  ids {cc.ids} en modo posición, PWM {cc.pwm_limit}, con torque; el brazo ({brazo_ids}) sigue en modo 4; "
          "sin calibrar no se mueven")

    cc.cerrada_deg, cc.abierta_deg = (180.0, 180.0), (250.0, 110.0)
    n12, n13 = len(metas(M)), len(metas(S))
    assert dep.vaciar(0) is True and dep.vaciar(1) is True
    assert metas(M)[n12:] == [grados_a_pasos(250), grados_a_pasos(180)], metas(M)[n12:]
    assert metas(S)[n13:] == [grados_a_pasos(110), grados_a_pasos(180)], metas(S)[n13:]
    print("  calibradas: vaciar = abrir (250° / 110°), esperar y cerrar (180°)")
    return bus
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
