MauriceTZ/Cafebot/(commit log)

2026-10-27 Estructura inicial del repo Cafebot
    - firmware/mega_cafebot: firmware v1 del Mega (mismos pines y medidas que v0).
    PI con prealimentación por rueda, encoder x2, parser serial que no bloquea,
    watchdog, primitivas A/W/L/G, modo cangrejo, IR de borde con calibración
    en EEPROM, servos de compuertas.
    - firmware/test_host: el mismo firmware compilado en el PC con una planta
    simulada (pruebas automáticas y modo interactivo).
    - pi/cafebot/drivers: enlace con el Mega y LD06 (CRC, hilo, vueltas completas).
    - pi/tools: teleop y visor del LiDAR. pi/tests: pruebas sin hardware.
    - docs: reglamento, plan para la competencia, protocolo, brazo, hardware.
    - legacy: código anterior del equipo, solo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
    [base_link.stl, brazo1.urdf, brazo1.xacro, codo1_1.stl, codo2_1.stl, codo_1.stl, controller.yaml, garra_1.stl]
2026-10-27 Brazo de mínimo esfuerzo, calibración de servos HS-311, LiDAR frontal
    - pi/cafebot/arm/cinematica.py: IK que elige, entre todas las posturas posibles,
    la que menos carga al servo más exigido (-30 % en la fila baja) y alcanza la
    fila alta inclinando la garra.
    - pi/cafebot/arm/dxl.py: configuración según el manual del XL430 (perfil por
    tiempo, I=0, PWM limitado en la garra, Return Delay 0), monitoreo de
    temperatura/voltaje/errores y reboot tras una protección.
    - Firmware: servos de dirección con writeMicroseconds y tabla -90/0/+90 por
    servo en EEPROM (comandos Y, YS, YG, YD). Antes -90° se recortaba a 0.
    - LD06: configuración para montaje frontal a 8 cm con ~180° de vista.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
    [Servo.h, actuadores.h, cinematica.py, config.h, dxl.py, ld06.py, protocolo.h, sim.cpp]
2026-10-27 Cámara estándar sobre servo de inclinación
    - Firmware: tercer servo auxiliar (X 2 <ángulo>) para inclinar la cámara:
    hacia arriba para el árbol, hacia abajo para cajas y albercas.
    - docs/camara.md: decisión con el Camera Module 3 estándar.
    Claude-Session: https://claude.ai/code/session_012DbN1yGKbvfFoiFyH8uQnT
2026-10-27 Encoders: x1 por defecto, diagnóstico por flanco (ED) y modo en vivo (EM)
    En la prueba real se sospechó que con CHANGE los flancos de bajada restan lo
    que suman los de subida. Eso pasa si A y B no están en cuadratura limpia.
    - Por defecto x1 (solo flanco de subida, exactamente como v0).
    - ED muestra cuánto sumó cada flanco por rueda; EM 1|2 cambia la
    decodificación sin recompilar y se guarda en EEPROM.
    - Pruebas en simulación ampliadas (diagnóstico y cambio a x2).
    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
2026-10-27 Diámetro de rueda calibrado y patrón de giro en coordenadas físicas
    - CINEMATICA_DIAMETRO_RUEDA 53 -> 50,8 mm (A 1000: odometría 997, huincha 955).
    - Con SIGNO_SERVO {+1,-1,-1,+1} (M2 y M3 en espejo) el patrón de giro se
    define en coordenadas físicas. Nueva constante SIGNO_GIRO por si el rombo
    sale invertido.
    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
2026-10-27 config: comentarios de signos de servos según la prueba de W 90
    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
2026-10-27 Separar signo de servos y esquina de cada rueda
    W 90 depende de dos cosas a la vez (hacia dónde gira cada servo y en qué esquina
    está cada rueda); L 90 solo de la primera. Por eso se podía tener un giro
    correcto con un cangrejo equivocado.
    - SIGNO_SERVO se ajusta solo con L 90 200.
    - Nuevas ESQUINA_X / ESQUINA_Y: de ellas salen el rombo del giro, qué ruedas son
    del lado derecho/izquierdo (cinemática y odometría).
    - Simulación probada también con otra asignación de esquinas.
    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
    [actuadores.h, config.h, control.h, sim.cpp]
2026-10-27 config: esquinas de las ruedas verificadas en el robot
    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
2026-10-27 docs/config: verificar signos de servos con L 45 (a 90° no se distinguen)
    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
2026-10-27 config: SIGNO_SERVO = +1 en las 4 ruedas
    Con -1 en las 4, L 45 200 dejaba las ruedas paralelas pero rodando hacia
    adelante-derecha: el sentido es correcto en conjunto, solo invertido.
    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
    [config.h]
2026-10-27 config: servos traseros con signo invertido (+1,+1,-1,-1)
    En W 90 las traseras giraban igual que las delanteras: los servos traseros están
    montados al revés. Con este signo el giro forma el rombo y el cangrejo deja las 4
    ruedas paralelas.
    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
2026-10-27 Servos traseros: cables cruzados y lado derecho en espejo
    Con +1,+1,-1,-1 se observó W 90 = (/ / | \ \) y L 45 = (\ / | / \). La única
    combinación que explica las 8 posiciones: el pin 45 mueve la trasera izquierda y
    el pin 6 la trasera derecha, y los servos del lado derecho están en espejo.
    - M3 (tras. der) = pin 6 / offset 89, M4 (tras. izq) = pin 45 / offset 90.
    - SIGNO_SERVO = -1, +1, -1, +1.
    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
2026-10-27 Servos de dirección: pines 6 y 13 intercambiados, signos +1
    Y 2 1200 (pin 6) movió la delantera derecha. Cruzando las dos rondas de pruebas
    (W 90 y L 45) la única asignación consistente es: pin 6 = delantera der.,
    pin 10 = delantera izq., pin 13 = trasera der., pin 45 = trasera izq., y los 4
    servos con el mismo sentido. También se corrige el dibujo esperado de L 45.
    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
    [config.h]
2026-10-27 Localización inicial con LiDAR: zona de partida, pose, albercas y cajas
    - pi/cafebot/mundo/cancha.py: geometría de la cancha (Apéndices A y B) y sorteo
    de rondas como el reglamento.
    - pi/cafebot/mundo/simulador_lidar.py: trazado de rayos del LD06 con oclusión,
    ruido y "público" fuera de la cancha.
    - pi/cafebot/localizacion/inicio.py: elige la zona de partida y la pose contra
    los árboles, afina con mínimos cuadrados y detecta albercas y cajas.
    100 rondas simuladas: zona correcta 95/100, pose < 3 cm en 94/100; las zonas
    equivocadas siempre salen con confianza baja.
    - tools/localizar.py, tests/test_inicio.py, docs/localizacion.md.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
    [localizar.py, test_inicio.py]
2026-10-27 CLAUDE.md: contexto del proyecto para nuevas sesiones y compañeros
    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
2026-10-27 Pruebas de navegación desde la terminal de la Pi + tolerancias más finas
    - tools/prueba_navegacion.py: recta, giro, cangrejo, cuadrado, ida_vuelta y
    consola del Mega; muestra la pose que cree el robot para compararla con la huincha.
    - Tolerancias de llegada 5 mm -> 2 mm y 1,1° -> 0,4°: los giros se acumulaban
    (cuadrado simulado terminaba a -4°, ahora -0,8°).
    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
2026-10-27 Navegación modular en la Pi: SLAM + EKF + landmarks + A* + interfaz
    Reescritura de legacy/integracion_juan_v1 (ld06_slam_nav_rpi_imu_integrado.py)
    en módulos (pi/cafebot/navegacion/) adaptados al firmware nuevo y al robot real:
    - slam.py: ICP contra la posición media de los impactos (sin el sesgo de media
    celda), espacio libre trazado desde el LiDAR, matriz de información del ICP.
    - odometria.py: EKF con la odometría del Mega (respeta recto/giro/cangrejo) +
    giroscopio opcional con verificación de signo; corrección pesada por la
    información del ICP (en la dirección que el LiDAR no ve, manda la odometría).
    - landmarks.py: clasificación por rectángulo envolvente (pie plano del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
2026-10-28 Misión de la ronda N1→N2→N3 con brazo, visión y compuertas intercambiables
    - mision/mision.py: botón → ubicarse → árbol → foto → recoger por estaciones (cangrejo) midiendo
    el tablero con el LiDAR → entregar de reversa en la caja roja/azul, con reloj de 8 min.
    - Partida dudosa (albercas tapan árboles): va al árbol visible y se reubica con todo el mapa.
    - mision/interfaces.py: contratos Brazo/Vision/Depositos/Boton + versiones simuladas, nulas y GPIO.
    - cancha.py: soportes del Apéndice B, sorteo de granos (Tabla 2) y puntaje (ejemplo del reglamento = 34).
    - tools/mision.py, tecla K en tools/navegacion.py, tests/test_mision.py (35/42/42/42 pts en sim).
    - planificador: la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
    [config.py, interfaces.py, mision.py, navegacion.py, test_mision.py]
2026-10-28 Diámetro efectivo de rueda 52,6 mm (ruedas nuevas, A 1000 midió 102,2/105 cm)
    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
2026-10-28 Escala por rueda (EK) para corregir la desviación de 6 cm a la izquierda
    A 1000 midió 1022 mm atrás-izq y 1050 mm atrás-der: der x1,0135, izq x0,9865.
    Se ajusta en vivo con EK i factor (EEPROM). La planta simulada usa las mismas ruedas.
    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
2026-10-28 Revertir la escala por rueda (EK): tras subirlo, ruedas al revés y sin parar
    Vuelve el firmware de edc9023 (diámetro 52,6 mm). Investigar antes de reintentar.
    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
    [config.h, control.h, encoders.h, protocolo.h, sim.cpp]
2026-10-28 M4 (trasera izq): invertir el motor; tras el cambio de ruedas giraba al revés
    V 80 0 -> ENC 406 400 390 -2424.
    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
2026-10-28 Brazo y cámara reales listos para probar en el robot, conectados a la misión
    Brazo (cafebot/arm/brazo.py + tools/brazo.py):
    - BrazoXL430: IK de mínimo esfuerzo en coordenadas del robot, posturas enseñadas a mano
    (leer + G), secuencia de agarre vigilada (error de seguimiento, carga, garra vacía),
    nunca agarra sin postura de depósito; espera en "descanso" (detrás del frente).
    - dxl.py: ceros normalizados al conectar (modo multivuelta), perfil por velocidad si el
    firmware es < 42, EEPROM solo si cambia (conectar ya no suelta el brazo).
    - Herramienta: salud, leer, grabar, ir, garra, punto, teleop, agarrar, apagar.
    Cámara (cafebot/vision/ + tools/camara.py):
    - Cámara y clasificado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
    [brazo.py, bus_dxl_falso.py, camara.py, clasificador.py, config.py, dxl.py, interfaces.py]
2026-10-28 Puertos reales en la Pi: Mega clon CH340 en ttyUSB1, LD06 en ttyUSB0
    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
2026-10-29 Sensores de línea: 4 QTR-1A analógicos (A8–A11) con umbrales, calibración y cruces en la navegación
    Firmware:
    - ir.h nuevo: un sensor por ms (lectura doble por la alta impedancia del QTR-1A), umbral por
    sensor con histéresis y confirmación, polaridad automática, EEPROM (estructura nueva).
    - Sección de umbrales en config.h (pines, valores de fábrica, histéresis, contraste mínimo).
    - Comandos I, IM (lecturas crudas IRV), IW, IN [k], IA 1/0 (auto mín/máx), IU k v, IH, IG, ID,
    IS 0|1 [máscara]. EVT IR con flancos de subida/bajada y la pose del MOMENTO del cruce.
    - Simulador: entradas A0–A15, inyección "@A pin valor" en modo interactivo y 6 pruebas nuevas.
    Raspberry:
    - meg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
2026-10-29 Sensores de línea en las 4 esquinas, junto a cada rueda; alerta si una rueda entra al perímetro
    Las posiciones por defecto pasan a ser el centro de cada rueda (±111,5 / ±108,5 mm).
    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
2026-10-29 Calibración del brazo sin cámara: perfil por brazo y pasos guiados en tools.brazo
    - Perfil de cada brazo en pi/brazos/<nombre>.json (PerfilBrazo): ids, cero, sentido y
    límites de cada articulación, posturas por nombre e historial con fecha. La misión usa
    brazo.perfil; las posturas del formato anterior (pi/brazo_posturas.json) pasan solas.
    - tools.brazo: escanear (broadcast ping a 1M/57600/115200/2M), identificar (LED uno por
    uno), cero (brazo recto hacia arriba), verificar (sentido de cada articulación: la
    mueve la persona y las demás sostienen), limites (recorrido a mano con margen),
    articulacion (primer movimiento con torque, de a una), garra calibrar (umbral vacía /
    co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
2026-10-29 Sensores de línea: buscar el borde de atrás y el derecho (tools.ir borde)
    Retrocede con el freno de borde solo en TI/TD hasta el borde de atrás, mide cuán torcido
    está (distancia entre el toque de un sensor y el del otro) y se endereza; luego cangrejo a
    la derecha con el freno en DD/TD hasta el borde derecho. Mide blanco y negro de cada sensor
    sobre la huincha y sugiere umbrales (--ajustar los aplica y guarda). Con --sim: esquina
    simulada y robot torcido (--torcido). Prueba nueva en tests.test_ir.
    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
2026-10-29 Cangrejo espejado: a ±90° las ruedas giran dos y dos para cancelar el torque de las L
    Las ruedas están unidas a sus servos con una L de aluminio: al reposicionarse para el
    cangrejo, las 4 giraban hacia el mismo lado y el arrastre sumaba un torque que hacía girar la
    base. A ±90° cada rueda puede quedar a +90 o a −90 (misma línea, motor al revés): ahora dos
    van hacia un lado y dos hacia el otro (patrón diagonal por defecto; LE m prueba 0..3 en vivo,
    CANGREJO_ESPEJO_DEF en config.h). Entre L 90 y L -90 las ruedas ya no se mueven: solo
    cambia el sentido de los motores. La odometría y el PI usan el signo de cada rueda.
    Simulador: modelo del arrastre de las L y pruebas (las 4 igual: +9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
2026-10-29 Recorrido del borde con LiDAR + sensores de línea, y filtro de 45 cm del propio robot en el LiDAR
    - navegacion/bordes.py: primitivas para tocar un borde con un par de sensores (freno de borde
    del Mega), medir cuán torcido está el robot y enderezarse. RecorridoBorde: desde una esquina
    da la vuelta al rectángulo con el borde a la derecha (toca el borde derecho cada 80 cm para
    corregir la deriva), vuelve a la esquina y mide la cancha (rectas ajustadas a los toques) y el
    error de cierre de la odometría y de la pose fusionada con el LiDAR.
    - tools.navegacion: tecla F / --borde, dibujo de toques, rectas, esquinas y rectángulos medidos;
    --taller LxA (con --sim): pista de taller simu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
    [config.py, ir.py, mega.py, navegacion.py, test_borde.py, test_ir.py]
2026-10-29 tools.navegacion: la tecla F fallaba si antes se hizo clic (variable 'recorrido' repetida)
    El arrastre del ratón usaba la misma variable que el recorrido del borde: tras un clic valía
    0.0 y al presionar F se caía al dibujar. Ahora el arrastre se llama 'arrastre'.
    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
2026-10-30 Bordes: al tocar ya no sigue de largo; se endereza retrocediendo y girando
    Antes, si al tocar un borde lo veía un solo sensor, el robot seguía
    avanzando (hasta extra_mm) para que lo tocara el otro: muy torcido, la
    rueda salía de la cancha (la huincha mide 19 mm y el sensor está junto a
    la rueda). Ahora, después del primer toque nunca avanza más: retrocede
    3 cm, gira hacia el sensor que falta y vuelve a tocar despacio; si toca
    primero el otro, se pasó y vuelve con la mitad del giro (bisección),
    hasta que los dos tocan juntos o falta menos de 0,7°.
    Simulado partiendo torcido 5° y 14°: ningún sensor entra más de 13 mm en
    la huincha (test_ir y test_borde vigilan la pose real).
    Co-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
2026-10-30 Cosecha de prueba: cámara + LiDAR + brazo frente a un árbol (tools.cosecha)
    - vision/camara_modelo.py: cámara estenopeica completa (intrínsecos,
    distorsión, pose con inclinación/yaw/roll): proyección y rayos.
    - vision/arbol.py: forma del árbol (competencia o pi/arboles/<nombre>.json)
    y medida del pie con el LiDAR.
    - vision/granos.py: pelotas por color con el círculo ajustado al arco que
    deja ver el soporte (RANSAC sobre la envolvente: < 1 px), asignación a
    los soportes, ajuste de la pose del árbol y de la cámara con el LiDAR
    como prior (fusión), proyección inversa, color por matiz o con
    referencias, calibración de la cámara (con el árbol o con el brazo) y
    aviso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
2026-10-30 Cosecha en el robot: el LiDAR ya no toma basura pegada como el árbol; puertos sin udev
    - medir_pie: sin saber dónde está el árbol lo busca desde 10 cm delante
    del LiDAR e ignora grupos de menos de 3 cm (en el robot tomaba algo a
    ~2 cm del frente: "los granos están a -1 cm de la cámara"). Con --frente
    lo busca alrededor de esa distancia. Cada medida queda en el registro.
    - tools.cosecha: si lo medido no puede ser el árbol, lo dice (y qué
    revisar); los avisos ya no imprimen la traza completa.
    - drivers/puertos.py: si /dev/cafebot-* no existe, Mega, LD06 y U2D2 se
    buscan por el fabricante del chip USB.
    - 99-cafebot.rules: el U2D2 se reconoce solo por el fabricante FTDI.
    Co-Au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
2026-10-30 LiDAR a ~5 cm del suelo (confirmado), no 5 mm
    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
2026-10-30 Brazo rearmado: ceros nuevos (brazo recto, 29 oct)
    Ceros con el brazo recto hacia arriba, leídos con el programa antiguo: base 3085
    (-1011 + 1 vuelta), hombro 2045 (88° distinto del anterior), codo1 3143, codo2
    1532. Las posturas de fábrica (trabajo, descanso) conservan sus ÁNGULOS. La muñeca
    (id 5) no respondió: su cero queda igual [CONFIRMAR]. También en legacy/main.py.
    Las pruebas toman los ceros del código en vez de números fijos.
    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
2026-10-30 Cosecha: encuentra sola la inclinación de la cámara (±30°) y la distancia sin LiDAR
    En el robot (30 oct) la cámara estaba inclinada ~22° y se corrió con
    --inclinacion 0: los soportes se proyectaban una fila más arriba y ninguna
    pelota calzaba (cruces moradas). Con la cámara sin calibrar ahora se busca
    la inclinación en ±30° (y, si el LiDAR no midió el árbol, la distancia en
    ±20 cm de --frente) y se avisa cuál se usó. Con el LiDAR no se toca la
    posición del árbol. Al partir, avisa si el LiDAR no entrega vueltas.
    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
2026-10-30 tools.camara intrinseca: con el mismo foco fijo que la cosecha
    La distancia focal cambia un poco con la posición del lente: calibrarla con
    foco a 0,5 m y usarla con foco a 0,6 m dejaba un error chico pero evitable.
    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
    [camara.py]
2026-10-30 Visión: soporte sin pelota detectada = NEGRO o VACIO, nunca un color saturado
    En la foto del 30 oct (00:43) los 7 soportes vacíos salían AMARILLO/MADURO (la madera
    se parece al amarillo con referencias viejas) y el brazo habría ido a buscarlos.
2026-10-30 tools.ver_camara: cámara en el navegador y calibración intrínseca con vista en vivo
    tools.camara intrinseca es a ciegas (solo terminal). Esta herramienta muestra el video en el
    navegador del PC o celular, dibuja las esquinas del tablero y la parte de la imagen ya cubierta,
    y tiene botones Sacar foto / Calcular que usan las mismas funciones (esquinas_tablero,
    calibrar_intrinsecos, guardar_local) y el mismo foco fijo que la cosecha.
    Probada con 12 fotos sintéticas de focal conocida: fx 1150,6 (real 1150), error 0,26 px.
    [ver_camara.py]
2026-10-30 tools.cosecha: sin Mega, A/R/flechas indican cuánto mover el árbol a mano
    Permite probar el brazo sin mover las ruedas: se corre la pose del pie
    lo mismo que avanzaría el robot.
2026-10-31 Script de Fusion 360 para exportar la geometría del ensamble
    description/fusion/exportar_geometria.py: posiciones de todas las piezas, cuerpos
    (caja y centro de masa), juntas y orígenes de junta en el sistema del ensamble (cm)
    + STL, para sacar del modelo OPEN_CAFEBOT la cámara, sus servos y la base del brazo.
    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
2026-10-31 Cabezal de la cámara (X 2) y medidas del modelo de Fusion
    - Firmware: servos auxiliares 46/11 (compuertas, por confirmar), 44 = inclinación
    de la cámara (PL5, X 2) y 4 = giro (PG5, X 3) desactivado en AUX_ACTIVO porque
    falla; X responde ERR si el servo está desactivado.
    - Config: lente, eje de inclinación y eje de giro de la cámara, base del brazo y
    LiDAR sacados del modelo de Fusion (alturas corregidas por las ruedas de 52,6 mm).
    Relación servo -> inclinación (pitch_servo_90_deg, pitch_por_grado) con
    servo_de_pitch / pitch_de_servo; camara_arbol_deg / camara_cajas_deg obsoletos.
    - CamaraPinhole.desde_config mueve el lente con la inclinación (lente_cabezal).
    - tools.cosech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
2026-10-31 tools.cosecha: U ubica el árbol con el LiDAR tras moverlo a mano; pruebas de la rama de Pablo
    - U (reubicar): vuelve a ubicar el pie solo con el LiDAR, sin foto (sirve de cerca). Sin Mega,
    después de acercar el árbol a mano el mensaje ya no dice "no apretar ESPACIO" sino que U
    corrige lo que no quedó exacto. mover_base y U comparten _corregir_con_lidar.
    - acercar/alejar devuelven si el movimiento resultó.
    - Prueba 4b: soporte vacío cuya madera el clasificador ve AMARILLO -> VACIO (sin la regla
    de Pablo saldría MADURO). Prueba 7c: árbol acercado a mano con 1,5 cm de error -> con U
    el error de los granos baja de ~20 a ~3 mm.
    - docs/camara.md: tools.ver_camara (cámara en el nav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
    [cosecha.py, test_cosecha.py]
2026-10-31 Base del brazo a 35,2 cm (medido) y alcance real del brazo en la misión simulada
    - 31 oct: con el brazo vertical y la garra horizontal, la garra llega a 70 cm del suelo:
    base = 70 − 34,8 = 35,2 cm (el modelo de Fusion decía 31,3). La fila alta (70,7 cm)
    sigue fuera de alcance; con la base a ≥ 37 cm se alcanza.
    - BrazoSimulado acepta alcanzable_fn y tools.mision le pasa BrazoXL430.alcanzable (la
    cinemática y el plan de agarre de verdad, sin bus) en vez de la esfera de 38 cm, que
    era optimista. Semilla 1: 14 puntos con 35,2 cm, 35 con 37 cm.
    - Docs: tabla de alcance, aviso de que la cámara puede estar igual de más alta que en el
    modelo, estado en CLAUDE.md.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
2026-10-31 Perfil del brazo calibrado el 30 oct y explicación de la calibración
    Reconstruido desde las salidas de tools.brazo: muñeca en ID 10, ceros,
    garra invertida, límites y posturas de las canastas.
2026-10-31 Brazo: al encender, la base se lee en la vuelta que cae dentro de su rango
    Los cables dejan girar la base 429° (−76,3..+352,8°, calibración de Pablo), pero al
    encender el servo solo sabe su posición dentro de una vuelta y normalizar_centros
    elegía la más cercana a 0°: con la base pasada de +180° (las canastas están en +177°)
    se leía una vuelta corrida y podía girar hacia el lado que corta los cables.
    - ConfigServo.rango_deg: normalizar_centros elige la vuelta que deja el ángulo dentro
    del rango; si no cae en ninguna (±10°), torque(True) se niega hasta que se gire a mano.
    - PerfilBrazo.recortar_base / ventana_base: un rango de la base de más de 340° se recorta
    a lo que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
2026-10-31 Valores de la Pi perdida en config.py y misión: otra distancia de agarre por fila
    - La SD de la Pi murió: los intrínsecos de la cámara, la garra (0/50/44°) y los umbrales
    de los IR que Pablo dejó en docs/calibracion_brazo.md quedan como valores por defecto
    en config.py (antes vivían solo en robot_local.json). Las pruebas del brazo fijan su
    propia garra.
    - Misión: si un grano no se alcanza desde la distancia actual, se acerca o se aleja a la
    de mision.holguras_agarre_m (6/12/16 cm) desde la que se alcanzan más. Con los límites
    del brazo calibrado y la base a 35,2 cm, la fila baja pide ≥ 12 cm: semilla 1 vuelve de
    7 a 14 puntos (35 con la base a 37 cm).
    - docs/hardware.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
2026-11-04 requirements.txt: numpy, scipy, OpenCV y pygame por apt en la Pi (numpy 2 por pip rompía cv2)
    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
2026-11-04 Ventanas pygame en pantalla completa al lanzarlas por SSH en la pantalla de la Pi
    tools.navegacion, tools.cosecha y tools.visor_lidar abren la ventana en
    pantalla completa cuando se lanzan por SSH y se dibujan en la pantalla HDMI
    de la Raspberry (no con ssh -X). F11 alterna; --pantalla auto|completa|ventana.
    Ctrl+C en la terminal = cerrar la ventana: sale por el camino normal y
    detiene la misión y el robot (un segundo Ctrl+C corta de inmediato).
    El firmware simulado corre en su propia sesión (el Ctrl+C de la terminal no
    lo mata antes de que la Pi detenga el robot) y se cierra sin BrokenPipeError.
    Prueba nueva: tests.test_pantalla. docs: cómo encontrar un numpy 2 en ~/.local.
    Co-Authored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
    [cosecha.py, navegacion.py, pantalla.py, sim_serial.py, test_pantalla.py, visor_lidar.py]
2026-11-04 Vista de la cámara en tools.navegacion (simulada y real) con superposición de la cancha
    Tecla V: la cámara abajo a la derecha del mapa (chica / grande / oculta,
    --vista-camara). En --sim, lo que vería la cámara desde la pose real del
    robot simulado: cafebot/vision/render.py dibuja la cancha, los árboles con
    los granos del sorteo (los que saca el brazo desaparecen), cajas y albercas
    (o la pista de taller) con el mismo modelo de cámara de la visión; sin
    MuJoCo ni OpenGL. En el robot, la cámara de verdad: CamaraCompartida
    (vision/camara.py) es una sola para la vista y la misión, con capturas de a
    una. Shift+V: líneas y soportes donde deberían verse según la pose estimada,
    con el co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
2026-11-04 Misión: modo para cajas del mismo color (mision.cajas: colores / cercana / guardar)
    En la competencia las dos canastas se ven rojas, pero el reglamento puntúa por
    caja roja (maduros) y azul (sobremaduros). Antes, al ver una caja roja la
    misión deducía que la otra era la azul: con las dos rojas eso ya era una
    apuesta escondida a la más cercana.
    - colores (por defecto): como antes, la cámara mira una y la otra es la otra.
    - cercana: sin mirar, maduros a la caja más cercana al volver y sobremaduros a
    la otra (50 %, el viaje más corto); con cajas en más de 2 sectores no apuesta.
    - guardar: no entrega; los granos quedan en el robot (+3/+1) y no se reserva
    tiempo para el viaje.
    --ca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
2026-11-04 Compuertas Dynamixel (id 12 / 13), botón de inicio en el GPIO 23 y servicio de la misión
    Compuertas: id 12 = maduros, id 13 = sobremaduros, en el bus del brazo
    (cafebot/arm/compuertas.py, config.compuertas). Modo posición con PWM
    limitado y los límites grabados en el servo; sin calibrar no se mueven (los
    granos quedan en el robot). Si una se traba se informa, y tras una
    sobrecarga se reinicia y recupera el torque. tools.compuertas: leer,
    soltar, grabar abierta/cerrada, limites, mover y probar. La misión real
    usa DepositosDXL (con el bus del brazo o uno propio) y las prepara antes
    del botón.
    Botón: mision.pin_boton = 23 (pin 16, GND en el 14), pull-up interno.
    Parte al soltar, descart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
2026-11-04 Frente al árbol: la línea del cultivo con los IR delanteros da distancia y rumbo
    Al acercarse al árbol, el robot avanza hasta que DI o DD toca la línea del
    cultivo y sigue despacio hasta que la toca el otro (Bordes.medir_adelante,
    sin bisección: se puede pisar). Con los dos puntos de cruce salen la
    distancia a la línea y el ángulo; gira eso y queda paralelo al tablero.
    Desde ahí la distancia y el ángulo del tablero salen de la línea + la
    odometría (de cerca el LiDAR es menos preciso) y el LiDAR solo da la
    posición lateral del pie. Se repite tras cada cangrejo. No corrige la pose
    global (llevado a la entrega, un error de 0,5° correría la caja). Sin ver
    la línea, todo sigue como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
    [config.py, lidar_simulado.py, mision.py, test_linea_arbol.py, test_mision.py]
2026-11-04 Prueba híbrida: ronda simulada con el brazo real (--sim --brazo)
    tools.mision --sim --brazo y tools.navegacion --sim --brazo --mision: todo
    simulado (cancha, Mega, LiDAR, visión) menos el brazo. El brazo de verdad
    hace cada agarre completo en los puntos que tendría frente al árbol y la
    simulación decide si el grano salió y lleva el puntaje
    (interfaces.BrazoHibrido). La garra cierra en el aire
    (BrazoXL430.prueba_sin_granos).
    Mision.detener() (ESC / Ctrl+C) ahora también para el brazo: termina el
    movimiento en curso y no empieza otro (brazo.detener; preparar() lo
    habilita). tests/sim_serial.compilar() reemplaza el binario de una vez
    (dos simulaciones a la vez ya no fallan con "Text fil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
2026-11-04 Compuertas: calibración guiada (tools.compuertas calibrar)
    Sin torque, a mano: cerrada y abierta con el ángulo en vivo (ENTER), límites
    con margen grabados en la EEPROM del servo y prueba con torque (cierra, abre,
    cierra; avisa si no llega o si sujetándola cerrada empuja un tope). Al final
    imprime las líneas para ConfigCompuertas.
    No hay parámetro de sentido: se graban los ángulos reales. Si entre cerrada y
    abierta se pasa por 0°/360°, en modo posición el servo daría la vuelta larga:
    no se guarda (y una compuerta así cuenta como no calibrada); hay que montar
    el cuerno girado. leer muestra también la carga y el Homing Offset.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
2026-11-04 Puertos: si un ttyUSB pedido es de otro aparato, usar el del chip correcto
    Los ttyUSB cambian de número al reconectar (4 nov: el U2D2 quedó en ttyUSB0, donde
    robot_local.json podía tener el LiDAR). resolver() ahora revisa el chip USB del puerto
    pedido y, si es de otro aparato y hay uno solo del correcto, usa ese y avisa.
    El ejemplo de robot_local.json ya no fija ttyUSB.
    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
    [puertos.py, test_puertos.py]
2026-11-04 Brazo: voltaje mínimo configurable (brazo.volt_min_v = 9,5 V)
    Con la fuente a 10,2 V el brazo no partía (mínimo fijo de 10,5 V). El XL430 funciona
    de 6,5 a 12 V; con menos voltaje solo tiene menos torque.
    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
2026-11-04 brazo1_description en legacy brazo
    [base_link.stl, brazo1.urdf, brazo1.xacro, codo1_1.stl, codo2_1.stl, codo_1.stl, controller.yaml, garra_1.stl]
2026-11-04 Legacy brazo: main.py vuelve a los offsets originales y a la ruta nueva del URDF
    Deshace los ceros del 29 oct en legacy/codigo_brazo/main.py (ortogonal 3088/1042/3074/1546,
    prenderse y apagarse como estaban); main_stress_test.py ya los tenía. URDF_PATH apunta a
    brazo1_description/urdf/brazo1.urdf, como en main_stress_test.py.
    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
2026-11-04 Legacy brazo: la muñeca ahora es el id 10
    En main.py y main_stress_test.py: id 5 -> 10, cero 4054 e invertido (perfil de Pablo,
    30 oct). Prenderse y apagarse con los mismos ángulos de muñeca que antes (531, 745).
    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
2026-11-05 Compuertas: servos cambiados, ids 2 (maduros) y 13 (sobremaduros)
    config.compuertas.ids = (2, 13). tools.brazo escanear reconoce las compuertas
    (ok / no responde / mismo id que el brazo) en vez de marcarlas como servos ajenos.
    Las pruebas toman los ids de la config.
    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
2026-11-05 Compuertas: ángulos medidos (4 nov noche) y diagnóstico si no se mueven
    config.py: maduros (id 2) cerrada 271,1° / abierta 185,7°, sobremaduros (id 13)
    cerrada 3,3° / abierta 81,9°, con sus límites. En la prueba con torque ninguna se
    movió: tools.compuertas ahora dice por qué (torque apagado, meta rechazada, error de
    hardware, modo, posición fuera de una vuelta o PWM bajo).
    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
    [compuertas.py, config.py, test_compuertas.py]
2026-11-05 Compuertas: leer el ángulo cuando termina el movimiento
    mover() miraba 'Moving' a los 50 ms; al partir la velocidad aún es baja, el servo
    decía que estaba quieto y se leía el ángulo de partida: la prueba de calibrar decía
    'no llegó' aunque las compuertas abrían y cerraban bien, y la misión habría dado la
    entrega por fallida. Ahora espera la duración del perfil, como el brazo.
    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
2026-11-05 Brazo: estirarse hacia arriba antes de girar la base
    Al girar, el brazo chocaba con el cabezal de la cámara. Si la base gira más de 10°:
    sube estirado (garra ~38 cm sobre su base), gira arriba y baja a donde iba
    (brazo.giro_alto_m; None = como antes).
    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
2026-11-05 Botón de inicio en el GPIO 16 (pin físico 36), antes GPIO 23
    Claude-Session: https://claude.ai/code/session_012DbN1xsMzDHL5B2mZGB1a1
2026-11-05 Botón: buscar el gpiochip del conector (en la Pi del robot son 11..16 y lgpio no abría el 0/4)
    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
2026-11-05 Botón: buscar el gpiochip sin lgpio y leer con gpioget si lgpio no lo abre
    El sondeo con lgpio (abrir y cerrar cada chip) dejaba /dev/gpiochip15 sin poder
    abrirse de nuevo ('can not open gpiochip'). Ahora el chip del conector se identifica
    con el ioctl GPIO_GET_CHIPINFO; si LGPIOFactory igual falla, el botón se lee con
    gpioget (libgpiod 1.x o 2.x) cada 10 ms.
    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
2026-11-05 Servicio de la misión: activar el .venv, esperar los 3 USB y guardar registro
    correr_mision.sh hace source de .venv/bin/activate, espera el Mega, el LiDAR y el U2D2
    (con o sin reglas udev) y guarda la salida en pi/registros/. instalar_servicio.sh
    --al-encender además lo habilita al arrancar.
    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
2026-11-05 Cámara: límites del cabezal y frente en el punto medio
    Inclinación (X 2) 60..100° y giro (X 3) 50..150°, medidos el 5 nov: el firmware y la Pi
    recortan a eso. Al frente = punto medio: X 2 = 80, X 3 = 100 (al encender). X 2 = 90
    queda en +10°; foto del árbol a +18° (X 2 = 98), cajas a -20° (X 2 = 60, el tope).
    Pruebas de la cosecha adaptadas (y al giro del brazo por arriba). RECARGAR el Mega.
    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
2026-11-05 tools.cabezal: los servos de la cámara hacen un círculo en su rango
    Elipse alrededor del frente (X 2 80 / X 3 100) dentro de 60..100 y 50..150, con la
    cámara en vivo en una ventana, un mosaico (una foto por punto) y un video en
    pi/capturas/. Si el giro está desactivado en el firmware, avisa y solo inclina.
    Vuelve al frente al terminar. --sim prueba el recorrido sin robot.
    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
2026-11-05 Cabezal: calibración manual del frente con el teclado (tools.cabezal calibrar)
    w/s a/d o flechas mueven X 2 / X 3 (1°, mayúscula 5°) con la cámara en vivo y una cruz;
    g guarda 'al frente' en robot_local.json (y ajusta pitch_servo_90_deg). La misión real
    manda X 2 / X 3 al frente al conectarse con el Mega. Giro (X 3) activado en el firmware.
    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
2026-11-05 Cámara: el servo de giro (X 3) está averiado: sin PWM
    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
2026-11-05 Misión: --max-granos para la prueba de cosecha (termina tras N agarres)
    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
2026-11-05 Visión: el árbol de la cancha es verde: ese matiz no cuenta como pelota
    Con el árbol pintado de verde (saturado) toda la copa era una sola mancha y no se detectaba
    ninguna pelota. camara.excluir_h = (38, 90) [AJUSTAR con una foto real]; las pelotas verdes
    quedan fuera (no se recogen nunca).
    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
2026-11-05 Misión: modo cancha reducida (--reducida) para probar la cosecha
    Sin la ubicación con el mapa de la cancha: el robot parte mirando al árbol (<= 90 cm), el
    LiDAR mide el pie en una franja angosta (las paredes de una cancha de 60 cm quedan fuera) y
    se hace como si fuera el árbol 2; a la posición de la foto va recto (sin A*). Nivel 1.
    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
2026-11-05 Árbol real (foto 5 nov): base de 45 cm y verde medido
    - cancha.ARBOL_ANCHO_PIE 0,30 -> 0,45 (Apéndice B: base de 450 x 150 mm; el LiDAR a 5 cm ve la
    base). Con 0,30 tools.cosecha rechazaba la medida del pie ("no midió el centro").
    - arbol.cara_recta: la cara del pie con un ajuste de recta (la banda fija cortaba la punta
    lejana de una cara ancha con el robot girado); la usan medir_pie y la misión.
    - camara.excluir_h = (40, 88): en la foto la copa es H 59–61 (sombras hasta 80), S ~190; el
    tronco y la base café S < 95 no pasan sat_min. Sin excluir, la pelota roja no se detectaba.
    - test_cosecha: umbrales del error con el LiDAR a 0,6–0,8 m de una base ancha (±5 mm).
    Co-Authored-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
    [arbol.py, config.py, mision.py, test_cosecha.py]
2026-11-05 IR calibrados en la cancha
2026-11-06 Misión: --sin-lidar para la prueba en la cancha reducida
    - interfaces.LidarNulo; la navegación arranca el EKF con la odometría si no hay barridos.
    - Sin LiDAR, la foto ubica el árbol (VisionCamara.ubicar_arbol: pelotas detectadas contra los
    soportes, búsqueda fina ±10 cm de lado / ±6 cm de distancia) y corrige la pose; si la foto no
    lo deja claro, no recoge. La distancia exacta la sigue dando la línea del árbol.
    - granos.buscar_lateral (de la rama navegacion-ir). Cámara dibujada: error <= 4 mm.
    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
    [granos.py, interfaces.py, mision.py, vision.py]
2026-11-06 tools.cabezal arbol: ajustar la inclinación de la foto del árbol con los soportes dibujados
    w/s mueve X 2; i/k corrige cuánto mira la cámara por X 2 (pitch_servo_90_deg) hasta que los
    círculos calcen con los soportes reales; g guarda inclinacion_arbol_deg y pitch_servo_90_deg.
    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
    [cabezal.py]
2026-11-06 Visión sin LiDAR: foto anotada (pelotas detectadas y soportes) y detecciones en tools.cabezal arbol
    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
2026-11-06 tools.cabezal arbol: también giro (j/l) y roll (u/o) de la cámara
    La foto del 5 nov muestra la cámara rotada ~6° (roll) y el árbol corrido una columna a la
    izquierda (~10° de giro o 12 cm de lado): se ajustan a ojo con los soportes dibujados.
    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
2026-11-06 Cosecha por pisos: el brazo como ascensor (tools.ascensor)
    - vision/pisos.py: sin modelo de cámara. Copa verde, soportes cafés, los 3 pisos (grilla 5/6/5
    con la copa como referencia y la foto torcida corregida), qué soporte tiene pelota y su color
    por el matiz. Probado con la foto del árbol real y la de la cámara del robot.
    - tools.ascensor: f foto, a acercarse (LiDAR + línea con los IR), p piso (retroceso del piso,
    cangrejo hasta la columna, el brazo sube con la garra abierta), e/c/s/d paso a paso, g agarre,
    r ronda; ajustes en vivo de altura/profundidad/lado por piso y aproximación (t guarda).
    - config.ascensor con las medidas del reglamento; docs/ascensor.md.
    Co-Authored-B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
2026-11-06 Pisos: también el árbol de madera del taller
    La superficie del árbol es el color que más hay al centro de la foto (verde o madera). En la
    madera los soportes son lo gris (borde quemado, hueco, repisa vista por debajo); las sombras
    conservan la saturación y no cuentan. Soportes en el borde del contorno (fila de arriba), paso
    entre columnas sin pedazos de un mismo soporte, emparejado por distancia en la foto. Foto del
    5 nov (árbol café a 55 cm): naranja = media-1, roja = media-2; las dos fotos del árbol verde
    siguen igual.
    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
2026-11-06 Ascensor: foto del árbol de madera con sombras fuertes, --sin-linea y foto siempre a 55 cm
    - pisos: la región del árbol se cierra con un núcleo grande (las sombras la cortaban), pelotas
    también en el borde (fila de arriba), soportes de madera = muy oscuro o gris claro (la sombra
    fuerte queda entre los dos), anillo solo arriba y a los lados, la grilla no castiga un soporte
    que no se ve justo en el borde. VERDE con nombre. Foto del 6 nov (árbol café, 7 pelotas):
    naranja media-1, roja media-2, verde media-3, amarilla alta-1 y baja-1, azul baja-2, roja baja-3.
    - ascensor: si no ve la línea, la distancia es la del reglamento (antes quedaba donde paró, fuera
    de alcance); --sin-l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
2026-11-06 tools.motores: qué motores y encoders de las ruedas quedaron al revés (después de rearmar)
    Ruedas en el aire: 1) cada rueda una vuelta a mano hacia adelante (ED) da el sentido de cada
    encoder; 2) V 60 0 durante 1 s da el de cada motor. Dice qué cambiar en config.h
    (Mx_INV_MOTOR / Mx_INV_ENC) y con --escribir lo cambia; después hay que subir el firmware.
    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
2026-11-06 tools.direccion: sentido y calibración de los servos de dirección con el teclado, sin subir firmware
    La dirección usa la tabla de µs (−90/0/+90) de cada servo en la EEPROM del Mega: un servo que
    quedó al revés al rearmar se corrige intercambiando su −90 y su +90 (tecla x) y guardando (YG).
    Prueba de las 4 a +45° (paralelas con la punta a la izquierda), ajuste fino con flechas.
    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
    [direccion.py]
2026-11-06 Ascensor: la línea del árbol sin pisarla, cangrejos lejos de la cinta y rumbo con la IMU
    - La línea se toca una vez, despacio y sin seguir de largo (Bordes.tocar con bisección; antes
    medir_adelante seguía hasta 6 cm buscando el segundo IR y las ruedas entraban en la cinta), y
    el robot se despega 2,5 cm.
    - Cangrejos con los IR a 7 cm de la línea (las ruedas se corren al girar a ±90°); después avanza
    derecho a la distancia del piso. retocar_cada (0 = nunca) para volver a tocarla.
    - --imu: el giro que la odometría no ve (la base arrastrada al cambiar de postura) se corrige y el
    robot vuelve a cuadrarse con el árbol; si quedó corrido de lado, otro cangrejo corto.
    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
    [ascensor.py, config.py]
2026-11-06 tools.calibrar_cosecha: alturas reales de cada piso y posturas de las canastas internas
    Sin mover la base. pisos: el brazo va al piso (la misma geometría que tools.ascensor: borde de
    la línea + retroceso del piso), se corrige altura / profundidad / lado en vivo, entra, cierra y
    guarda en la sección ascensor. canastas: el brazo va a la postura de cada canasta (pasando por
    arriba), se corrige articulación por articulación o a mano sin torque, se prueba el camino
    completo y se guarda en el perfil del brazo. Probado con el bus Dynamixel falso.
    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
    [calibrar_cosecha.py]
2026-11-06 system/bucle.sh: reejecuta el programa cada vez que termina (bien o con error) hasta que se pare
    Ctrl+C o 'bucle.sh --parar' (desde otro SSH) detienen el programa en curso ordenado (SIGINT) y
    terminan el bucle; espera 2 s entre vueltas (5 s si se cayó al partir); un solo bucle a la vez;
    registro por vuelta y resumen en pi/registros/. instalar_servicio.sh --bucle: el servicio corre
    el bucle (systemctl stop lo termina). Probado con un programa de prueba (fin normal, excepción,
    --parar y Ctrl+C a todo el grupo).
    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
2026-11-06 bucle.sh: el programa siempre recibe Ctrl+C y --parar escala si no se detiene
    Lanzado con & desde un script, el programa heredaba Ctrl+C ignorado y --parar no lo detenía:
    ahora un envoltorio de python le devuelve el efecto normal antes de ejecutarlo. --parar: SIGINT,
    a los 10 s TERM y a los 15 s KILL. Probado: fin normal, excepción, --parar y Ctrl+C al grupo.
    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
2026-11-06 Poses por piso con los IR en la línea: altura, retraída y adelantada
    tools.calibrar_cosecha pisos: con los IR delanteros tocando la línea del árbol se
    ajustan por piso la altura, la x de la garra RETRAÍDA (abierta, antes de entrar) y
    ADELANTADA (lista para cerrar), el lado y la inclinación de la garra. Si no alcanza,
    el ajuste no se aplica y dice con qué entrada e inclinación sí; un piso sin calibrar
    parte de algo que alcance. --mega: l toca la línea sola, como el ascensor.
    tools.ascensor usa esas poses y antes de cada agarre vuelve a tocar la línea y agarra
    ahí (tocar_para_agarrar). brazo.plan_agarre/recoger aceptan aproximacion y pitch_deg.
    Arreglado: x_linea sumaba el sobrepa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
    [ascensor.py, brazo.py, calibrar_cosecha.py, config.py]
2026-11-06 Misión: cosecha por pisos opcional (--cosecha pisos)
    Con --cosecha pisos (mision.cosecha), frente al árbol la misión usa el Ascensor de
    tools.ascensor: el LiDAR cuadra el robot, la foto dice qué pelota hay en cada piso,
    toca la línea antes de cada agarre y usa las poses de tools.calibrar_cosecha; para
    a tiempo para entregar y después entrega como siempre. Por defecto sigue la cosecha
    de antes (soportes); en --sim siempre soportes.
    Probado en simulación (firmware, LiDAR e IR simulados, brazo con bus falso y una
    foto real del árbol): cancha reducida y cancha completa con entrega.
    Claude-Session: https://claude.ai/code/session_01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
2026-11-06 Misión: el botón durante la ronda reinicia (para y cierra; bucle.sh relanza)
    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
2026-11-06 Ascensor --auto --linea-inicio: sale del cuadrado de inicio recto hasta su línea y cosecha; botón reinicia
    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
2026-11-06 Ascensor: vista EN VIVO de la detección por pisos en la pantalla (--vivo FPS)
    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
2026-11-06 Ascensor --linea-inicio: la distancia de la foto desde la línea del árbol (tocarla y retroceder), no la odometría
    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
2026-11-06 Ascensor --auto: el 2º toque del botón para la ronda y vuelve a esperar el botón (sin cerrar el programa)
    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
2026-11-06 Ascensor --auto: reinicio desde cero (odometría del Mega a 0, brazo recogido, todo el estado borrado)
    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
